Naveen-065/Evaluation_Research_Boards-/api_v1/README.md

# Scan-Debug Cell API

This package exposes a reusable Python API and CLI for cell-level scan-debug read, set, reset, and cycle operations.

All source files needed to set up the FPGA, DAC/ADC Teensy, Saleae capture host, and local summarizer are included under:

[prerequisites](./prerequisites)

The API keeps the experiment behavior used in the recent stair-pulse runs:

- every packet programs the FPGA bitstream for the selected cell and mode;
- FPGA asserts Caravel reset before sending the packet;
- read verification uses `Vcc_set=0.5 V`, `Vcc_wl_set=2.5 V` by default;
- set uses `OP_SET=1` and ramps rails until read current crosses the set threshold;
- reset/read polarity uses `OP_SET=0` and ramps rails until read current crosses the reset threshold;
- Saleae A12-A13 is treated as the set shunt current through `shunt_ohms`, default `470 ohms`.

## Realtime GUI

The repo includes a local browser GUI for watching scan-debug runs in realtime. It reads the same `api_v1/runs/*/manifest.csv` files that the API writes, so it can be started while another API command is already running in the background.

Start the GUI from the repo root:

```bash
python api_v1/gui/server.py
```

Then open:

```text
http://127.0.0.1:8765
```

Use the GUI to see:

- the latest API manifest rows as they are recorded;
- a 32 by 32 1Kbit heatmap of the most recent read-packet current value for each cell;
- the last recorded read-packet current and selected cell;
- a blinking marker on the cell currently being read or programmed;
- rising/falling current trends from read packets as records arrive.

By default the GUI is view-only and does not start hardware actions. To also control API commands from the browser, start it with command controls enabled:

```bash
python api_v1/gui/server.py --allow-commands
```

In command-control mode, the GUI can launch `read`, `set`, `reset`, and `cycle` commands through `api_v1/scan_debug_cli.py`. Existing background API processes are not stopped by the GUI; new commands should only be started when the bench is ready for another operation.

## Where This API Runs

The API can run on any macOS, Ubuntu, or Windows PC, but only if that PC can reach the lab hardware control computers over the network.

The API runner is not the timing source. It only orchestrates the experiment. The actual timing-critical scan-debug waveform is generated by the FPGA, and the current/timing capture is done by the Saleae host.

Current lab roles:

| Role | Default host | What it controls |
|---|---|---|
| API runner | your local PC or remote PC | starts read/set/reset commands |
| Zynq/Vivado PC | `geethika@100.116.216.70` | builds/programs AX7020/Zynq FPGA over JTAG |
| Saleae/Teensy Ubuntu PC | `ubuntu-24-04@100.98.132.51` | runs Logic 2 automation and talks to DAC/ADC Teensy |
| Hardware bench | physically connected in lab | Caravel, FPGA, Saleae, DAC/ADC Teensy, shunts |

If the API is run from a new PC outside the lab, that PC must first join the same private network as the two control hosts. The current IPs are private Tailscale-style addresses, so they will not work from the public internet unless the PC is on that same VPN/private network.

## If The User Has Their Own Hardware

The API also supports a user-owned bench. In that case the user does not need the lab Tailscale hosts. They must provide equivalent local or LAN-accessible control machines for these two jobs:

| Job | Requirement |
|---|---|
| FPGA programming | PC with Vivado and JTAG access to the AX7020/Zynq board |
| Capture and rails | PC with Saleae Logic 2 automation running, DAC/ADC Teensy connected, and the Saleae helper script installed |

The Caravel board, FPGA, Saleae, shunts, and DAC/ADC Teensy must be physically wired as described in [Voltage and Probe Connections](#voltage-and-probe-connections). The API cannot discover or compensate for different wiring automatically.

Supported user-owned topologies:

1. **All hardware controlled from one Ubuntu PC**

   Use local execution for both FPGA and Saleae/Teensy by passing empty hosts:

   ```bash
   python api_v1/scan_debug_cli.py read --row 1 --col 0 \
     --zynq-host "" \
     --saleae-host "" \
     --zynq-os posix \
     --zynq-dir /path/to/zynq_scan_debug \
     --vivado-cmd vivado \
     --saleae-dir /path/to/saleae-api \
     --adc-dac-port /dev/serial/by-id/<teensy-port>
   ```

2. **FPGA on one PC, Saleae/Teensy on another PC on the same LAN**

   Replace the default lab hosts with the user's own SSH targets:

   ```bash
   python api_v1/scan_debug_cli.py read --row 1 --col 0 \
     --zynq-host user@zynq-vivado-pc \
     --saleae-host user@saleae-ubuntu-pc \
     --zynq-os windows \
     --zynq-dir C:/path/to/zynq_scan_debug \
     --saleae-dir /path/to/saleae-api
   ```

3. **Lab hardware over Tailscale/private VPN**

   Use the default hosts documented below, but only after joining the same private network.

For a new user-owned bench, copy the files from [prerequisites](./prerequisites) to the corresponding FPGA, Teensy, and Saleae machines first. Then run the dry-run command, verify SSH/local paths, and only then run hardware commands.

## New Remote PC Quick Start

Use this when the user has a fresh remote PC and does not know the lab network setup.

1. Install the required local tools on the API runner PC.

   Ubuntu:

   ```bash
   sudo apt update
   sudo apt install -y git python3 python3-venv openssh-client rsync
   ```

   macOS:

   ```bash
   xcode-select --install
   brew install rsync
   ```

   Windows:

   ```powershell
   winget install Git.Git
   winget install Python.Python.3.12
   ```

   On Windows, use Git Bash or PowerShell. Install `rsync` through Git Bash/MSYS2 if hardware capture copy is needed from Windows.

2. Connect the API runner PC to the lab private network.

   The control hosts use private VPN-style addresses:

   ```text
   100.116.216.70   Windows/Zynq/Vivado PC
   100.98.132.51    Ubuntu/Saleae/Teensy PC
   ```

   These are not normal public internet addresses. If `ping` or `ssh` cannot reach them, install and log in to the lab VPN/Tailscale account first. After joining the network, verify:

   ```bash
   ping 100.116.216.70
   ping 100.98.132.51
   ```

3. Verify SSH access from the API runner PC.

   ```bash
   ssh geethika@100.116.216.70
   ssh ubuntu-24-04@100.98.132.51
   ```

   Recommended: configure SSH keys. Password mode requires `expect` on Ubuntu/macOS
   and Paramiko on Windows.

   Password automation for the Zynq host can be used with a command-line flag:

   ```bash
   --zynq-password <zynq-password>
   ```

   Or set the password in your shell for the current terminal session:

   ```bash
   export SCAN_DEBUG_ZYNQ_PASSWORD='<zynq-password>'
   ```

   After that, hardware commands can omit `--zynq-password`:

   ```bash
   python api_v1/scan_debug_cli.py read --row 1 --col 0
   ```

   On Windows, install the API dependency before using `--zynq-password`:

   ```powershell
   python -m pip install -r api_v1/requirements.txt
   ```

4. Clone this API repo on the API runner PC.

   ```bash
   git clone <repo-url>
   cd Evaluation_Research_Boards-
   ```

5. Run a no-hardware dry run first.

   ```bash
   python api_v1/scan_debug_cli.py read --row 1 --col 0 --dry-run
   ```

   Expected packet:

   ```text
   0x0401
   ```

6. Check the remote hardware hosts are prepared.

   On the Zynq/Vivado PC, this directory must contain the FPGA files:

   ```text
   C:/Users/geethika/zynq_scan_debug
   ```

   On the Ubuntu Saleae host, Logic 2 automation must be running and the Saleae helper must be present:

   ```text
   /home/ubuntu-24-04/saleae-api/run_fpga_scan0000_la12_15_capture.py
   ```

7. Run a hardware read only after the network and hosts are verified.

   Zynq password automation example:

   ```bash
   python api_v1/scan_debug_cli.py read --row 1 --col 0 --zynq-password <zynq-password>
   ```

   SSH-key example:

   ```bash
   python api_v1/scan_debug_cli.py read --row 1 --col 0
   ```

## Authentication and Local Configuration

Do not commit passwords or private keys to this repository. Use SSH keys when possible, or set credentials as environment variables on the API runner PC.

The CLI reads these environment variables when matching command-line flags are not provided:

| Environment variable | Matching flag | Default |
|---|---|---|
| `SCAN_DEBUG_ZYNQ_HOST` | `--zynq-host` | `geethika@100.116.216.70` |
| `SCAN_DEBUG_ZYNQ_PASSWORD` | `--zynq-password` | empty |
| `SCAN_DEBUG_ZYNQ_OS` | `--zynq-os` | `windows` |
| `SCAN_DEBUG_ZYNQ_DIR` | `--zynq-dir` | `C:/Users/geethika/zynq_scan_debug` |
| `SCAN_DEBUG_VIVADO_CMD` | `--vivado-cmd` | `C:/Xilinx/Vivado/2019.1/bin/vivado.bat` |
| `SCAN_DEBUG_SALEAE_HOST` | `--saleae-host` | `ubuntu-24-04@100.98.132.51` |
| `SCAN_DEBUG_SALEAE_DIR` | `--saleae-dir` | `/home/ubuntu-24-04/saleae-api` |
| `SCAN_DEBUG_SALEAE_RESTART_SCRIPT` | `--saleae-restart-script` | `./start-logic2-automation.sh` |
| `SCAN_DEBUG_SALEAE_RESTART_WAIT_SECONDS` | `--saleae-restart-wait-seconds` | `10` |
| `SCAN_DEBUG_DISABLE_SALEAE_USB_RECOVERY` | `--disable-saleae-usb-recovery` | `0` |
| `SCAN_DEBUG_SALEAE_USB_CONTROLLER_PCI` | `--saleae-usb-controller-pci` | `0000:00:0c.0` |
| `SCAN_DEBUG_SALEAE_SUDO_PASSWORD` | `--saleae-sudo-password` | empty |
| `SCAN_DEBUG_ADC_DAC_PORT` | `--adc-dac-port` | `/dev/serial/by-id/usb-Teensyduino_USB_Serial_8829000-if00` |
| `SCAN_DEBUG_DISABLE_DAC_TEENSY_REFLASH` | `--disable-dac-teensy-reflash` | `0` |
| `SCAN_DEBUG_DAC_TEENSY_APP_SERIAL` | `--dac-teensy-app-serial` | `8829000` |
| `SCAN_DEBUG_DAC_TEENSY_BOOTLOADER_SERIAL` | `--dac-teensy-bootloader-serial` | `000D78D4` |
| `SCAN_DEBUG_DAC_TEENSY_LOADER` | `--dac-teensy-loader` | `/home/ubuntu-24-04/teensy-tools-src/teensy_loader_cli_serial/teensy_loader_cli` |
| `SCAN_DEBUG_DAC_TEENSY_MCU` | `--dac-teensy-mcu` | `TEENSY41` |
| `SCAN_DEBUG_DAC_TEENSY_HEX` | `--dac-teensy-hex` | `/home/ubuntu-24-04/teensy-flash/build-DAC_analog_vltgs/DAC_analog_vltgs.ino.hex` |

macOS/Linux example:

```bash
export SCAN_DEBUG_ZYNQ_PASSWORD='<zynq-password>'
python api_v1/scan_debug_cli.py read --row 1 --col 0
```

Windows PowerShell example:

```powershell
$env:SCAN_DEBUG_ZYNQ_PASSWORD = '<zynq-password>'
python api_v1/scan_debug_cli.py read --row 1 --col 0
```

For persistent local settings, store these exports in a local shell profile or an untracked `.env` file. The repository ignores `.env`, `.env.*`, and generated `api_v1/runs/` captures.

## Network Troubleshooting

If a new PC cannot run the API against hardware, check in this order:

1. Can it reach the private network?

   ```bash
   ping 100.116.216.70
   ping 100.98.132.51
   ```

2. Can it SSH to both hosts?

   ```bash
   ssh geethika@100.116.216.70 hostname
   ssh ubuntu-24-04@100.98.132.51 hostname
   ```

3. Can it copy files from the Saleae host?

   ```bash
   rsync --version
   ssh ubuntu-24-04@100.98.132.51 'ls /home/ubuntu-24-04/saleae-api'
   ```

4. Is Logic 2 automation listening on the Ubuntu host?

   ```bash
   ssh ubuntu-24-04@100.98.132.51 'ss -ltnp | grep 10430 || true'
   ```

   If the capture log shows `Connection refused`, `failed to connect to all addresses`,
   or `DeviceSetupFailure`, the API treats Logic 2 automation as crashed or wedged and
   runs the Saleae restart script before the next capture retry. The default restart
   command is:

   ```bash
   ssh ubuntu-24-04@100.98.132.51 'cd /home/ubuntu-24-04/saleae-api && ./start-logic2-automation.sh'
   ```

5. Is the DAC/ADC Teensy visible on Ubuntu?

   ```bash
   ssh ubuntu-24-04@100.98.132.51 'ls -l /dev/serial/by-id/ | grep Teensy || true'
   ```

   If all USB devices disappear from Ubuntu while VirtualBox still shows passthrough,
   the guest xHCI controller may have wedged. Capture retries automatically reset the
   configured xHCI PCI device, restart Logic 2 automation, and retry when logs show a
   missing Teensy serial path, missing Saleae, `LIBUSB_ERROR_BUSY`, or xHCI failure.
   For password-based sudo recovery from the GUI, launch the GUI/API with:

   ```bash
   export SCAN_DEBUG_SALEAE_SUDO_PASSWORD='<ubuntu-sudo-password>'
   ```

   If the DAC/ADC Teensy is still visible but rail writes fail with
   `SerialTimeoutException: Write timeout`, the API treats the DAC Teensy firmware or
   CDC endpoint as wedged. It reflashes only the DAC Teensy by matching app serial
   `8829000` and bootloader serial `000D78D4`, runs a two-command rail smoke test,
   and retries the capture. This is separate from the xHCI recovery above because the
   USB device can be present while serial writes are still broken.

6. Is Vivado/JTAG working on the Zynq PC?

   ```bash
   ssh geethika@100.116.216.70 'cd C:/Users/geethika/zynq_scan_debug && powershell -NoProfile -Command "Test-Path C:/Xilinx/Vivado/2019.1/bin/vivado.bat"'
   ```

## Python

```python
from api_v1 import ScanDebugCellAPI

api = ScanDebugCellAPI()
read = api.read(row=5, col=0)
set_summary = api.set_cell(row=5, col=0)
reset_summary = api.reset_cell(row=5, col=0)
```

## CLI

Dry-run command, safe on Windows or Ubuntu:

```bash
python api_v1/scan_debug_cli.py read --row 5 --col 0 --dry-run
```

Hardware-backed set sweep:

```bash
python api_v1/scan_debug_cli.py set --row 5 --col 0 \
  --set-vcc-set 1.6,2.0,2.3,2.4,2.5,2.8 \
  --set-vcc-wl-set 0.5,0.6,0.7,0.8,0.9,1.0,1.1,1.2,1.3,1.4,1.5,1.6,1.7,1.8,1.9,2.0 \
  --set-threshold 200.0
```

Hardware-backed reset sweep:

```bash
python api_v1/scan_debug_cli.py reset --row 5 --col 0 \
  --reset-vcc-set 3.3,3.4,3.5,3.6,3.7 \
  --reset-vcc-wl-set 1.0,1.2,1.4,1.6,1.8,2.0,2.2,2.3 \
  --reset-threshold 130.0
```

Default 32 by 32 array read:

```bash
python api_v1/scan_debug_cli.py read-array
```

This uses column-by-column burst mode by default. For each column, the API programs one FPGA sequence bitstream, the FPGA sends all row packets for that column with a Caravel reset before every packet, and the Saleae helper captures one continuous trace for the whole column. The helper then decodes all packet/current windows into the normal `manifest.csv`, so the GUI heatmap updates after each column.

One-shot full-array burst is still available from the CLI:

```bash
python api_v1/scan_debug_cli.py read-array --array-mode burst
```

Prebuild and cache all column-burst FPGA bitstreams into the tracked bitstream folder:

```bash
python api_v1/scan_debug_cli.py build-array-bitstreams
```

Old per-cell behavior is still available:

```bash
python api_v1/scan_debug_cli.py read-array --array-mode serial
```

The older Saleae rearm/export loop can also be used with the burst-column FPGA sequence:

```bash
python api_v1/scan_debug_cli.py read-array --burst-capture-strategy per-cell --burst-repeat-cycles 10000000
```

Full burst mode supports the full 32 by 32 array and publishes after final decode. Serial mode publishes after each individual cell read.

## Cross-Platform Notes

The API itself is pure Python and runs on macOS, Ubuntu, or Windows. Hardware access uses external tools:

- `ssh` and `rsync` must be available on the machine running the API.
- For Windows Zynq programming, the remote side uses PowerShell plus Vivado.
- For Ubuntu/local Zynq programming, set `--zynq-os posix`.
- Prefer SSH keys or an existing SSH agent.
- `--zynq-password ...` uses `expect` on Ubuntu/macOS and Paramiko on Windows. SSH keys remain recommended.
- Remote Saleae captures use `rsync` when it is on `PATH`, with an automatic `scp` fallback (including Windows OpenSSH).

## Required Files

FPGA files copied into this API folder:

- [prerequisites/fpga_zynq7020/caravel_scan_debug_fpga.v](./prerequisites/fpga_zynq7020/caravel_scan_debug_fpga.v)
- [prerequisites/fpga_zynq7020/caravel_scan_debug_fpga.xdc](./prerequisites/fpga_zynq7020/caravel_scan_debug_fpga.xdc)
- [prerequisites/fpga_zynq7020/program_scan_debug_zynq7020.tcl](./prerequisites/fpga_zynq7020/program_scan_debug_zynq7020.tcl)
- [prerequisites/fpga_zynq7020/program_prebuilt_bitstream.tcl](./prerequisites/fpga_zynq7020/program_prebuilt_bitstream.tcl)
- [prerequisites/fpga_zynq7020/bitstreams](./prerequisites/fpga_zynq7020/bitstreams) contains backed-up `.bit` files for reboot recovery.

Teensy DAC/ADC firmware copied into this API folder:

- [prerequisites/teensy_dac_adc/DAC_analog_vltgs.ino](./prerequisites/teensy_dac_adc/DAC_analog_vltgs.ino)
- [prerequisites/teensy_dac_adc/DAC_read.h](./prerequisites/teensy_dac_adc/DAC_read.h)
- [prerequisites/teensy_dac_adc/MovingAverageFilter.h](./prerequisites/teensy_dac_adc/MovingAverageFilter.h)
- [prerequisites/teensy_dac_adc/ads12xx.h](./prerequisites/teensy_dac_adc/ads12xx.h)
- [prerequisites/teensy_dac_adc/sync_slave.ino](./prerequisites/teensy_dac_adc/sync_slave.ino)

Saleae Ubuntu capture helper:

- [prerequisites/saleae_ubuntu/run_fpga_scan0000_la12_15_capture.py](./prerequisites/saleae_ubuntu/run_fpga_scan0000_la12_15_capture.py)
- [prerequisites/saleae_ubuntu/run_full_array_burst_capture.py](./prerequisites/saleae_ubuntu/run_full_array_burst_capture.py)

Local summarizer used by the API:

- [tools/summarize_capture.py](./tools/summarize_capture.py)

## Setup Checklist

1. Copy FPGA prerequisite files to the Zynq/Vivado working directory.

   Default API path:

   ```text
   C:/Users/geethika/zynq_scan_debug
   ```

   Required files in that directory:

   ```text
   caravel_scan_debug_fpga.v
   caravel_scan_debug_fpga.xdc
   program_scan_debug_zynq7020.tcl
   ```

   The API generates per-packet Vivado build TCL files and bitstreams in this same directory.

2. Flash the DAC/ADC Teensy with:

   ```text
   prerequisites/teensy_dac_adc/DAC_analog_vltgs.ino
   ```

   Keep the companion headers/sketch files in the same Arduino sketch folder.

3. Copy the Saleae helper to the Ubuntu Saleae API directory.

   Default API path:

   ```text
   /home/ubuntu-24-04/saleae-api/run_fpga_scan0000_la12_15_capture.py
   ```

   Required Ubuntu Python packages/environment:

   ```text
   saleae automation package
   pyserial
   rsync
   ssh server/client
   existing caravel utility environment, if HK reset mode is used
   ```

4. Start Logic 2 automation on Ubuntu before running hardware commands.

   The API expects Logic automation listening on:

   ```text
   127.0.0.1:10430
   ```

5. Confirm the DAC/ADC Teensy serial path.

   Default API path:

   ```text
   /dev/serial/by-id/usb-Teensyduino_USB_Serial_8829000-if00
   ```

   Override with:

   ```bash
   --adc-dac-port /dev/serial/by-id/...
   ```

## Voltage and Probe Connections

Rails controlled by the DAC/ADC Teensy firmware:

| Rail | Caravel/Chip node | DAC channel in current firmware | API default / behavior |
|---|---:|---:|---|
| `Vcc_read` | GPIO33 | DAC[0] | held `0 V` in `SCAN_CUSTOM_RAILS` |
| `Vcc_wl_read` | GPIO26 | DAC[1] | held `0 V` in `SCAN_CUSTOM_RAILS` |
| `Vcc_set` | GPIO27 | DAC[6] | ramped by API |
| `Vcc_wl_set` | GPIO30 | DAC[3] | ramped by API |
| `Vcc_wl_reset` | GPIO28 | DAC[4] | held `0 V` in `SCAN_CUSTOM_RAILS` |
| `Vcc_reset` | VDDA2 | DAC[5] | held `0 V` in `SCAN_CUSTOM_RAILS` |
| `VDDA1` | VDDA1 | DAC[14] / external supply as configured | not changed by API |
| `VDDC2` | VCCD2 | DAC[15] | not changed by API |

Current probes:

| Measurement | Saleae analog channels | Shunt |
|---|---:|---:|
| Set shunt current | A12 - A13 | default `470 ohms` |
| Reset shunt current | A14 - A15 | default `470 ohms` |
| ADC set monitor | A0 - A1 | firmware monitor |
| ADC read monitor | A2 - A3 | firmware monitor |
| ADC reset monitor | A4 - A5 | firmware monitor |

FPGA to Caravel and Saleae digital probes:

| Signal | Caravel node | FPGA J10 / Zynq pin | Saleae LA |
|---|---|---|---:|
| `wb_clk_i` / XCLK | Xclk | J10-16 / U14 | 8 |
| `rst_b` | Reset | J10-3 / W19 | 7 |
| `ready` | GPIO1 | J10-4 / W18 | 6 |
| `TM` | GPIO36 | J10-5 / R14 | 9 |
| `ScanInDR` | GPIO21 | J10-9 / W15 | 11 |
| `ScanInDL` | GPIO22 | J10-7 / Y17 | 10 |
| `ScanInCC` | scan clock/control | J10-8 / Y16 | optional |

The FPGA RTL changes scan data/control on the falling edge of `wb_clk_i`. Caravel samples on the rising edge.

## Packet Format

Packets are encoded as:

```text
{OP_SET, SL_SEL[4:0], BL_SEL[4:0], WL_SEL[4:0]}
```

The present hardware mapping uses `row -> SL_SEL/WL_SEL` and `col -> BL_SEL`.

Examples:

- cell `(1,0)` read: `0x0401`
- cell `(4,0)` read: `0x1004`
- cell `(10,10)` read: `0x294a`
- cell `(5,0)` set: `0x9405`
