Naveen-065/Evaluation_Research_Boards-/FMC_Eval_Board/output/j2_clock_50mhz/J2_50MHz_clock_report.html

# Existing J2 clock circuit at 1.8 V and 50 MHz

Clock-only conclusion: no solder changes are required to create a plausible bench-test configuration. Keep C60, C61 and R165. Drive J2 D8 with a 50 MHz LVCMOS18 clock and J2 D9 actively LOW. Configure the ADC differential clock receiver. This supersedes the earlier claim that C60 must be rewired or an external LVDS driver is always needed.

Simulation supports a candidate, not a verified working board. 225 completed ngspice sensitivity runs; numerical checks passed: True. No Kintex IBIS or ADC comparator/PLL model was available. Some assumed line/startup cases exceed ADC voltage limits, so this is not unconditional connection approval. The clock input, 300 MHz return clock, 600 Mbit/s data and remaining power/I2C faults still need validation.

BOM checked inside the original ZIP: jlcpcb/production_files/BOM-CaravelReRAM-SenseEval.csv line 28 lists C60/C61 as LCSC C49062, Samsung CL03A104KP3NNNC, 100 nF, 10 V, X5R, +/-10%, 0201. Line 48 lists R165 as LCSC C25076, UNI-ROYAL 0402WGF1000TCE, 100 ohms, +/-1%, 0402. These procurement values match the simulation; the physical assembly has not been inspected. The BOM uses footprint names in its Comment column, so part numbers were checked against the supplier catalog.

## Existing copper and configuration

FPGA AE23 / J2 D8 ---+--- C61 100 nF --- ADC U14.58 CLKP
                    |
                 R165 100 ohms
                    |
FPGA AF23 / J2 D9 ---+--- C60 100 nF --- ADC U14.59 CLKN
  driven LOW

ADC DIFF_CLK=1: each clock pin has internal 5 kohm bias to about 1.5 V.

The low-driven D9 supplies the reference through C60. It has finite output impedance, so R165 causes some CLKN ripple. D9 must not be left floating. These are two ordinary LVCMOS18 output buffers, not a native LVDS output.

1. Set and verify KC705 VADJ at 1.8 V. XDC does not set the physical rail.
2. Use LVCMOS18 on both outputs. DRIVE=24 is supported by the HR bank. SLEW=SLOW is an initial bench choice; the generic simulation is not tied to a Vivado DRIVE/SLEW setting.
3. ADC register 0x42=0x8001 with other fields default selects DIFF_CLK=1. 0x8003 also enables duty-cycle correction. Default DIFF_CLK=0 is unsuitable with this AC-coupled topology.
4. Hold the clock LOW until both boards and the ADC configuration are ready. Then start continuous 50 MHz clocking. Allow approximately 5 ms for nominal AC-bias settling before evaluating capture; verify actual settling.

Illustrative integration files: ODDR/OBUF Verilog and clock-only XDC fragment. These are not compiled or timing-closed complete designs.

## Nominal simulation results

Model: ideal 1.8 V source, 25 ohms resistance per FPGA output, 1 ns transitions, 100 nF coupling, 5 kohm ADC bias to 1.5 V, assumed 5 pF per ADC input, no transmission line in this table. The 25 ohms value is illustrative; it does not represent a verified DRIVE=24 buffer.

Case | Differential LOW / HIGH plateaus | CLKP range | CLKN range
Keep PCB; D9 actively LOW | -0.598 / 0.598 V | 0.753 to 2.247 V | 1.351 to 1.649 V
Keep PCB; D9 floating | -0.020 / 0.020 V | 0.609 to 2.391 V | 0.626 to 2.374 V
Remove R165 only; D9 actively LOW | -0.895 / 0.896 V | 0.605 to 2.396 V | 1.500 to 1.500 V

With the existing circuit, the simple resistor calculation gives 12 mA through R165 during the high half-cycle and about 1.2 V peak-to-peak differential clock. The unattenuated static upper bound at 1.89 V and 99 ohms is about 19.1 mA. DRIVE is not a current limiter; transient currents differ.

Floating D9 can produce impressive-looking edge spikes while the settled differential plateaus approach zero. Peak-to-peak amplitude alone must not be interpreted as valid clock drive.

Three simulated clock topologies comparing ADC input and differential waveforms

## Startup, pauses and line sensitivity

With 100 nF and 5 kohms, the nominal bias time constant is about 0.5 ms. Short steady-state simulations use analytically initialized capacitor charges. Separate runs model the first edges after a long LOW or HIGH pause. They do not simulate the board power sequence or claim the bias settles in 420 ns.

Generic sweeps use output resistance 10/25/60 ohms, supply 1.71/1.89 V, bias 1.425/1.575 V, and additional assumed 50-ohm line ladders with 0.5/1.5 ns delay, 0.5/2 ns edges and 2 ohms total trace loss. These are sensitivity ranges, not vendor PVT corners.

Topology | Model group | Lowest CLKP | Highest CLKP
existing_low | lumped_sensitivity | -0.350 V | 3.350 V
existing_low | assumed_line_sensitivity | -0.946 V | 3.921 V
remove_r165 | lumped_sensitivity | -0.461 V | 3.461 V
remove_r165 | assumed_line_sensitivity | -1.787 V | 4.788 V

Do not treat these extreme hypothetical numbers as predictions of the PCB. They expose why driver and routing information matter. Compare measured clock pins with their voltage limits throughout start/stop. Removing R165 increases clock amplitude and can worsen ringing and restart excursions; removal is not automatically safer or necessary.

## Minimum physical work for the complete interface

Clock path: zero changes for the first controlled trial. The complete FMC interface is a separate matter. At VCCO=1.8 V, use LVDS_25 input receivers with DIFF_TERM=FALSE and external receiver termination. The five data pairs and two returned-clock pairs need their 100-ohm termination solution. PCB pad connectivity confirms each receive net connects only U14 and J9, with no resistor pads. R165 does not terminate those signals. Put the termination at the FPGA receiving end; a resistor placed arbitrarily far away on the card is not equivalent.

Retain the earlier power audit requirements: NT25 must not join the independently powered 3.3 V regulators; management I2C remains a 3.3 V bus; verify U18/pullup corrections and avoid driving an unpowered FPGA. This clock analysis does not clear these issues or the incomplete FMC ground returns.

## Bench acceptance sequence

1. With both boards disconnected and unpowered, confirm C60/C61 and R165 population and the independent power/I2C corrections. Verify external return-pair terminations.
2. Verify the KC705 1.8 V startup setting with the card disconnected. Use the full audited power sequence; mate only with both boards unpowered.
3. With both sides valid, set DIFF_CLK=1, hold D9 LOW, then start D8 clock. Begin at 10 MHz if desired, then test the requested 50 MHz.
4. Probe CLKP and CLKN at the ADC with suitable low-capacitance probes. Do not attach a 50-ohm scope input directly to either ADC clock pin. Record startup, steady state, stop and restart; examine each pin and their difference, duty cycle, and extra zero crossings.
5. ADC absolute digital-input limits are -0.3 V to min(3.9 V, AVDD+0.3 V); stay comfortably inside, including ringing. These are damage limits, not a functional clock guarantee. A 1.2 Vpp result is a model expectation, not a prescribed acceptance threshold.
6. After bias settling, check the ADC output test pattern and frame alignment. At 50 MSPS the returned LCLK is 300 MHz and each serialized channel is 600 Mbit/s. Verify error-free capture for the application and sweep phase/timing margins; decimation follows capture.
7. Then compare a known analog input before/after decimation for noise and distortion. SPICE here cannot predict clock jitter or final SNR.

## Evidence and reproducibility

- TI ADS5282, pages 3, 23 and 35 (https://www.ti.com/lit/ds/symlink/ads5282.pdf): clock modes and internal bias.
- AMD DS182, Table 9 (https://docs.amd.com/v/u/en-US/ds182_Kintex_7_Data_Sheet): LVCMOS18 HR 24 mA drive option.
- AMD UG471 (https://docs.amd.com/v/u/en-US/ug471_7Series_SelectIO): input-only LVDS at other VCCO, termination requirements.
- LCSC C49062 capacitor (https://www.lcsc.com/product-detail/C49062.html); LCSC C25076 resistor (https://www.lcsc.com/product-detail/C25076.html): resolution of BOM part-number values.
- All numerical results and assumptions; summary CSV; simulation script; netlists/ and logs/ contain every case.
- Clock sources are ideal 0-VCCO square waves with 1ns edges unless stated.
- FPGA pull-up and pull-down represented by fixed resistances; not mapped to DRIVE settings.
- ADC differential clock mode modeled as 5k bias per leg; capacitance assumed 5pF.
- C60/C61 assumed 100nF; R165 assumed 100ohm, per schematic intent.
- No ADC threshold/comparator/PLL model, noise, jitter, clamp, thermal or package model.
- Some tests add assumed uncoupled 50ohm LC line ladders with 2ohm total trace loss, not extracted routing.
- Initial capacitor charges describe periodic steady state or long settled idle.
- No valid conversion, firmware capture or fabricated-board safety guarantee follows.

Run UTC: 2026-10-17T18:13:35.819303+00:00. Source PCB SHA256: fdca0330dc568658c43d27be3abe488d13d14b2eec15ef8ff8d3f24107006200. Source design and physical hardware were not changed.
