Naveen-065/Evaluation_Research_Boards-/FMC_Eval_Board/output/adc_lvds_10msps/input_clock/input_clock_comparison.png

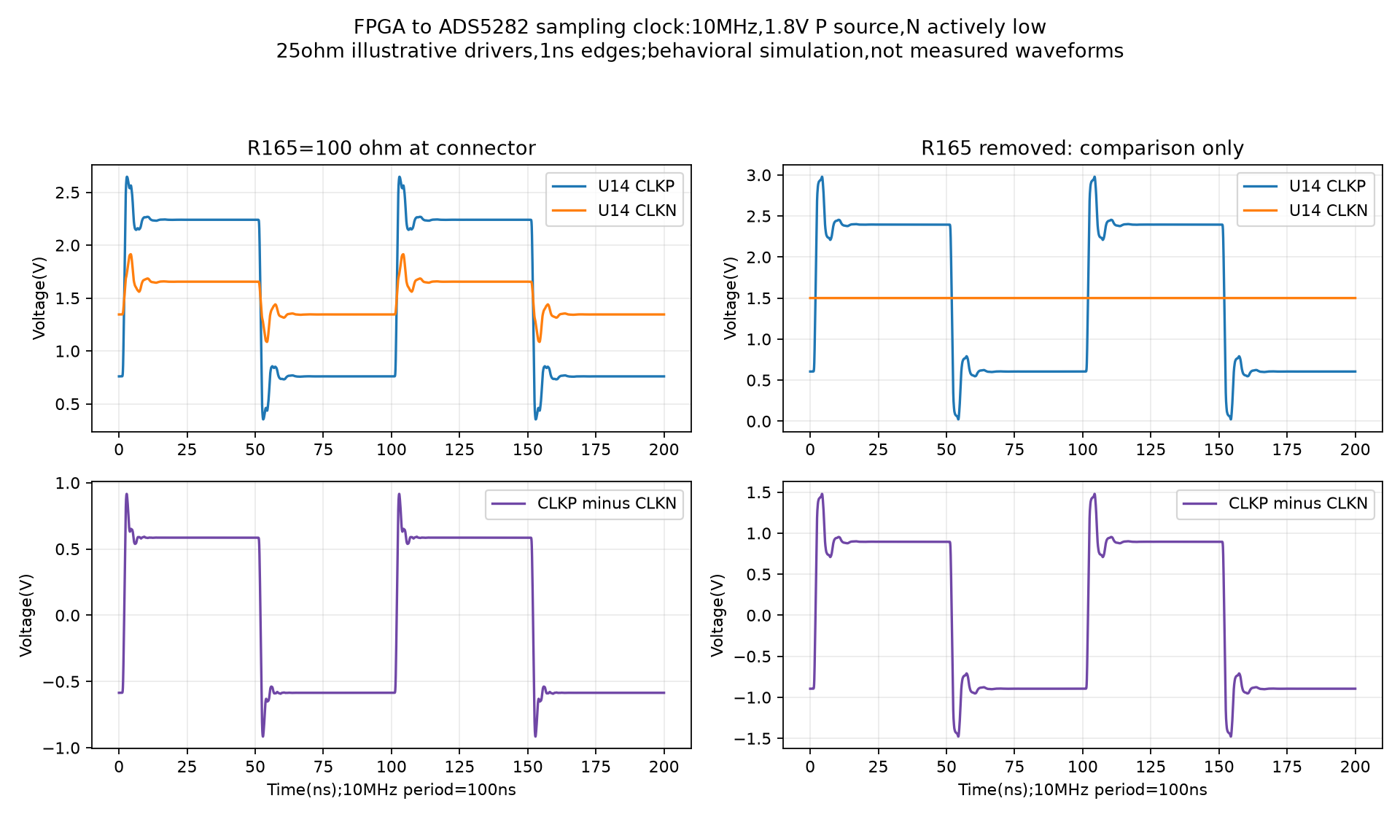
FMC_Eval_Board/output/adc_lvds_10msps/input_clock/input_clock_comparison.png
