Naveen-065/Evaluation_Research_Boards-/FMC_Eval_Board/output/adc_lvds_10msps/termination_comparison.png

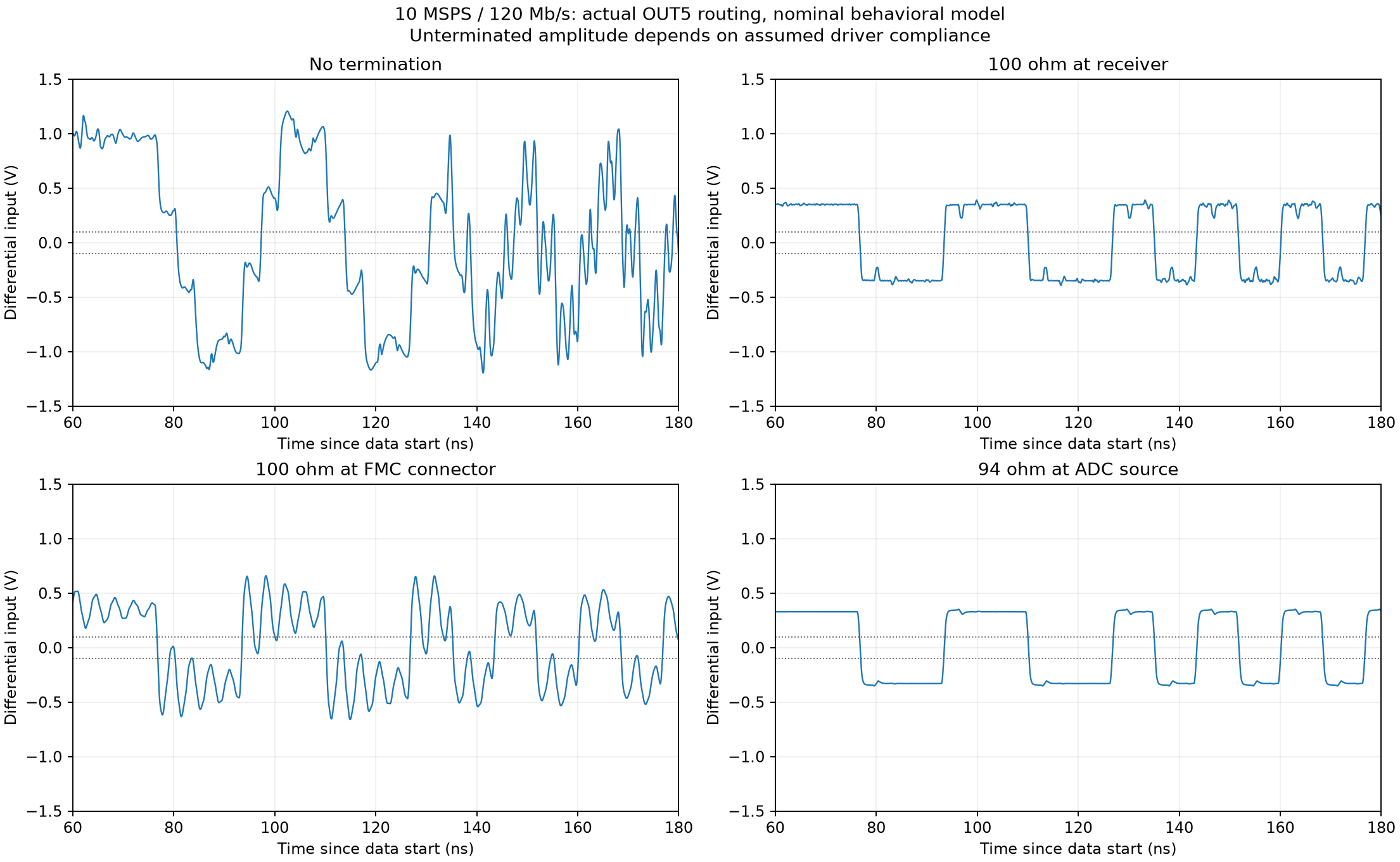
FMC_Eval_Board/output/adc_lvds_10msps/termination_comparison.png
