Naveen-065/Evaluation_Research_Boards-/FMC_Eval_Board/output/ain1_r9_validation/u10_schematic.png

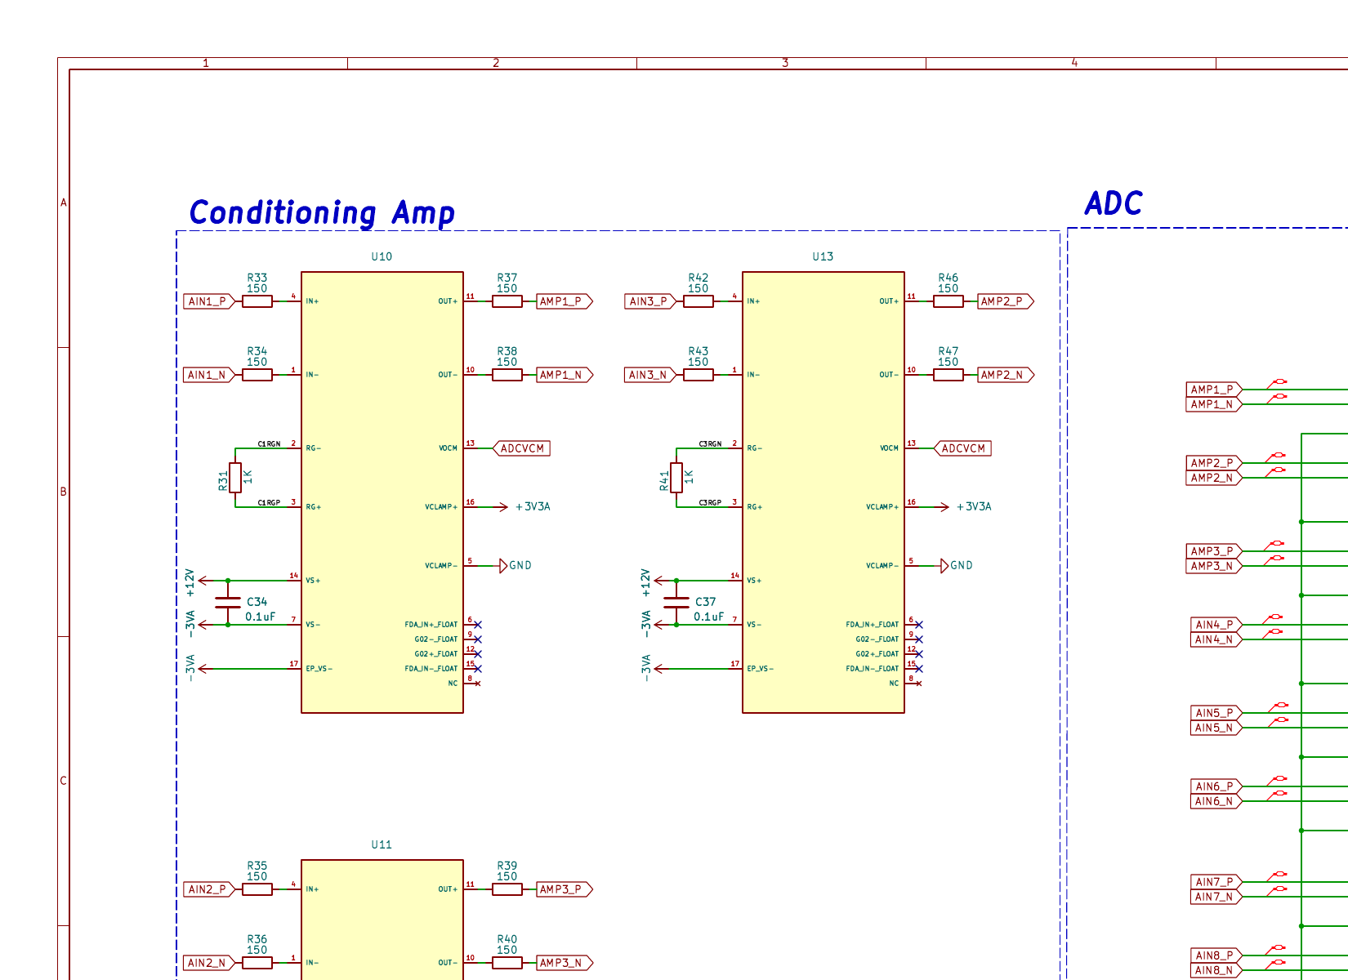
FMC_Eval_Board/output/ain1_r9_validation/u10_schematic.png
