Naveen-065/Evaluation_Research_Boards-/FMC_Eval_Board/output/dac_reference_audit/u1_reference_layout.png

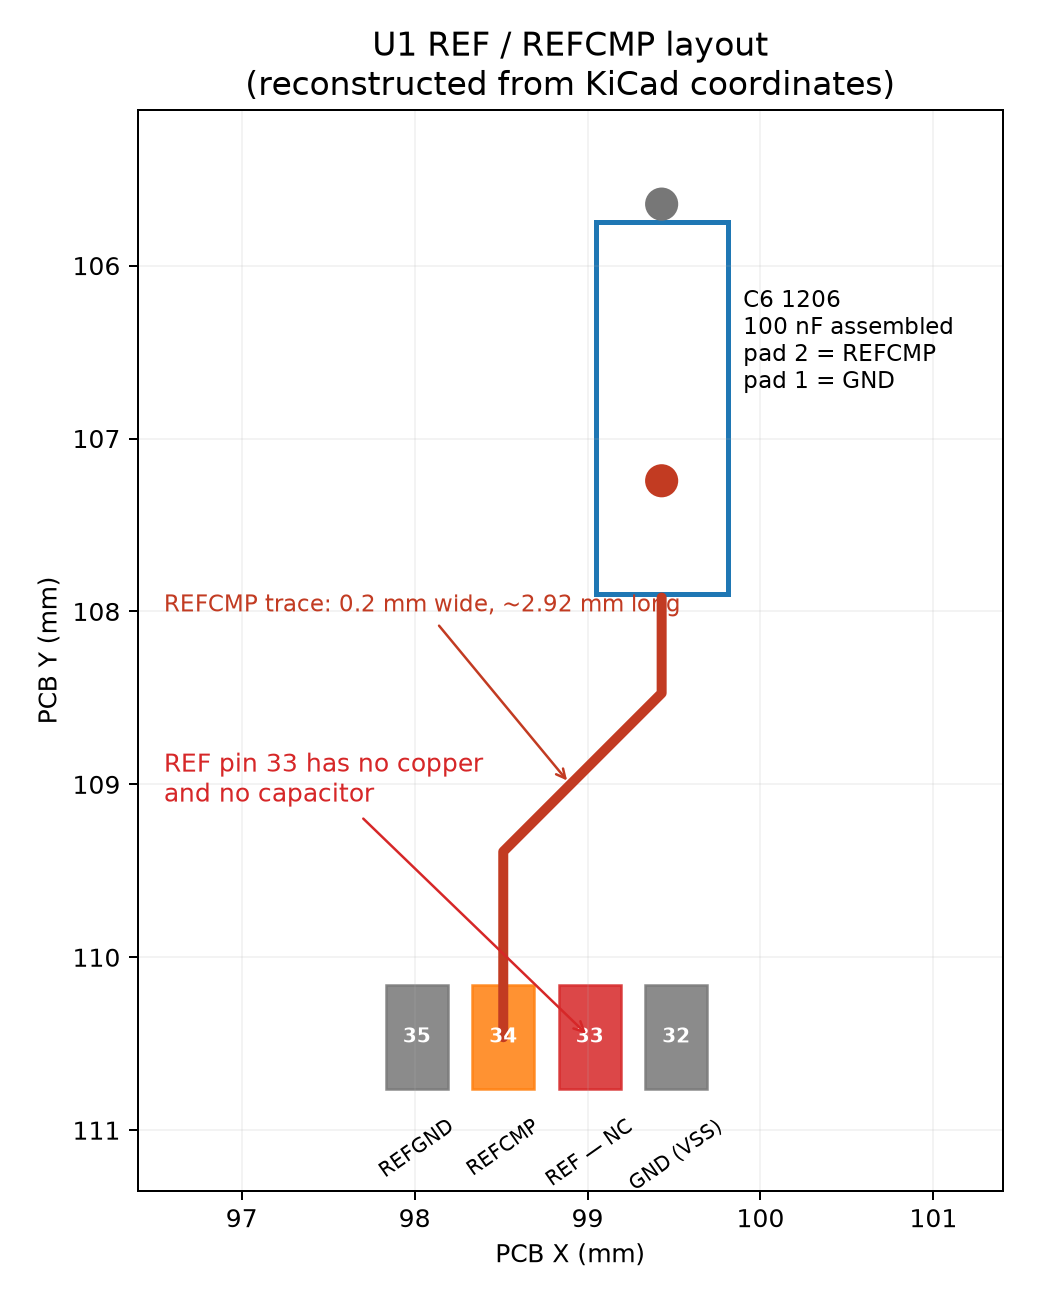
FMC_Eval_Board/output/dac_reference_audit/u1_reference_layout.png
