Naveen-065/Evaluation_Research_Boards-/FMC_Eval_Board/output/j9_c30_c31/j9_bottom_full.png

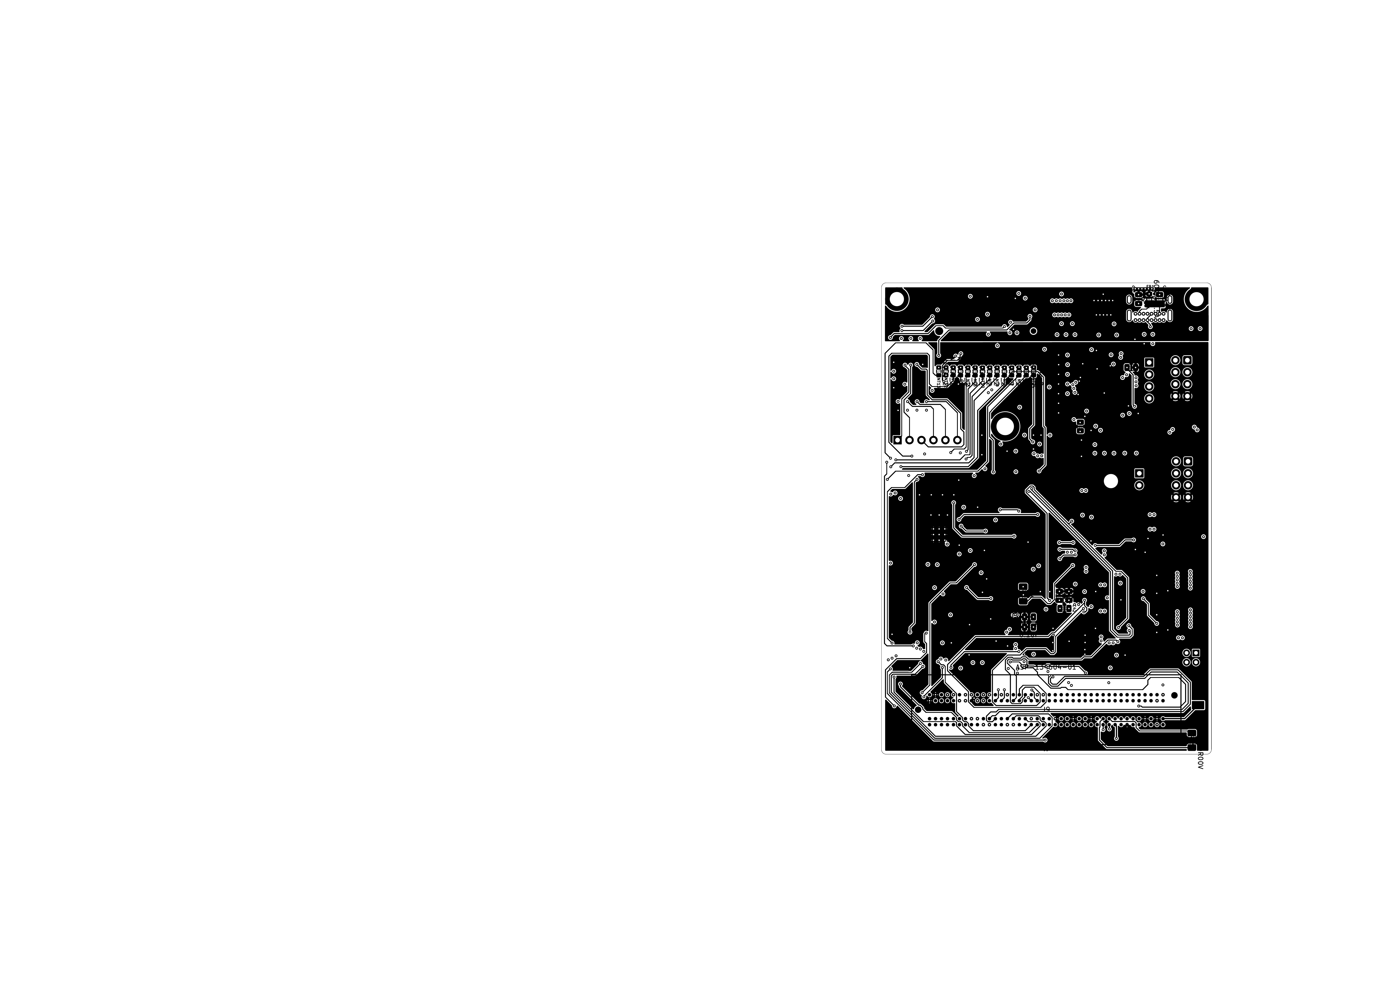
FMC_Eval_Board/output/j9_c30_c31/j9_bottom_full.png
