Naveen-065/Evaluation_Research_Boards-/FMC_Eval_Board/output/j9_c30_c31/J9_C30_C31_annotated.png

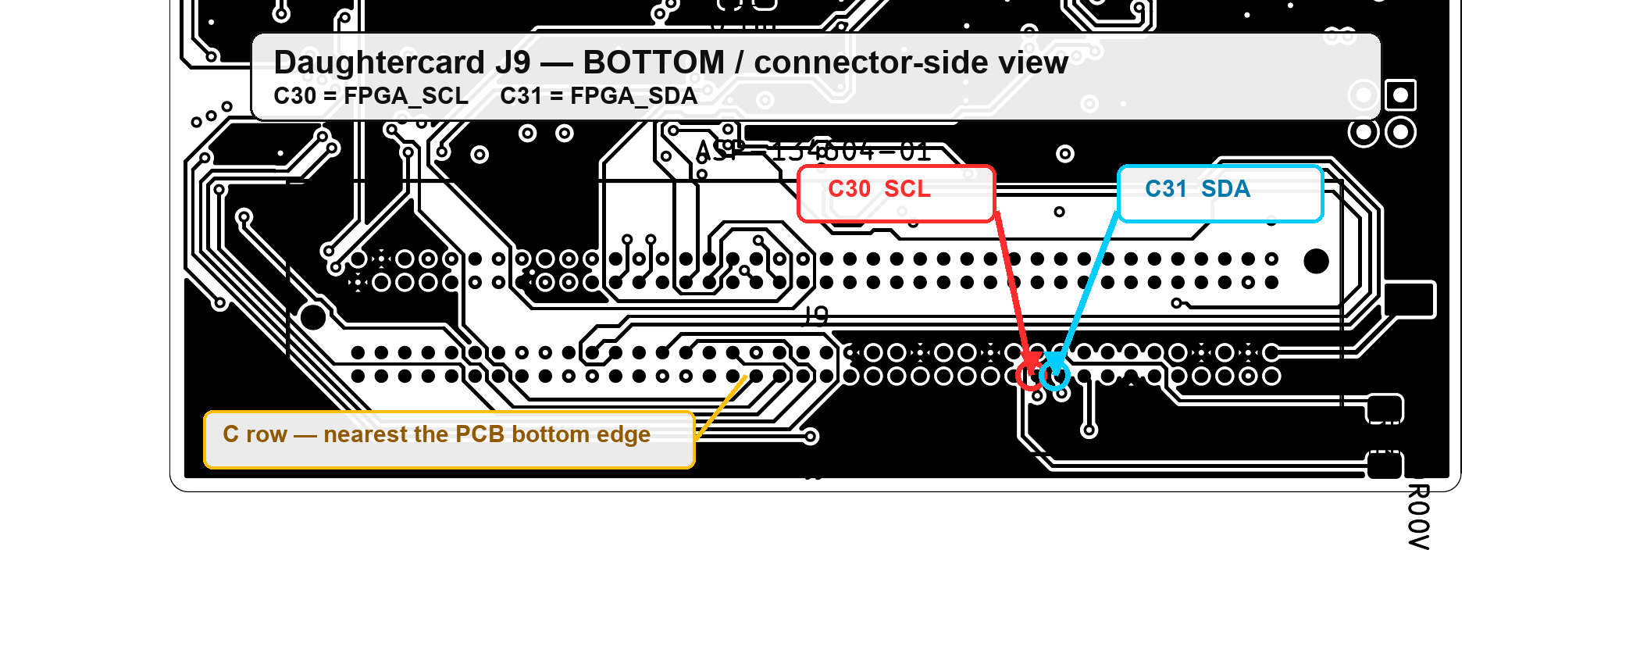
FMC_Eval_Board/output/j9_c30_c31/J9_C30_C31_annotated.png
