Naveen-065/Evaluation_Research_Boards-/FMC_Eval_Board/output/kc705_cell_control/evidence/final_fixed_mode_gui.png

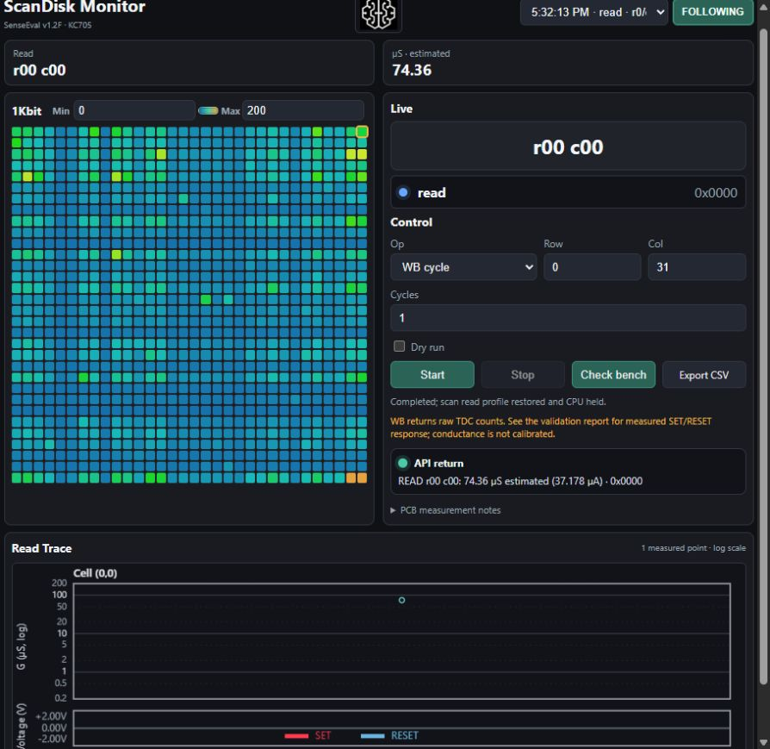
FMC_Eval_Board/output/kc705_cell_control/evidence/final_fixed_mode_gui.png
