Naveen-065/Evaluation_Research_Boards-/FMC_Eval_Board/output/kc705_cell_control/evidence/gui_reference_match.jpg

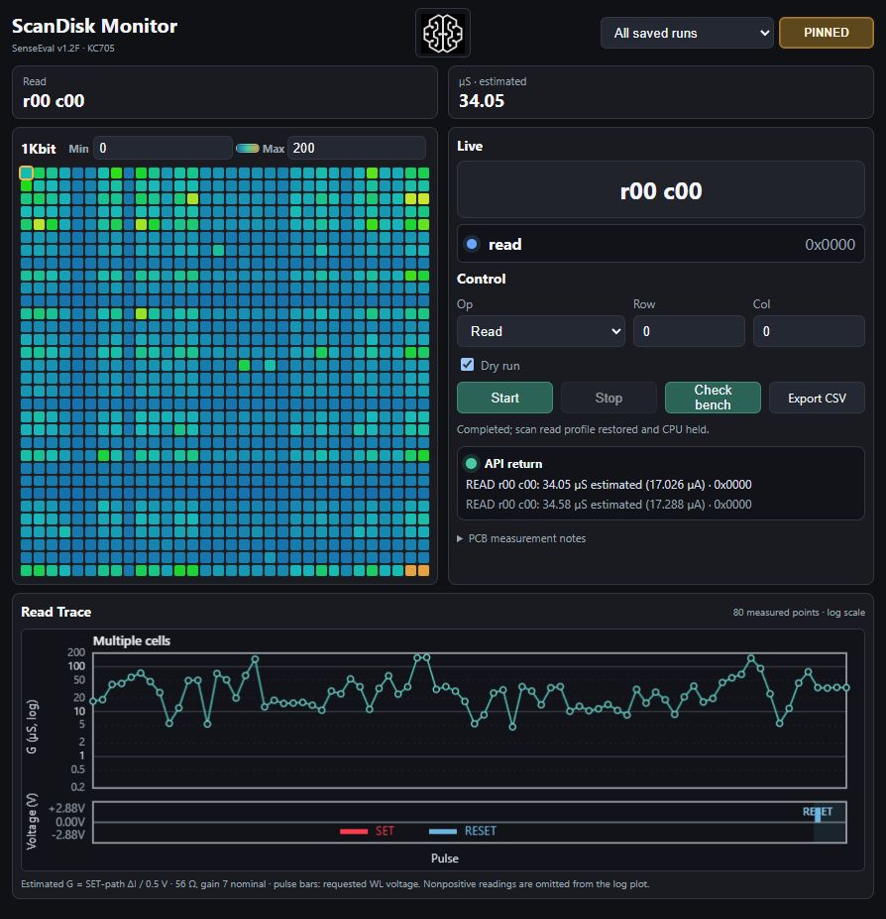
FMC_Eval_Board/output/kc705_cell_control/evidence/gui_reference_match.jpg
