Naveen-065/Evaluation_Research_Boards-/FMC_Eval_Board/output/kc705_cell_control/evidence/scan_ramp_cycle_gui.png

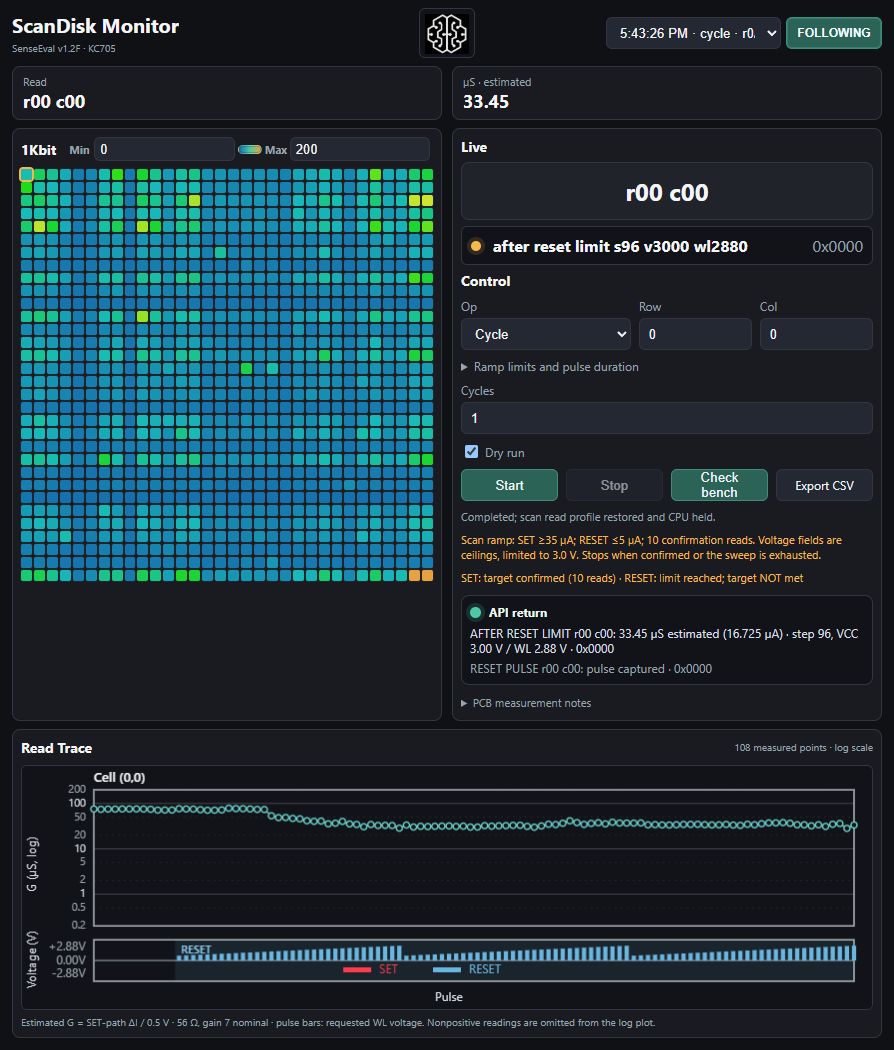
FMC_Eval_Board/output/kc705_cell_control/evidence/scan_ramp_cycle_gui.png
