Naveen-065/Evaluation_Research_Boards-/FMC_Eval_Board/output/kc705_scan_read/evidence/ui.png

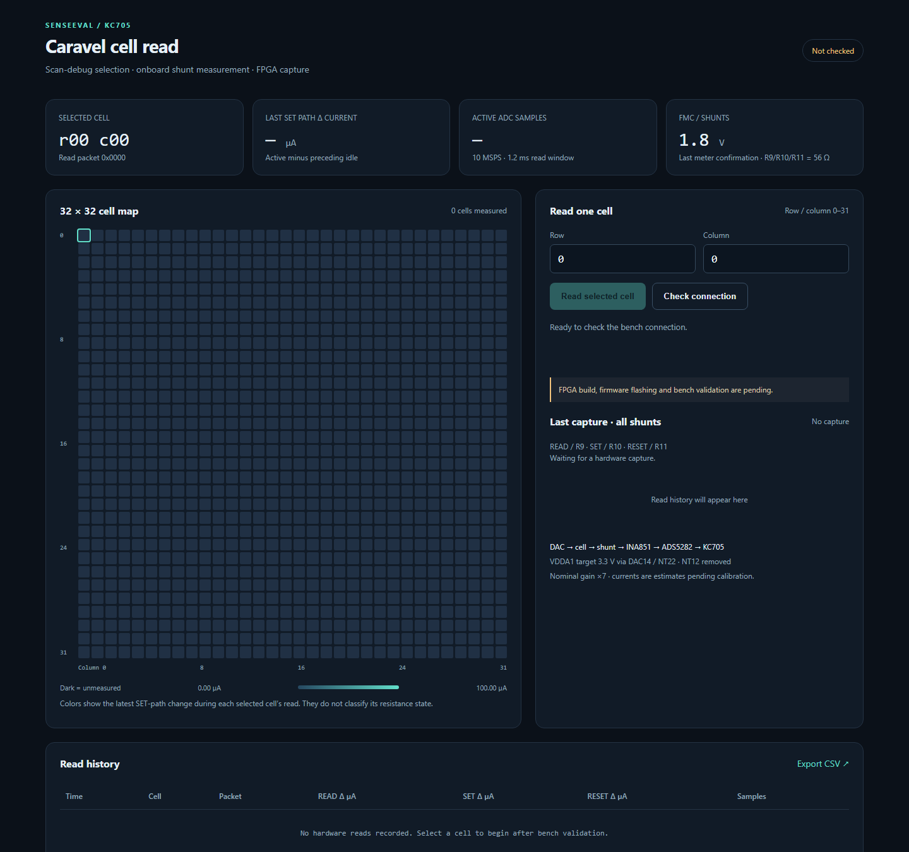
FMC_Eval_Board/output/kc705_scan_read/evidence/ui.png
