Naveen-065/Evaluation_Research_Boards-/FMC_Eval_Board/output/kc705_si5351/kc705_j2_official_pinout.png

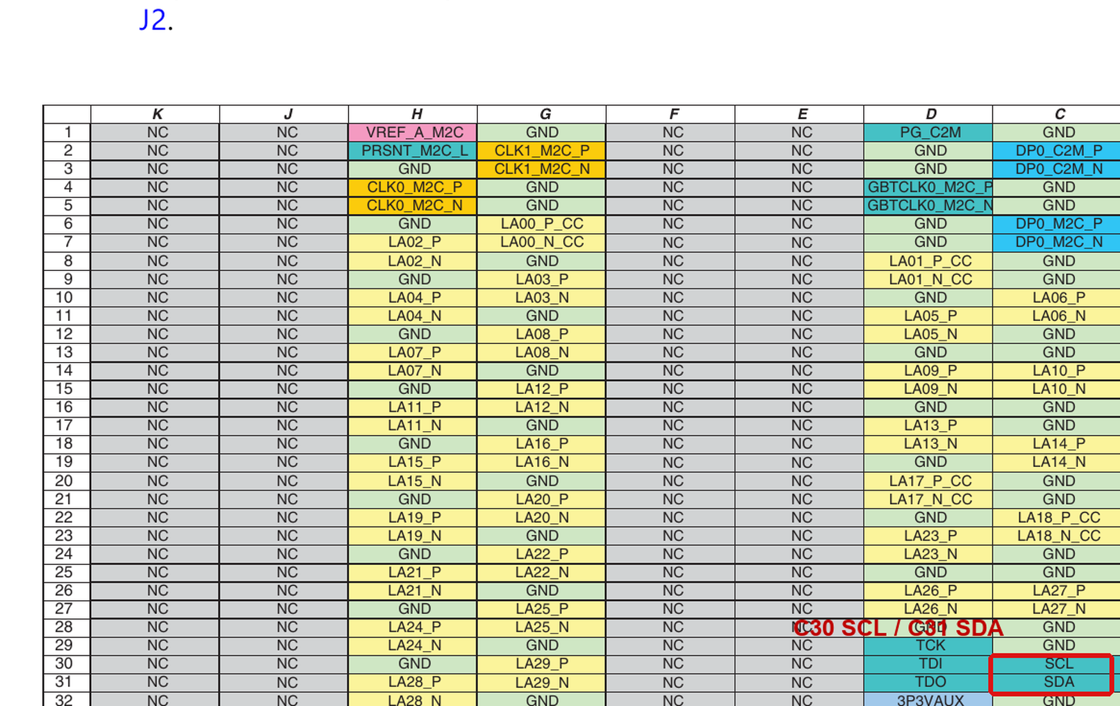
FMC_Eval_Board/output/kc705_si5351/kc705_j2_official_pinout.png
