Naveen-065/Evaluation_Research_Boards-/FMC_Eval_Board/zcu106/kc705_cell_control/output/plots/latest_lrs_hrs_conductance_distribution.png

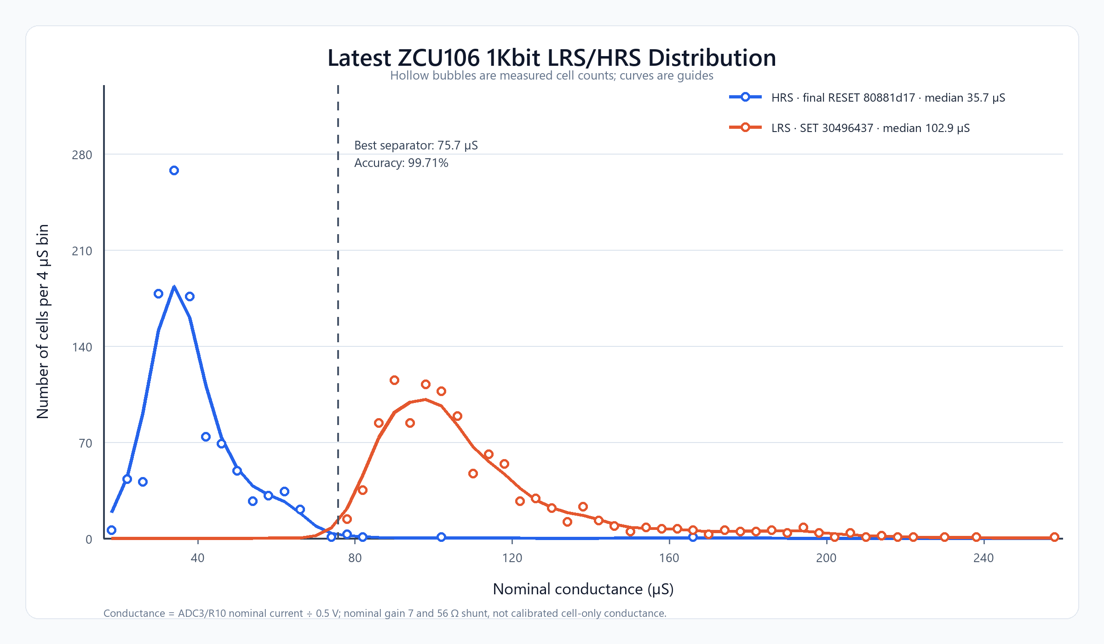
FMC_Eval_Board/zcu106/kc705_cell_control/output/plots/latest_lrs_hrs_conductance_distribution.png
