Naveen-065/Evaluation_Research_Boards-/FMC_Eval_Board/zcu106/kc705_cell_control/output/plots/latest_set_reset_programming_voltage.png

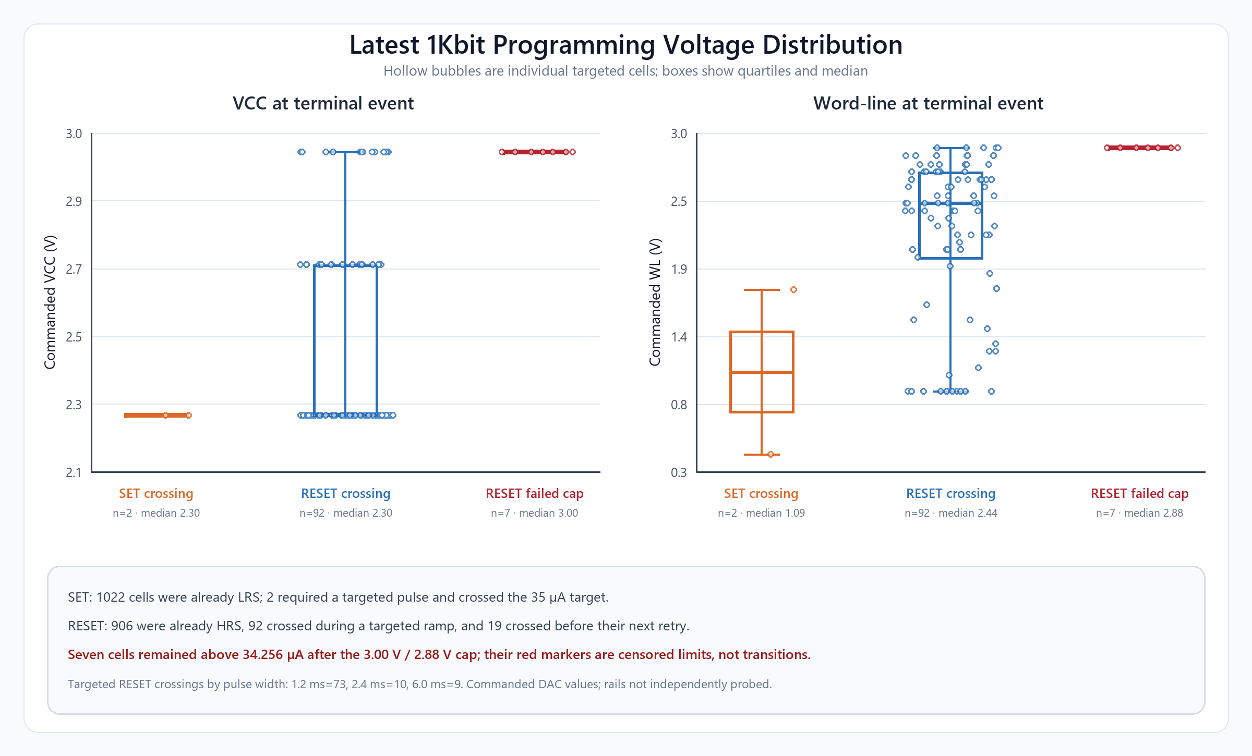
FMC_Eval_Board/zcu106/kc705_cell_control/output/plots/latest_set_reset_programming_voltage.png
