Naveen-065/Evaluation_Research_Boards-/FMC_Eval_Board/zcu106/kc705_cell_control/output/plots/lrs_hrs_1kbit_conductance_distribution.png

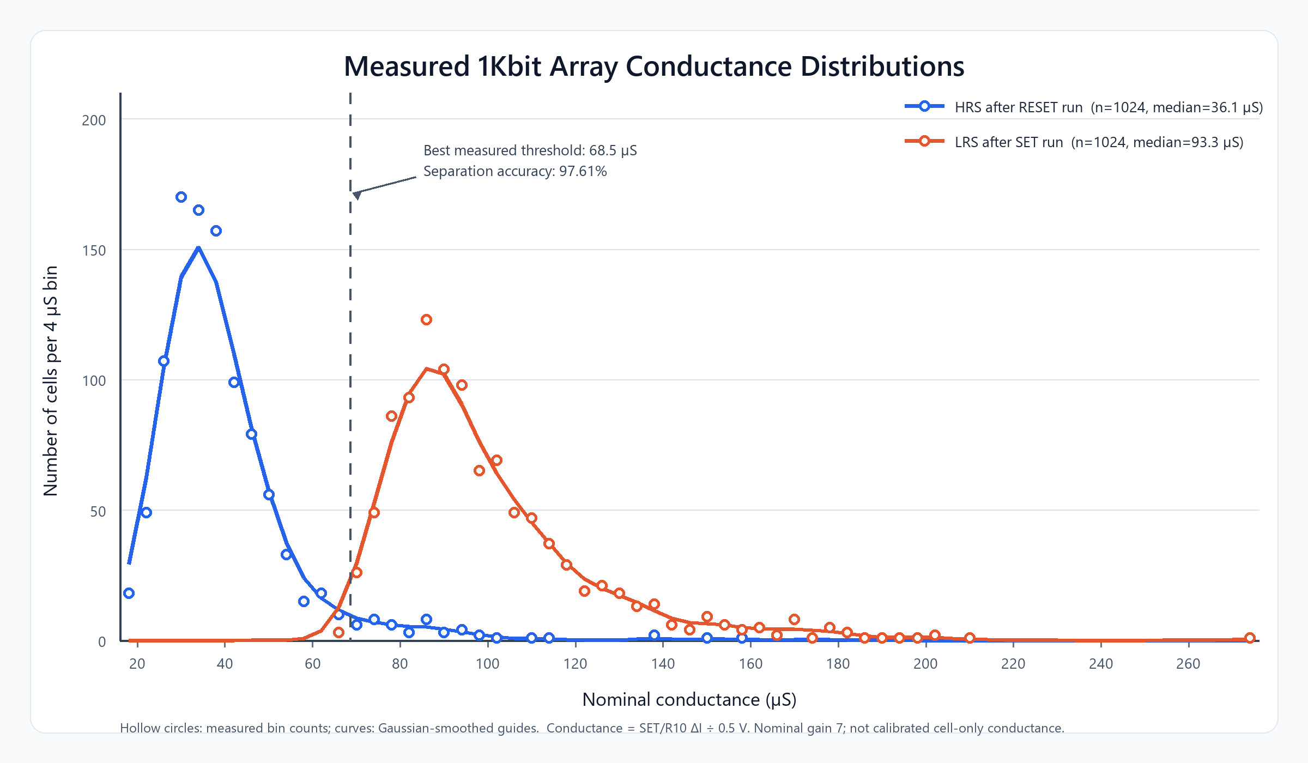
FMC_Eval_Board/zcu106/kc705_cell_control/output/plots/lrs_hrs_1kbit_conductance_distribution.png
