Naveen-065/Evaluation_Research_Boards-/FMC_Eval_Board/zcu106/kc705_cell_control/output/plots/set_reset_transition_saturation_voltage_boxplots.png

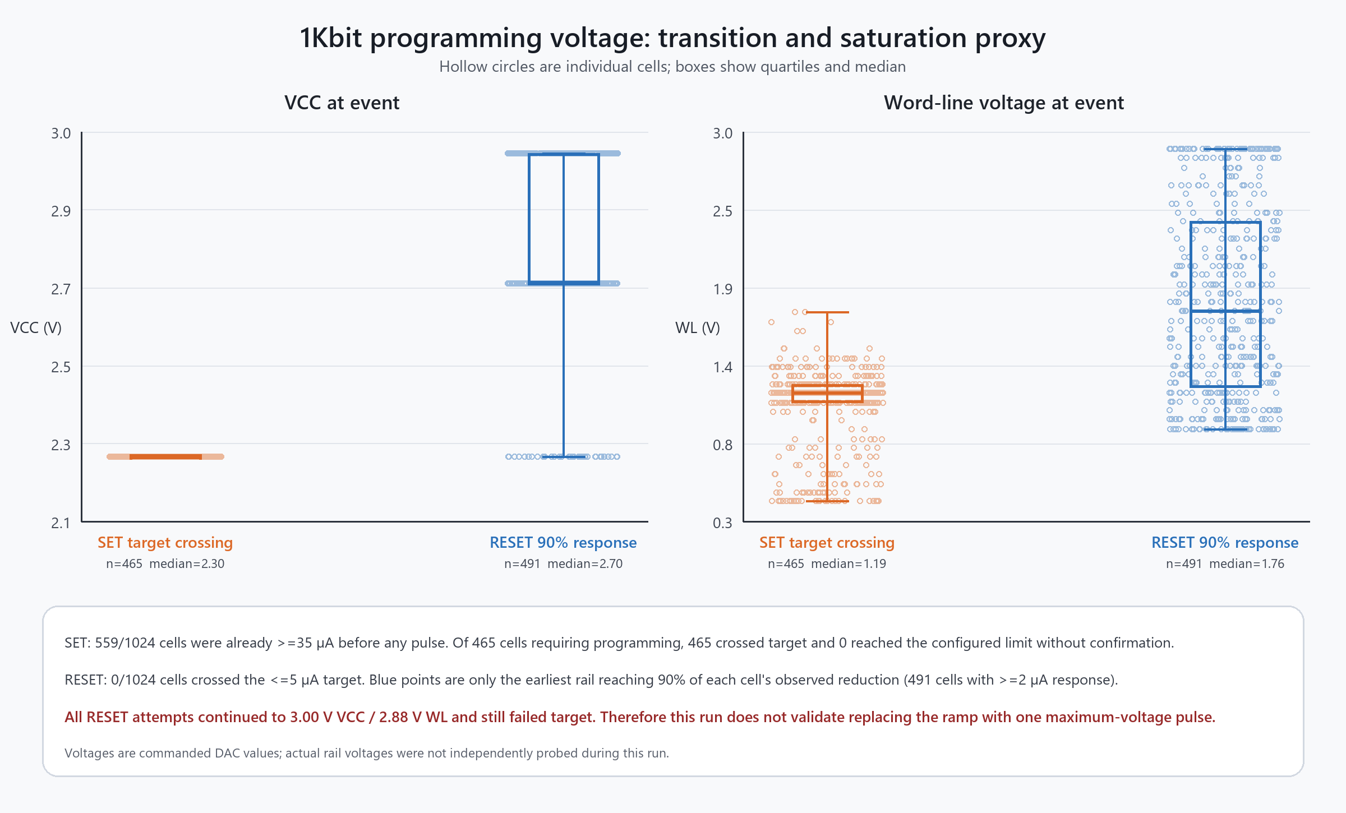
FMC_Eval_Board/zcu106/kc705_cell_control/output/plots/set_reset_transition_saturation_voltage_boxplots.png
