Naveen-065/Evaluation_Research_Boards-/FMC_Eval_Board/hardware/CaravelReRAM-SenseEval_v1.2F/jlcpcb/production_files/BOM-CaravelReRAM-SenseEval.csv

Comment | Designator | Footprint | LCSC | Quantity
0 | R61 | R_0805_2012Metric | C17477 | 1
0.01uF | C12,C19,C31 | C_0805_2012Metric | C1710 | 3
0.1uF | C10,C11,C13,C14,C15,C16,C17,C20,C27,C29,C32,C34,C35,C37,C40,C42,C43,C44,C45,C47,C49,C50,C53,C55,C56,C57,C58 | C_0805_2012Metric | C1711 | 27
100k | R45 | R_0805_2012Metric | C149504 | 1
100nF | C1,C2,C3,C4,C5,C6 | C_1206_3216Metric | C97946 | 6
10K | R15,R21,R22,R23,R26,R27,R28,R29,R30,R49,R50,R51,R52,R53,R54,R55,R56,R57,R58,R59,R60,R64,R65 | R_0805_2012Metric | C17414 | 23
10k | R1,R2,R3,R4,R5,R6,R7,R8 | R_0805_2012Metric | C17414 | 8
10uF | C18,C21,C23,C25,C26,C28,C30,C39,C41,C46,C48,C51,C52,C54 | C_0805_2012Metric | C15850 | 14
12K 1% | R18 | R_0805_2012Metric | C17444 | 1
12MHz | Y1 | Resonator_SMD_Murata_CSTxExxV-3Pin_3.0x1.1mm | C341520 | 1
143k | R44 | R_0805_2012Metric | C2930167 | 1
150 | R19,R20,R33,R34,R35,R36,R37,R38,R39,R40,R42,R43,R46,R47 | R_0805_2012Metric | C17471 | 14
18pF | C22,C24 | C_0805_2012Metric | C527079 | 2
1K | R16,R17,R24,R25,R31,R32,R41,R62 | R_0805_2012Metric | C2907232 | 8
1uF | C33,C36,C59 | C_0805_2012Metric | C28323 | 3
4.7uF | C38 | C_0805_2012Metric | C1779 | 1
434133025816 | SW1 | SW_Push_1P1T_NO_Vertical_Wuerth_434133025816 | C5504987 | 1
470R | R10,R11,R9 | R_Shunt_Vishay_WSK2512_6332Metric_T1.19mm | C7420029 | 3
56.2k | R48 | R_0805_2012Metric | C2933471 | 1
600R/0.5A | FB1 | L_0805_2012Metric | C5523406 | 1
93LCxxBxxOT | U19 | SOT-23-6_Handsoldering | C190271 | 1
ADS5282IRGCR | U14 | Texas_RGC0064B_VQFN-64-1EP_9x9mm_P0.5mm_EP4.25x4.25mm | C2670909 | 1
AMS1117-1.8 | U16,U7 | SOT-223-3_TabPin2 | C7380514 | 2
AMS1117-3.3 | U15,U6 | SOT-223-3_TabPin2 | C6186 | 2
ASP-134604-01 | J9 | Samtec_FMC_ASP-134604-01_4x40_Vertical | C2830435 | 1
CL10C4R7BB8NNNC | C8 | C_0603_1608Metric_Pad1.08x0.95mm_HandSolder | C307509 | 1
C_0201_0603Metric | C60,C61 | C_0201_0603Metric | C49062 | 2
Conn_01x02_Pin | J1 | PinHeader_1x02_P2.54mm_Vertical | C32713268 | 1
Conn_01x04_Pin | J2 | PinHeader_1x04_P2.54mm_Vertical | C52016392 | 1
Conn_01x06_Pin | J5 | PinHeader_1x06_P2.54mm_Vertical | C32713272 | 1
Conn_02x02_Odd_Even | J6 | PinHeader_2x02_P2.00mm_Vertical | C5383103 | 1
Conn_02x04_Odd_Even | J7,J8 | IDC-Header_2x04_P2.54mm_Vertical | C9135 | 2
DAC81416RHAT | U1 | Texas_RHA0040D_VQFN-40-1EP_6x6mm_P0.5mm_EP2.9x2.9mm_ThermalVias | C2680104 | 1
ERA-3AEB2053V | R13 | R_0603_1608Metric_Pad0.98x0.95mm_HandSolder | C22949 | 1
ERJ-8GEY0R00V | R14,R63 | R_1206_3216Metric_Pad1.30x1.75mm_HandSolder | C2907406 | 2
FA-238 25.0000MB-C3 | Y2 | Crystal_SMD_3225-4Pin_3.2x2.5mm_HandSoldering | C70593 | 1
FT232H | U5 | QFN-48-1EP_8x8mm_P0.5mm_EP6.2x6.2mm | C82158 | 1
GRM188R61E475KE11D | C7,C9 | C_0603_1608Metric_Pad1.08x0.95mm_HandSolder | C90057 | 2
INA851RGTR | U10,U11,U13 | VQFN16_RGT_TEX | C5371575 | 3
LM27761 | U12 | Texas_DSG0008A_WSON-8-1EP_2x2mm_P0.5mm_EP0.9x1.6mm | C129351 | 1
M.2-CONNECTOR-E | U9 | M.2-CONNECTOR-E | C2977809 | 1
MBR0530 | D1 | D_SOD-123 | C82046 | 1
MCT06030C1804FP500 | R12 | R_0603_1608Metric_Pad0.98x0.95mm_HandSolder | C13318 | 1
MLZ1608N100LT000 | L1 | L_0603_1608Metric_Pad1.05x0.95mm_HandSolder | C194437 | 1
NetTie_2 | NT1,NT10,NT11,NT12,NT13,NT14,NT15,NT16,NT17,NT18,NT19,NT2,NT20,NT21,NT23,NT24,NT3,NT4,NT5,NT6,NT7,NT8,NT9 | R_0603_1608Metric | C21189 | 23
RED | D2,D3,D4,D5 | LED_1206_3216Metric | C84270 | 4
R_0402_1005Metric | R165 | R_0402_1005Metric | C25076 | 1
SN74LVC1G125DCKR | U3,U4 | Texas_R-PDSO-G5_DCK-5 | C7833 | 2
Si5351A-B-GT | Y3 | MSOP-10_3x3mm_P0.5mm | C504891 | 1
TPS61040DDC | U2 | SOT-23-5 | C2678707 | 1
TXS0108EPW | U17 | TSSOP-20_4.4x6.5mm_P0.65mm | C17206 | 1
USB_C_Receptacle_USB2.0_16P | J3 | USB_C_Receptacle_GCT_USB4085 | C7095263 | 1
VSSOP-8_2.3x2mm_P0.5mm | U18 | VSSOP-8_2.3x2mm_P0.5mm | C33196 | 1
W25Q32FVSS | U8 | SOIC-8_5.3x5.3mm_P1.27mm | C29067 | 1
MICROMOD-Standoff | H2 | MicroMod-Standoff |  | 1
