Naveen-065/Evaluation_Research_Boards-/FMC_Eval_Board/zcu106_qwen_zes_realtime/fpga/zcu106_cell_control/build/port_properties.tsv

PORT | PACKAGE_PIN | IOSTANDARD | DIRECTION | DRIVE | SLEW | DIFF_TERM | PULLTYPE
adc_pd | D17 | LVCMOS18 | OUT | 4 | SLOW | 0
adclk_n | E14 | LVDS | IN |  |  | 0
adclk_p | E15 | LVDS | IN |  |  | 0
aq1_mosi | E17 | LVCMOS18 | OUT | 4 | SLOW | 0
aq1_ncs | J16 | LVCMOS18 | OUT | 4 | SLOW | 0
aq1_nldac | J15 | LVCMOS18 | OUT | 4 | SLOW | 0
aq1_nrst | C16 | LVCMOS18 | OUT | 4 | SLOW | 0
aq1_sck | E18 | LVCMOS18 | OUT | 4 | SLOW | 0
fpga_loe | C17 | LVCMOS18 | OUT | 4 | SLOW | 0
fpga_mclkin_n | H17 | LVCMOS18 | OUT | 12 | SLOW | 0
fpga_mclkin_p | H18 | LVCMOS18 | OUT | 12 | SLOW | 0
fpga_nadcrst | A12 | LVCMOS18 | OUT | 4 | SLOW | 0
fpga_ncs | A13 | LVCMOS18 | OUT | 4 | SLOW | 0
fpga_rx | L15 | LVCMOS18 | IN |  |  | 0
fpga_sck | G18 | LVCMOS18 | OUT | 4 | SLOW | 0
fpga_sdata | F18 | LVCMOS18 | OUT | 4 | SLOW | 0
fpga_tx | K15 | LVCMOS18 | OUT | 4 | SLOW | 0
iic_scl_main | AH19 | LVCMOS12 | INOUT | 4 | SLOW | 0
iic_sda_main | AL21 | LVCMOS12 | INOUT | 4 | SLOW | 0
lclk_n | F16 | LVDS | IN |  |  | 0
lclk_p | F17 | LVDS | IN |  |  | 0
led0 | AL11 | LVCMOS12 | OUT | 4 | SLOW | 0
out1_n | K20 | LVDS | IN |  |  | 0
out1_p | L20 | LVDS | IN |  |  | 0
out2_n | K18 | LVDS | IN |  |  | 0
out2_p | K19 | LVDS | IN |  |  | 0
out3_n | L16 | LVDS | IN |  |  | 0
out3_p | L17 | LVDS | IN |  |  | 0
out4_n | G19 | LVDS | IN |  |  | 0
out4_p | H19 | LVDS | IN |  |  | 0
out5_n | J17 | LVDS | IN |  |  | 0
out5_p | K17 | LVDS | IN |  |  | 0
ready_i | H16 | LVCMOS18 | IN |  |  | 0
reset_b | G16 | LVCMOS18 | INOUT | 4 | SLOW | 0
scan_cc | C12 | LVCMOS18 | OUT | 4 | SLOW | 0
scan_se | G15 | LVCMOS18 | OUT | 4 | SLOW | 0
scan_si | C13 | LVCMOS18 | INOUT | 4 | SLOW | 0
scan_tm | F15 | LVCMOS18 | OUT | 4 | SLOW | 0
si5351_clk1_1v8 | D16 | LVCMOS18 | IN |  |  | 0
sysclk_n | AJ12 | DIFF_SSTL12 | IN |  |  | 0
sysclk_p | AH12 | DIFF_SSTL12 | IN |  |  | 0
