Naveen-065/Evaluation_Research_Boards-/FMC_Eval_Board/output/ain1_r9_validation/comparison_0p47ohm.html

# R9 = 0.470 Ω → U10 gain → ADC1

R9 = 0.470 Ω confirmed by the user. Caravel is removed. Load path: AQ1_C00 → R9 → VCC_READ → 3.3 kΩ → ground. R31's fitted value is still unconfirmed. The earlier 470 Ω assumption came from the schematic label and does not describe this fitted R9.

## Calculation including U10

Using the previous measured source voltage of 0.539 V and the design value R31 = 1 kΩ: INA851 input gain = 1 + 6000/R31 = 7. The PCB leaves G02 pins open, so output-stage gain = 1. Overall differential gain = 7. R33, R34, R37 and R38 are series resistors and do not set this nominal DC gain.

I = 0.539 / (3300 + 0.470) = 163.3101 µA
Vshunt = I × 0.470 = 76.7557 µV
VADC,diff(signal) = 7 × Vshunt = 0.537290 mV
ADC LSB = 2 V / 4096 = 0.48828125 mV
Expected signal increment = 1.100370 counts

The ideal outputs at 1.5 V common mode would be about 1.500269 V and 1.499731 V. Actual offsets can move both these voltages and the ADC baseline.

## ngspice results

TI INA851 PSpice macro-model executed in ngspice 46; an ideal 12-bit, 2 Vpp differential ADC transfer is applied to its output. The gain-7 simulated loaded-minus-unloaded increment is 1.003459 counts. The approximately 0.10-count difference from the ideal formula is model behavior, not a measured hardware calibration.

R31 (Ω) | Gain | Ideal ADC signal (mV) | Ideal increment | ngspice increment
100 | 61 | 4.6821 | 9.5889 | 9.5894
150 | 41 | 3.147 | 6.445 | 6.4453
470 | 13.766 | 1.0566 | 2.1639 | 2.0671
1000 | 7 | 0.53729 | 1.1004 | 1.0035
2000 | 4 | 0.30702 | 0.62878 | 0.53187
6040 | 1.9934 | 0.153 | 0.31335 | 0.21639
10000 | 1.6 | 0.12281 | 0.25151 | 0.25153
Open | 1 | 0.076756 | 0.1572 | 0.15717

These are comparisons, not instructions to replace R31. At this small stimulus, unknown amplifier/ADC offsets and noise prevent establishing actual gain from a single near-midscale capture.

## FPGA evidence

After confirmation that Caravel was removed: 205 coherent packets at 10 MSPS. ADC1 candidate decoded mean = 2053.54634, range 2049–2057, standard deviation = 1.4763 counts. Capture status and cadence checks pass. Serial bit order has not yet been independently validated by a known pattern or sufficiently large known analog signal. This is not a calibrated current measurement.

## Evidence and remaining check

Confirm fitted R31's marking/value to establish intended gain. Direct R9 mV and amplified-output readings are pending. A new loaded DAC voltage measurement is also pending; calculations use the earlier 0.539 V reading.

The assembly BOM associates R9/R10/R11 with C7420029 while labelling them 470R. The selected part is 0.47 Ω (https://www.lcsc.com/product-detail/C7420029.html). Only R9's fitted value is user-confirmed. INA851 gain reference (https://www.ti.com/lit/ds/symlink/ina851.pdf); ADS5282 transfer reference (https://www.ti.com/lit/ds/symlink/ads5282.pdf).

Full simulation and capture record · Archived 470 Ω assumption (not the fitted R9)
