Naveen-065/Evaluation_Research_Boards-/FMC_Eval_Board/output/fmc_verification/KC705_FMC_verification.html

# KC705 FMC pre-connection verification

CaravelReRAM-SenseEval v1.2F • 17 October 2026 • Electrical review and 16 ngspice simulations

Current disposition: do not connect or power the assembled pair yet. Direct DAC I/O is incompatible with KC705 default 2.5 V VADJ. The I²C translator wiring also needs correction or isolation. Fitted NT25 parallels local and carrier 3.3 V supplies. Simulation does not qualify the actual soldered board.

Assembly status: your latest answer was “fitted” to NT25, NT22, R14 and bottom-side 1206 R63. This report provisionally treats all four as installed. NT12, U20’s actual part marking, and the intended external power source remain unconfirmed. Earlier statements that these links were absent must not be used for this power-up.

## Which socket works?

Use J2 LPC after resolving the electrical issues. J9 on this PCB is a 160-contact LPC connector, using C/D/G/H rows. The signal mapping also fits the LPC subset of J22 HPC; it does not need the extra HPC contacts.

KC705 socket | Used ordinary signals | Supply | Conclusion
J2 LPC | All 36 mapped signals in HR bank 12 | Shared VADJ; default 2.5 V | Preferred socket for this card
J22 HPC | Same 36 contacts map to HR bank 16 | Same VADJ | Possible with different FPGA pin constraints; no voltage advantage

Mapping follows AMD UG810 tables 1-28 and 1-29 (https://docs.amd.com/api/khub/documents/g0YC14NTyJ_D9ZQTSmzzWg/content). Mechanical clearance, polarity, connector seating and the actual carrier revision still require inspection. VADJ selection and XDC I/O standards are separate: changing XDC does not change the physical supply.

There is no single VADJ setting that fixes the existing full interface:

- 1.8 V option: direct DAC/TXS CMOS uses LVCMOS18. ADC LVDS reception can use input-only LVDS_25 with DIFF_TERM=FALSE, external 100 Ω at each FPGA receiver, and compliant input levels. The ADC clock must come from an appropriate external source/driver; native HR LVDS_25 output is unavailable at 1.8 V.
- 2.5 V option: native HR LVDS_25 clock output is supported, but every affected 1.8 V CMOS path needs suitable level translation, including power-off behavior. ADC SPI inputs powered from AVDD=3.3 V themselves tolerate 2.5 V; the DAC and TXS A-side are the main conflicts.

See UG471 pp91–93 (https://docs.amd.com/api/khub/documents/IbGcnPFe6eF19RHma_Y~IA/content) and DS182 tables 1, 2 and 12 (https://docs.amd.com/api/khub/documents/BhulK6GRrzUpQYw0lzrnMA/content). Check all other enabled KC705 functions sharing VADJ before changing it.

## Issues to resolve before mating

1. DAC input overvoltage. U1 DAC81416 VIO is +1V8A. FMC G12/G13/H13/H14/H20 directly reach SCLK, SDI, CS, LDAC and RESET. Normal inputs must stay within 0–VIO; absolute limit is VIO+0.3 V, or 2.1 V at nominal VIO. Do not use 2.5 V outputs here. TI DAC81416 ratings (https://www.ti.com/lit/ds/symlink/dac81416.pdf).
2. NT25 ties two 3.3 V sources. Pad 1 is FMC C39 / 3V3FMC; pad 2 is local +3V3 from U6. For independent USB/bench 5 V power, remove/open NT25 and verify isolation before mating. Do not use a fitted link as an improvised power-sharing scheme. The exact regulator reverse current was not modeled.
3. U18 PCA9306 has an incorrect bias connection and incompatible low-side pullups. Actual PCB pin 7 is directly tied to +3V3, pin 2 to +1V8, and pin 8 pulled up through R56=10 kΩ. TI requires a current-limited reference bias; the standard translator circuit ties EN/VREF2 together through a high-value bias resistor. KC705 C30/C31 are a separate 3.3 V I²C bus, regardless of VADJ, while R54/R53 pull them toward 1.8 V. For an initial test without FMC I²C, isolate/remove U18 and R53/R54. Removing U18 alone leaves the conflicting pullups. This also avoids energizing the incorrectly biased translator during standalone tests. A permanent repair must address the voltage domains and bias together; changing only R56 to 200 kΩ is insufficient. See PCA9306 sections 8.1 and 10 (https://www.ti.com/lit/ds/symlink/pca9306.pdf).
4. Check VDDA1 source selection. The actual PCB has NT12 from local +3V3 to vdda1 and NT22 from AQ1_C14 (DAC U1 OUT14, pin 29) to vdda1. If both are fitted, a DAC output and the 3.3 V supply are tied together. Select the intended source, with the other link open; do not rely on the DAC reset state to avoid contention. The DAC powers up with a 10 kΩ output-to-ground path, so both fitted does not necessarily create a hard short at reset, but enabling channel 14 at a different voltage creates source contention. This corrects the earlier PDF-only interpretation of NT12. R14 instead joins boost 12VPWR to local +12V; it does not join the KC705 12 V FMC pins, which are unconnected on this card.
5. Control ownership on shared signals. U17 TXS0108E is enabled by default through R52. Hold its OE low during initial testing and supply ramps. SCAN_SI (C18) is also FT232H ADBUS2, an RTS# output in UART mode; ensure it is an input or isolated before the FPGA drives that signal. RESET_B (D15) is shared with FTDI, the module and a pushbutton to ground. Prevent competing push-pull drivers. Unplugging FTDI USB does not isolate a locally powered FTDI. TXS0108E (https://www.ti.com/lit/ds/symlink/txs0108e.pdf); FT232H table 3.4 (https://ftdichip.com/wp-content/uploads/2024/09/DS_FT232H.pdf).
6. Verify the fitted U20. PCB value is SN74LVC1G125DCKR: pin 1 tied to 3.3 V would hold /OE high and disable the clock output. The PDF instead names SN74AUP1T34, for which those supply pins implement the intended translation. Inspect its marking before expecting a clock at FMC H19. H19 is also an ordinary, not dedicated clock-capable, FPGA input.
7. JTAG and signal returns. Bottom-side 1206 R63 should link FMC D30 TDI to D31 TDO, close to 0 Ω; do not confuse it with top-side 0805 R63, a 10 kΩ EEPROM pullup. Card-present H2 inserts the FMC into KC705’s JTAG path. Only seven standard ground contacts are assigned GND in the supplied PCB (D22/D25/D28/D37/D39/G1/G8); many adjacent return contacts are unconnected. C34 is GA0 and H2 is presence, not ordinary ground returns. C32 is a standard ground contact but is wired through R55=10 kΩ to +3V3. This is a layout/pin-assignment concern requiring review for high-speed operation, even if low-speed bring-up succeeds.

## What was actually simulated

Ran 16 DC/transient cases in ngspice 46 using KiCad 10’s shared library. The three powered DAC cases use TI’s actual IBIS input clamp tables, converted to behavioral current sources. The remaining cases are explicitly simplified equivalent circuits. They establish failure mechanisms and sensitivity, not exact fault currents or full-board safety.

Case | Result | Meaning / model limit
DAC, TI IBIS nominal: VIO 1.8 V, drive 2.5 V | Pin 2.4981 V; source current 76.4 µA with the modeled pullup | Exceeds 2.1 V absolute limit despite small current. Also fails all three tested IBIS voltage/process/temperature corners.
Opposed I²C pullups: 4.7 kΩ to 3.3 V and 10 kΩ to 1.8 V | 2.8204 V; 102.0 µA toward 1.8 V per line | Resistor-only result; the incorrectly biased PCA9306 is not included, so this is not a prediction of the full bus.
NT25 supply conflict, 100 mV mismatch | 0.1 A / 0.4 A / 2 A for assumed total 1 Ω / 0.25 Ω / 0.05 Ω | Illustrates why regulated outputs must not be directly paralleled. Actual path resistance and regulator reverse behavior are unknown.
Powered card pullups into an unpowered bank | Generic model raises bank to 0.84–1.35 V after 500 ms | Assumed eight 4 kΩ pullups, 100 µF and two rail loads; no vendor powered-off FPGA model. Do not perform this fault experiment on KC705.
LVDS simplified 3.5 mA source | 100 Ω gives 350 mV differential magnitude; 50 Ω gives 175 mV | Check correct receiver termination. The 1 kΩ diagnostic case exceeds the model’s physical validity; its voltage is not a device prediction.
Assumed 1.8 V GPIO line | Unterminated example: -0.712 to 2.514 V; added 33 Ω example: about 0–1.8 V | Assumed 25 Ω driver, 50 Ω line, 1 ns flight time, 5 pF input, no clamps. Demonstrates why a scope is necessary. 33 Ω is not a validated value for this PCB.

Four simulation plots: DAC overvoltage, supply contention, unpowered rail injection, and transmission-line ringing

The two generic DAC diode cases are illustrative only; do not substitute them for the TI powered IBIS results or use the powered IBIS model for VIO=0. TI’s encrypted PCA9306 HSPICE model was not usable faithfully in ngspice. Full FPGA IBIS/S-parameter simulation, extracted board parasitics, thermal behavior, soldering faults, firmware and complete supply sequencing are outside this simulation.

Numerical results · Reproduction script · Validation checks · TI DAC81416 IBIS source (https://www.ti.com/lit/zip/SLAM334). Individual .cir, .csv and .log files are included beside this report. The script needs Python, NumPy, matplotlib, KiCad’s ngspice DLL and the original project/archive at their existing relative locations.

## Step-by-step measurement sequence

Equipment: DMM, current-limited bench supply, oscilloscope with short ground springs or a suitable differential probe, and ideally a breakout/interposer. If FMC pads are inaccessible, attach insulated temporary test wires with all power removed and check clearance before mating. Do not probe tightly spaced live contacts by hand. A DMM alone cannot qualify overshoot, clock amplitudes or power sequencing.

1. Record the actual assembly, with everything disconnected. Confirm NT25, NT22, NT12, R14 and both R63 locations by inspection and continuity. Check connector orientation, bent contacts, solder bridges and component markings, especially U20. Photograph or record the final link states in the worksheet.
2. Resolve source conflicts and isolate bad interfaces first. For independently powered testing open NT25. Select one VDDA1 source. Correct U18 or isolate U18 plus R53/R54. Establish the chosen 1.8/2.5 V interface plan. Hold U17 OE low and resolve FTDI driver ownership. These are preconditions to power tests, not things to discover by connecting the FPGA.
3. DMM resistance and continuity, unpowered. Confirm ground at the probe reference. Measure +5, +3V3, +1V8, +3V3A, +1V8A, -3 V and +12 V to ground in both polarities; allow capacitors to charge and record settled values. A persistent near-zero reading needs investigation; no universal resistance cutoff proves a board safe. Confirm open NT25 separates its pads, and the chosen VDDA1 links give the intended continuity. Verify bottom R63 D30–D31 continuity and no short to neighboring contacts.
4. First PCB-only power. Keep FMC, USB and other power sources disconnected. After correcting/isolating U18, feed the verified 5 V input from a current-limited bench supply. Set the current limit from the enabled-load startup budget, preferably testing isolated power stages first. A full-board startup current budget has not been established here, so an arbitrary 100 mA or 1 A limit is not a qualified setting. If the supply enters current limit, stop and diagnose instead of simply increasing it: rail collapse can violate supply sequencing. Stop for unexpected heating or current. Never combine the bench supply with USB without confirming source isolation.
5. Measure every rail at the accessible points below. Target 5.0, 3.3, 1.8, 3.3A, 1.8A, -3 and +12 V as applicable; check regulator tolerances as well as downstream device limits. Scope startup, ripple and shutdown. ADS5282 requires AVDD 3.0–3.6 V, LVDD 1.7–1.9 V, with the two supplies powered up/down within 10 ms of each other. Stop if any supply overshoots its load’s rating. Confirm VDDA1 is the intended source voltage, not a contested midpoint.
6. Check standalone FMC-facing voltages. With no carrier attached, measure all 36 signal contacts through their accessible nodes and compare them with the pin map. DAC control pullups should be around 1.8 V. Scope clocks and ADC outputs; do not mistake a DMM average for a valid waveform. Test generators must use the correct logic levels. Do not feed 2.5/3.3 V into DAC inputs for verification.
7. Measure the KC705 separately. With the card absent, verify VADJ between J46 pin 15 and pin 16 GND. Confirm numbering from UG810 before touching it. Expect 2.5 V at default settings. If adopting 1.8 V, use the documented KC705 voltage-control procedure and remeasure after a power cycle. Do not assume a jumper change or XDC command changed the rail.
8. Prepare and verify a passive initial FPGA design and a startup sequence. Use the correct J2 or J22 ball map. Unused/shared outputs must remain high impedance; disable unintended pulls and clocks; hold TXS OE low. Check configuration-time behavior too. During start/stop, neither board may drive an unpowered receiver outside its input rating. Controlled carrier-first startup can be considered only after verifying all carrier outputs/pulls are inactive until card rails are valid; shut down card outputs before its rails and keep the carrier powered until card signals decay. If these conditions cannot be guaranteed, add isolation/interposer circuitry. ADC power-down is not a proven high-impedance disconnect.
9. Qualify the waveforms before enabling the complete interface. At nominal 1.8 V VCCO, FPGA recommended input limits are -0.2 to 2.0 V (use measured VCCO+0.2 for the upper bound). DAC operation should stay 0–VIO; 2.1 V is its nominal absolute ceiling, not an operating target. For LVDS, measure both P/N to ground and P−N: common mode must be 0.3–1.5 V and settled differential magnitude 0.1–0.6 V. Typical ADC output is about 1.025/1.375 V on the legs, ±350 mV differential, or 700 mV differential peak-to-peak. With 1.8 V VADJ, fit external 100 Ω at each of the seven FPGA receive pairs; R165 is on the opposite-direction ADC input clock and does not terminate these seven pairs.
10. First mating and staged operation. Only after the above conditions pass, remove all power, verify rails have discharged, mount the card in J2 LPC and secure it. Use the validated supply sequence and monitor both boards’ currents/rails. Confirm the JTAG chain before enabling outputs. Enable one interface at a time: safe CMOS controls at low rate, DAC commands, ADC reset/configuration, then clock and ADC test patterns. Configure ADS5282 DIFF_CLK (register 0x42) before using its differential input clock. Check each stage for contention, heating, rail movement and waveform violations. Do not hot-plug.

Stop conditions: wrong VADJ; a populated NT25 with independent supplies; both VDDA1 sources connected; uncorrected U18; two drivers on one net; unexplained current/heating; input voltage beyond operating limits; startup or shutdown feeding an unpowered device; or missing LVDS termination. Passing DC rail checks alone does not clear these conditions.

## Accessible probe points

These pad numbers come from the supplied PCB file. Confirm each ground pad with the DMM while unpowered. The table gives nominal targets, not a claim that the fabricated board has already been measured. Open the blank measurement worksheet.

Purpose | Probe point | Net | Expected / condition
PCB input | C23 pad 1 | +5V | 5.0 V nominal
Digital supply | C26 pad 1 | +3V3 | 3.3 V nominal
Digital supply | C30 pad 1 | +1V8 | 1.8 V nominal
ADC analog supply | C51 pad 1 | +3V3A | 3.0–3.6 V; target 3.3 V
ADC/DAC I/O supply | C54 pad 1 | +1V8A | ADC LVDD 1.7–1.9 V; target 1.8 V
Negative analog rail | C39 pad 1 | -3VA | -3 V nominal; verify polarity
Boost output | C9 pad 1 / R14 pad 1 | 12VPWR | 12 V nominal
Switched analog rail | R14 pad 2 | +12V | 12 V nominal if R14 fitted and boost running
Carrier VADJ, card disconnected | KC705 J46 pin 15 to pin 16 | VADJ | Selected voltage; default is 2.5 V
TXS enable | R52 pad 2 | FPGA_LOE | Hold LOW during preparation/ramping; <=0.63 V at VCCA=1.8 V
Management clock | R54 pad 2 | FPGA_SCL / FMC C30 | 3.3 V domain after correction; must not remain pulled to 1.8 V
Management data | R53 pad 2 | FPGA_SDA / FMC C31 | 3.3 V domain after correction; must not remain pulled to 1.8 V
DAC chip select | R8 pad 1 | AQ1_nCS | 0–VIO in operation; nominal high 1.8 V
DAC load control | R7 pad 1 | AQ1_nLDAC | 0–VIO in operation; nominal high 1.8 V
DAC reset | R6 pad 1 | AQ1_nRST | 0–VIO in operation; nominal high 1.8 V
ADC chip select | R49 pad 2 | FPGA_nCS | Logic state controlled by test design
ADC reset | R50 pad 2 | FPGA_nADCRST | Default pull-down; release only when ready
ADC power down | R51 pad 1 | ADC_PD | Default pull-down; HIGH is power-down, not proven isolation
ADC input clock | C61 pad 2 / C60 pad 2 | FPGA_MCLKIN_P/N | Connector side of AC coupling; scope differentially

## Complete ordinary-signal map

36-signal CSV · Full connected-contact audit. FMC power, I²C, JTAG and presence contacts are separate from these ordinary bank pins.

FMC contact | PCB net | J2 LPC ball / bank | J22 HPC ball / bank
C10 | OUT4_P | AK20 / 12 | H30 / 16
C11 | OUT4_N | AK21 / 12 | G30 / 16
C14 | FPGA_RX | AJ24 / 12 | D29 / 16
C15 | FPGA_TX | AK25 / 12 | C30 / 16
C18 | SCAN_SI | AD21 / 12 | B28 / 16
C19 | SCAN_CC | AE21 / 12 | A28 / 16
D8 | FPGA_MCLKIN_P | AE23 / 12 | D26 / 16
D9 | FPGA_MCLKIN_N | AF23 / 12 | C26 / 16
D11 | OUT5_P | AG22 / 12 | G29 / 16
D12 | OUT5_N | AH22 / 12 | F30 / 16
D14 | READY_I | AK23 / 12 | B30 / 16
D15 | RESET_B | AK24 / 12 | A30 / 16
D17 | SCAN_SE | AB24 / 12 | A25 / 16
D18 | SCAN_TM | AC25 / 12 | A26 / 16
G6 | LCLK_P | AD23 / 12 | C25 / 16
G7 | LCLK_N | AE24 / 12 | B25 / 16
G9 | OUT2_P | AG20 / 12 | H26 / 16
G10 | OUT2_N | AH20 / 12 | H27 / 16
G12 | AQ1_SCK | AJ22 / 12 | E29 / 16
G13 | AQ1_MOSI | AJ23 / 12 | E30 / 16
G15 | FPGA_SCK | AA20 / 12 | C29 / 16
G16 | FPGA_SDATA | AB20 / 12 | B29 / 16
G18 | ADC_PD | AC22 / 12 | B27 / 16
G19 | FPGA_LOE | AD22 / 12 | A27 / 16
H4 | ADCLK_P | AF22 / 12 | D27 / 16
H5 | ADCLK_N | AG23 / 12 | C27 / 16
H7 | OUT1_P | AF20 / 12 | H24 / 16
H8 | OUT1_N | AF21 / 12 | H25 / 16
H10 | OUT3_P | AH21 / 12 | G28 / 16
H11 | OUT3_N | AJ21 / 12 | F28 / 16
H13 | AQ1_nCS | AG25 / 12 | E28 / 16
H14 | AQ1_nLDAC | AH25 / 12 | D28 / 16
H16 | FPGA_nCS | AE25 / 12 | G27 / 16
H17 | FPGA_nADCRST | AF25 / 12 | F27 / 16
H19 | SI5351_CLK1_1V8 | AC24 / 12 | C24 / 16
H20 | AQ1_nRST | AD24 / 12 | B24 / 16

## Source integrity and remaining limitations

Electrical connectivity was checked against the KiCad PCB, with the supplied schematic PDF as supporting context. They differ in material places, including VDDA1 links and U20’s part value, so the PDF alone is not authoritative for fabrication. The extracted PCB matches the ZIP member byte-for-byte: fdca0330dc568658c43d27be3abe488d13d14b2eec15ef8ff8d3f24107006200.

KiCad DRC reported zero unconnected items; its 76 board violations were library/silkscreen categories. It also found 130 schematic-parity items, including net/field differences and duplicate references. These are not 130 demonstrated shorts, and zero unconnected items does not prove correct design or soldering. Full DRC output. The source PCB was not modified.

Additional primary references: KC705 XTP132 schematic (https://docs.amd.com/v/u/en-US/Xilinx-XTP132-KC705-Schematics-Rev-1.1), ADS5282 datasheet (https://www.ti.com/lit/ds/symlink/ads5282.pdf), SN74AUP1T34 (https://www.ti.com/lit/ds/symlink/sn74aup1t34.pdf), SN74LVC1G125 (https://www.ti.com/lit/ds/symlink/sn74lvc1g125.pdf). The populated device identities, actual rail currents, signal integrity at full rate and FPGA configuration still require hardware verification.
