Naveen-065/Evaluation_Research_Boards-/FMC_Eval_Board/output/ain1_r9_validation/comparison.html

# 56 Ω shunt: observed ADC1 response

After addressing a loose connection, the user measured 8 mV across R9. The reported U10 output is about 50 mV; the FPGA change from the near-zero capture is 49.62 mV. This supports the signal path. Exact gain and calibrated current remain unverified.

Quantity | Result
R9 / direct voltage drop | 56 Ω / 8 mV, user-reported
Current from meter: 0.008 / 56 | 142.9 µA
U10 measured output / approximate voltage ratio | 50 mV / 6.25×
ADC1 average / sample rate | 2154.24 / 10 MSPS
ADC equivalent differential before offset correction | 51.88 mV
ADC change from preceding near-zero capture | 49.62 mV

The near-zero capture is not a calibrated zero-input reference. Its subtraction is a provisional comparison; it does not establish current accuracy. With an assumed gain of 7, the ADC voltage change would imply 126.6 µA, compared with about 142.9 µA from the shunt reading.

## ngspice includes U10's gain

INA851 differential gain = (1 + 6000/R31) × 1 because the PCB leaves its G02 pins open. R31 = 1 kΩ gives 7× and predicts 56 mV for an 8 mV input. The vendor macro-model produces the following signal changes relative to its own zero-input output:

Assumed R31 | Gain | Ideal signal | ngspice signal
1000 Ω | 7.000 | 56.000 mV | 55.955 mV
1200 Ω | 6.000 | 48.000 mV | 47.954 mV

The 1.2 kΩ case is a comparison only. These approximate readings cannot identify the fitted R31. Read its marking or measure it with power off (accounting for in-circuit paths), or perform a stable multi-point input/output gain measurement before selecting a replacement.

## Validation and limits

205 coherent packets were captured, one every 100 ns; status and cadence checks passed. The bitstream was restored unchanged, along with Si5351 10 MHz, the existing DAC scan profile and ADC 10 MSPS settings. All ten return-clock checks passed. FMC electrical settings were unchanged. ADC/DAC SPI register readback and full-pattern testing were not performed.

Earlier 4 mV and 9 mV input estimates preceded discovery of a loose connection. The fresh 8 mV direct reading supersedes them for this comparison. Fitted R31 and meter precision remain unconfirmed.

Measured-input simulation and comparison · Latest FPGA capture evidence
