Naveen-065/Evaluation_Research_Boards-/FMC_Eval_Board/output/adc_lvds_10msps/input_clock/results.csv

case | driver_R_ohm | edge_ns | R165_fitted | plateau_high_V | plateau_low_V | plateau_pp_V | diff_min_V | diff_max_V | clk_p_min_V | clk_p_max_V | clk_n_min_V | clk_n_max_V | common_mode_min_V | common_mode_max_V | p_driver_peak_abs_mA | n_driver_peak_abs_mA | rising_crossing_count_after_700ns | median_rising_period_ns
R10_edge0p5ns_R165_100ohm | 10 | 0.5 | True | 0.7290110569561958 | -0.7290812113886258 | 1.4580922683448216 | -1.2263580065831592 | 1.226363886965058 | -0.1154193549233774 | 3.1148932445789215 | 0.9448224143484933 | 2.055284851991957 | 0.41819805516251335 | 2.581405241543579 | 41.44319959555648 | 24.62008196992557 | 5 | 100.00400968878817
R10_edge1ns_R165_100ohm | 10 | 1 | True | 0.7290279390924004 | -0.7290978602275382 | 1.4581257993199386 | -1.1423345647211014 | 1.1422835118511032 | -0.05119211083335107 | 3.0507969372075303 | 0.9585229784486584 | 2.0415012346703683 | 0.4557498608674926 | 2.5438538646648476 | 39.43179553936249 | 23.31288255985018 | 5 | 100.00014408725539
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
