Naveen-065/Evaluation_Research_Boards-/FMC_Eval_Board/output/ain1_r9_validation/ads5282_analog_20261019_200552_packets.csv

ila_sample | ch1_raw | ch2_raw | ch3_raw | ch4_raw | ch5_raw | ch1_candidate_code | ch2_candidate_code | ch3_candidate_code | ch4_candidate_code | ch5_candidate_code
16 | 513 | 2049 | 1 | 1022 | 574 | 2052 | 2049 | 2048 | 2044 | 1988
36 | 2561 | 1025 | 1 | 1022 | 1598 | 2053 | 2050 | 2048 | 2044 | 1990
56 | 513 | 4094 | 2049 | 1022 | 1598 | 2052 | 2047 | 2049 | 2044 | 1990
76 | 3073 | 4094 | 1 | 1022 | 2622 | 2051 | 2047 | 2048 | 2044 | 1989
96 | 2561 | 1 | 1025 | 1022 | 2622 | 2053 | 2048 | 2050 | 2044 | 1989
116 | 513 | 1025 | 4094 | 1022 | 2622 | 2052 | 2050 | 2047 | 2044 | 1989
136 | 3073 | 1 | 1 | 1022 | 1598 | 2051 | 2048 | 2048 | 2044 | 1990
156 | 1537 | 2046 | 2046 | 1022 | 1598 | 2054 | 2046 | 2046 | 2044 | 1990
176 | 3073 | 4094 | 1025 | 1022 | 1598 | 2051 | 2047 | 2050 | 2044 | 1990
196 | 257 | 1025 | 2049 | 1022 | 3646 | 2056 | 2050 | 2049 | 2044 | 1991
216 | 1537 | 2049 | 4094 | 1022 | 2622 | 2054 | 2049 | 2047 | 2044 | 1989
236 | 2561 | 2046 | 3073 | 1022 | 2622 | 2053 | 2046 | 2051 | 2044 | 1989
256 | 3073 | 1 | 2046 | 3582 | 1598 | 2051 | 2048 | 2046 | 2043 | 1990
276 | 1025 | 1 | 2046 | 1022 | 3646 | 2050 | 2048 | 2046 | 2044 | 1991
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
