Naveen-065/Evaluation_Research_Boards-/FMC_Eval_Board/output/ain1_r9_validation/load_3k3/ads5282_analog_20261019_201747.csv

Sample in Buffer | Sample in Window | TRIGGER | snapshot_words[59:0] | live_shifts[59:0] | raw_ddr[11:0] | run_enable_1 | pll_locked_1 | adc_clock_running_1 | adc_reset_n_1 | config_done_1 | sequence_index_1[2:0] | control_state_1[3:0] | spi_ncs_1 | spi_sclk_1 | dac_enable_1 | dac_frame_index_1[4:0] | dac_state_1[2:0] | dac_ready_1 | dac_reset_n_1 | dac_ncs_1 | dac_sclk_1 | ret_adclk_seen_1 | ret_lclk_seen_1 | ret_adclk_10m_1 | ret_lclk_60m_1 | ret_window_valid_1 | ret_adclk_10m_2 | ret_lclk_60m_2 | frame_locked_sync[1:1] | snapshot_valid
Radix - UNSIGNED | UNSIGNED | UNSIGNED | HEX | HEX | HEX | HEX | HEX | HEX | HEX | HEX | HEX | HEX | HEX | HEX | HEX | HEX | HEX | HEX | HEX | HEX | HEX | HEX | HEX | HEX | HEX | HEX | HEX | HEX | HEX | HEX
0 | 0 | 0 | 63e3feffe001101 | a3e3fe0017fea01 | e21 | 1 | 1 | 1 | 1 | 1 | 7 | ST_DONE | 1 | 0 | 1 | 14 | iSTATE | 1 | 1 | 1 | 0 | 1 | 1 | 1 | 1 | 1 | 1 | 1 | 1 | 0
1 | 1 | 0 | 63e3fe001401601 | 002000000000003 | f28 | 1 | 1 | 1 | 1 | 1 | 7 | ST_DONE | 1 | 0 | 1 | 14 | iSTATE | 1 | 1 | 1 | 0 | 1 | 1 | 1 | 1 | 1 | 1 | 1 | 1 | 1
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
