Naveen-065/Evaluation_Research_Boards-/FMC_Eval_Board/output/ain1_r9_validation/load_3k3/ads5282_analog_20261019_201747_packets.csv

ila_sample | ch1_raw | ch2_raw | ch3_raw | ch4_raw | ch5_raw | ch1_candidate_code | ch2_candidate_code | ch3_candidate_code | ch4_candidate_code | ch5_candidate_code
1 | 1537 | 1025 | 1 | 1022 | 1598 | 2054 | 2050 | 2048 | 2044 | 1990
21 | 2561 | 2046 | 1 | 1022 | 2622 | 2053 | 2046 | 2048 | 2044 | 1989
41 | 3585 | 1 | 1 | 1022 | 2622 | 2055 | 2048 | 2048 | 2044 | 1989
61 | 3585 | 2046 | 1 | 3582 | 3134 | 2055 | 2046 | 2048 | 2043 | 1987
81 | 1537 | 2049 | 1 | 1022 | 2622 | 2054 | 2049 | 2048 | 2044 | 1989
101 | 1537 | 4094 | 4094 | 1022 | 1598 | 2054 | 2047 | 2047 | 2044 | 1990
121 | 3585 | 4094 | 1025 | 1022 | 2622 | 2055 | 2047 | 2050 | 2044 | 1989
141 | 513 | 4094 | 4094 | 1022 | 1598 | 2052 | 2047 | 2047 | 2044 | 1990
161 | 513 | 1 | 2046 | 1022 | 2622 | 2052 | 2048 | 2046 | 2044 | 1989
181 | 2561 | 4094 | 2046 | 1022 | 1598 | 2053 | 2047 | 2046 | 2044 | 1990
201 | 257 | 2046 | 2049 | 1022 | 1598 | 2056 | 2046 | 2049 | 2044 | 1990
221 | 1537 | 1025 | 4094 | 1022 | 1598 | 2054 | 2050 | 2047 | 2044 | 1990
241 | 3585 | 4094 | 1 | 1022 | 1598 | 2055 | 2047 | 2048 | 2044 | 1990
261 | 1537 | 3070 | 1025 | 1022 | 574 | 2054 | 2045 | 2050 | 2044 | 1988
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
