Naveen-065/Evaluation_Research_Boards-/FMC_Eval_Board/output/ain1_r9_validation/load_3k3/ads5282_analog_20261019_202241_packets.csv

ila_sample | ch1_raw | ch2_raw | ch3_raw | ch4_raw | ch5_raw | ch1_candidate_code | ch2_candidate_code | ch3_candidate_code | ch4_candidate_code | ch5_candidate_code
13 | 3585 | 2046 | 2049 | 1022 | 2622 | 2055 | 2046 | 2049 | 2044 | 1989
33 | 1537 | 3070 | 1025 | 1022 | 1598 | 2054 | 2045 | 2050 | 2044 | 1990
53 | 513 | 3073 | 2046 | 1022 | 1598 | 2052 | 2051 | 2046 | 2044 | 1990
73 | 2305 | 4094 | 2049 | 1022 | 1598 | 2057 | 2047 | 2049 | 2044 | 1990
93 | 513 | 2046 | 4094 | 1022 | 574 | 2052 | 2046 | 2047 | 2044 | 1988
113 | 3585 | 1 | 2049 | 1022 | 3646 | 2055 | 2048 | 2049 | 2044 | 1991
133 | 2305 | 1 | 1 | 1022 | 1598 | 2057 | 2048 | 2048 | 2044 | 1990
153 | 257 | 3070 | 2046 | 1022 | 1598 | 2056 | 2045 | 2046 | 2044 | 1990
173 | 1537 | 2046 | 4094 | 1022 | 1598 | 2054 | 2046 | 2047 | 2044 | 1990
193 | 2561 | 1 | 4094 | 1022 | 1598 | 2053 | 2048 | 2047 | 2044 | 1990
213 | 2561 | 4094 | 4094 | 1022 | 3646 | 2053 | 2047 | 2047 | 2044 | 1991
233 | 1537 | 1 | 4094 | 1022 | 318 | 2054 | 2048 | 2047 | 2044 | 1992
253 | 1537 | 1 | 1025 | 1022 | 1598 | 2054 | 2048 | 2050 | 2044 | 1990
273 | 1537 | 1 | 4094 | 1022 | 1598 | 2054 | 2048 | 2047 | 2044 | 1990
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
