Naveen-065/Evaluation_Research_Boards-/FMC_Eval_Board/output/dac_reference_audit/ngspice_reference_results.png

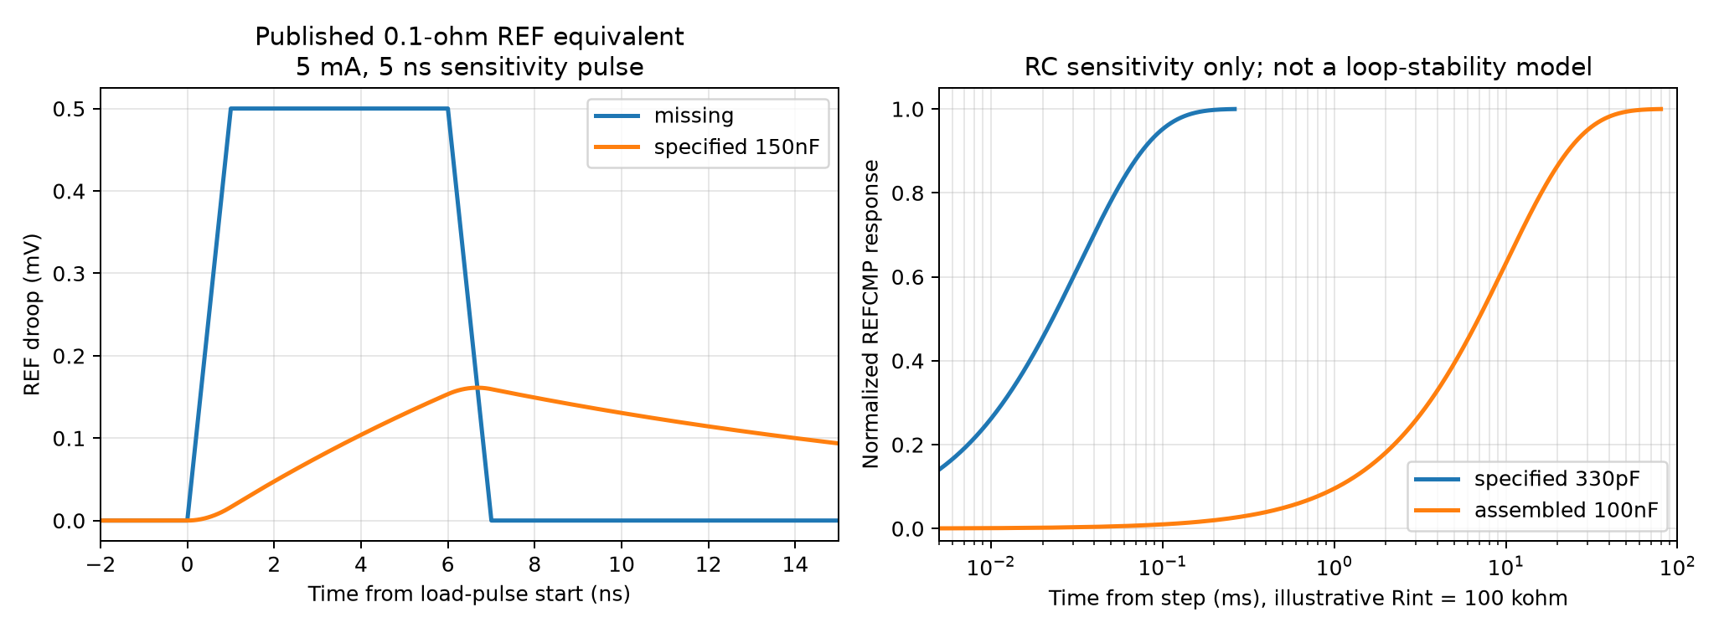
FMC_Eval_Board/output/dac_reference_audit/ngspice_reference_results.png
