Naveen-065/Evaluation_Research_Boards-/FMC_Eval_Board/output/fmc_i2c_c30_c31_sim/simulation_results.png

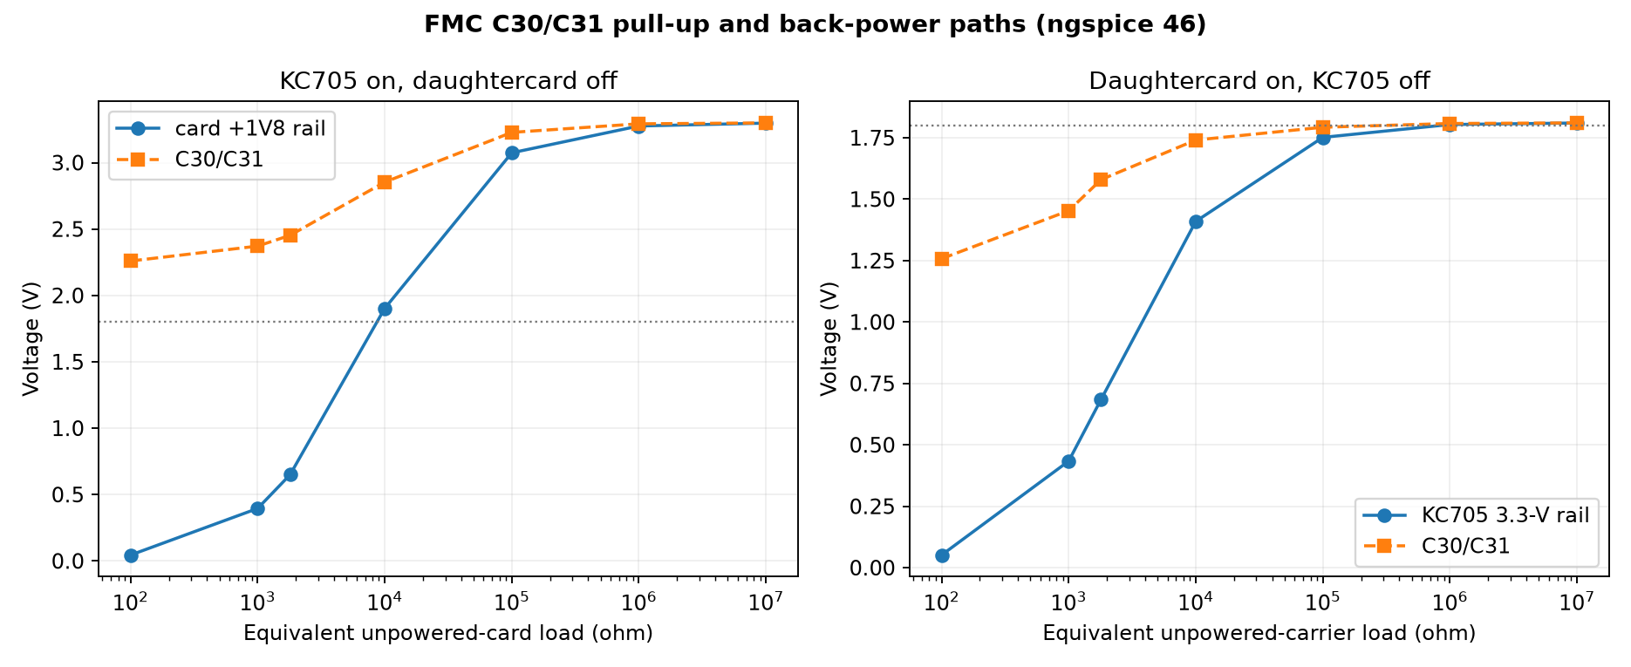
FMC_Eval_Board/output/fmc_i2c_c30_c31_sim/simulation_results.png
