Naveen-065/Evaluation_Research_Boards-/FMC_Eval_Board/output/kc705_cell_control/evidence/scan_cycle_verified.png

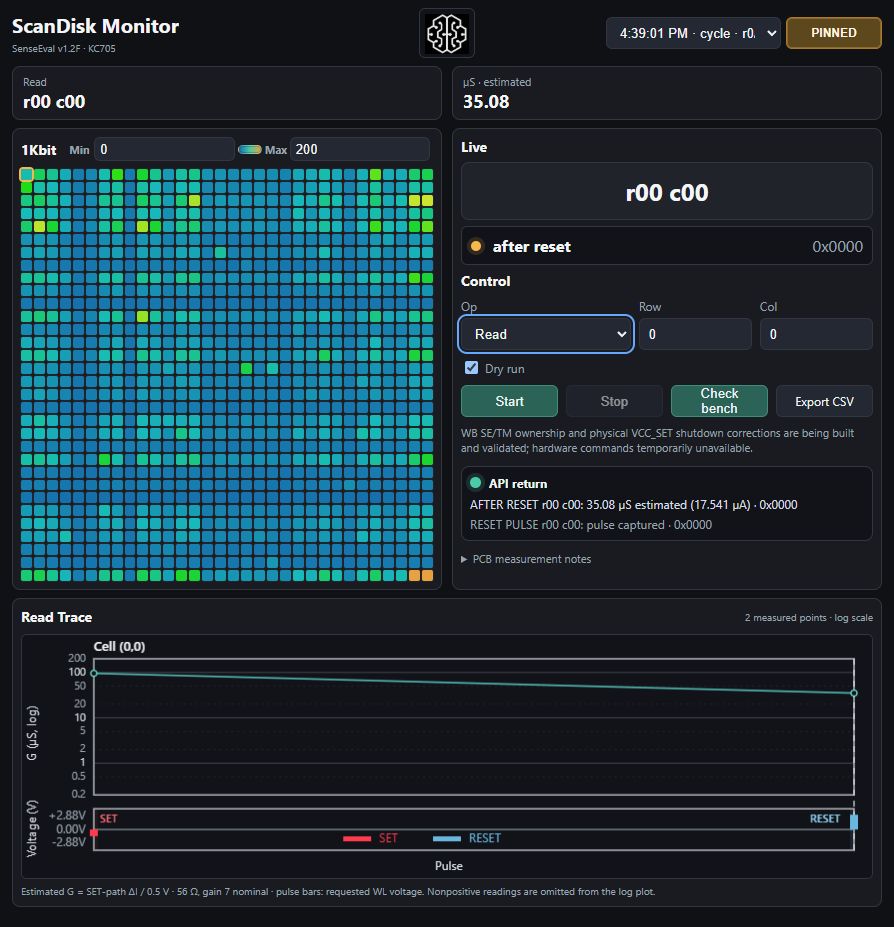
FMC_Eval_Board/output/kc705_cell_control/evidence/scan_cycle_verified.png
