Naveen-065/Evaluation_Research_Boards-/FMC_Eval_Board/output/u18_2p1v_risk/risk_results.png

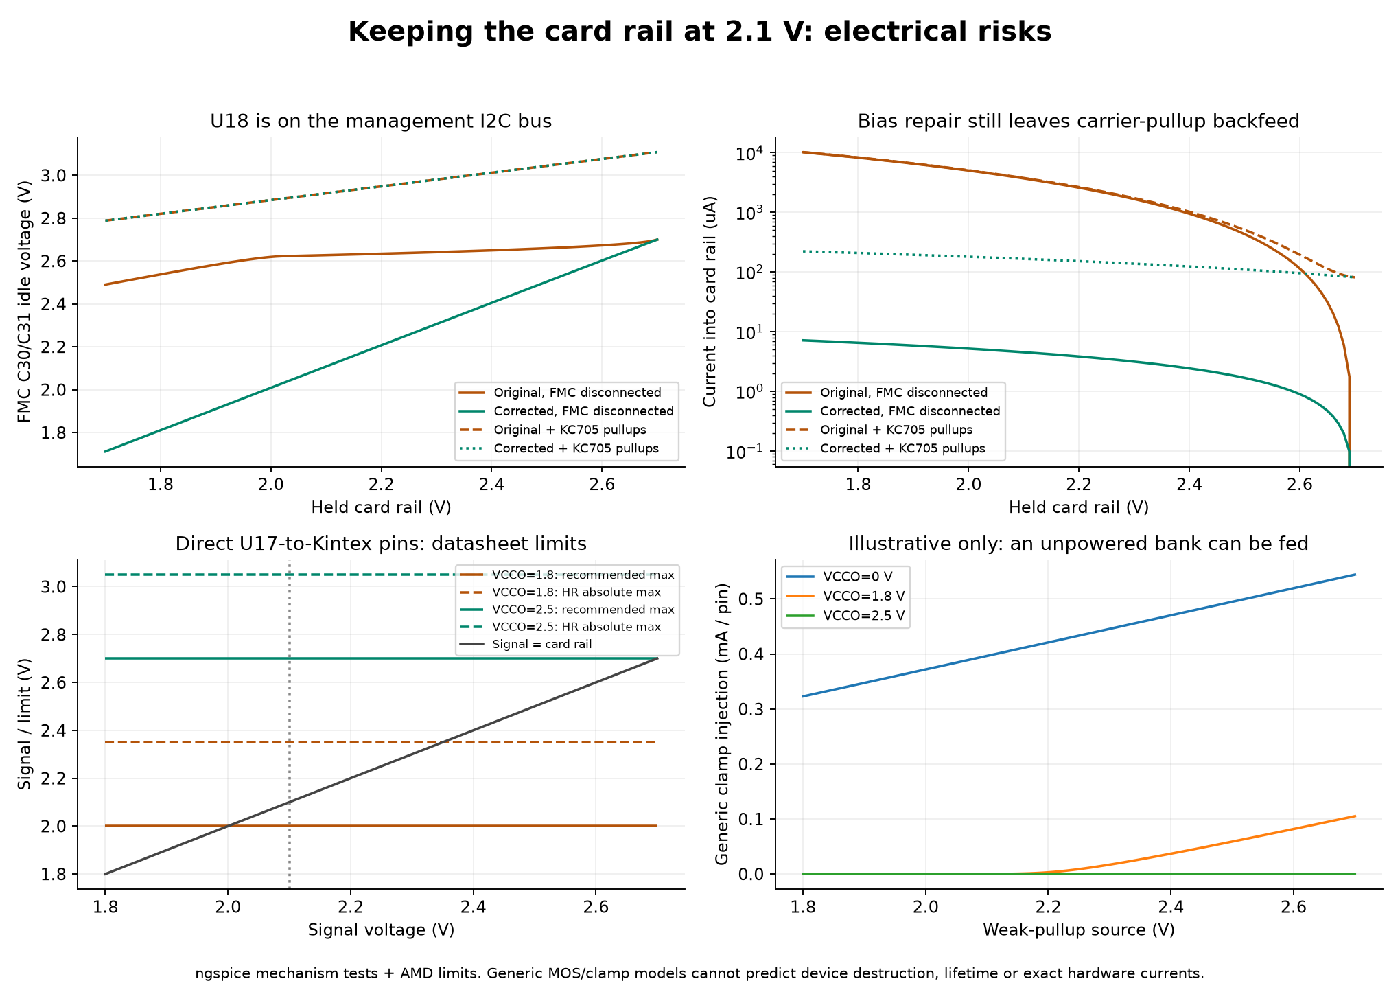
FMC_Eval_Board/output/u18_2p1v_risk/risk_results.png
