Naveen-065/Evaluation_Research_Boards-/FMC_Eval_Board/output/u18_bias_rework/simulation_results.png

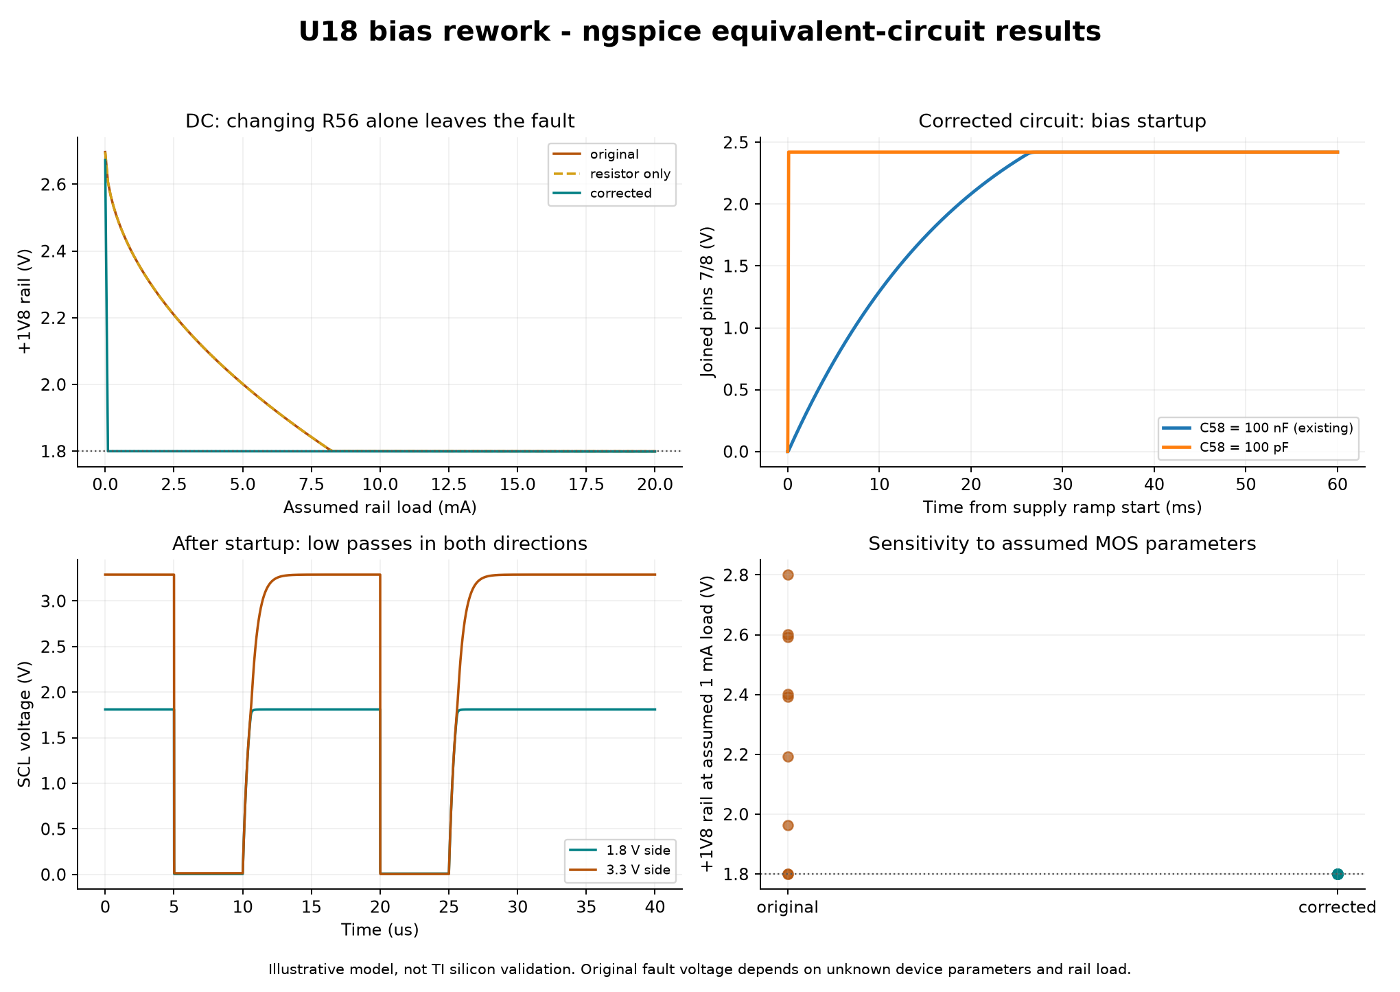
FMC_Eval_Board/output/u18_bias_rework/simulation_results.png
