Naveen-065/Evaluation_Research_Boards-/FMC_Eval_Board/output/u18_fault_diagnosis/u18_fault_results.png

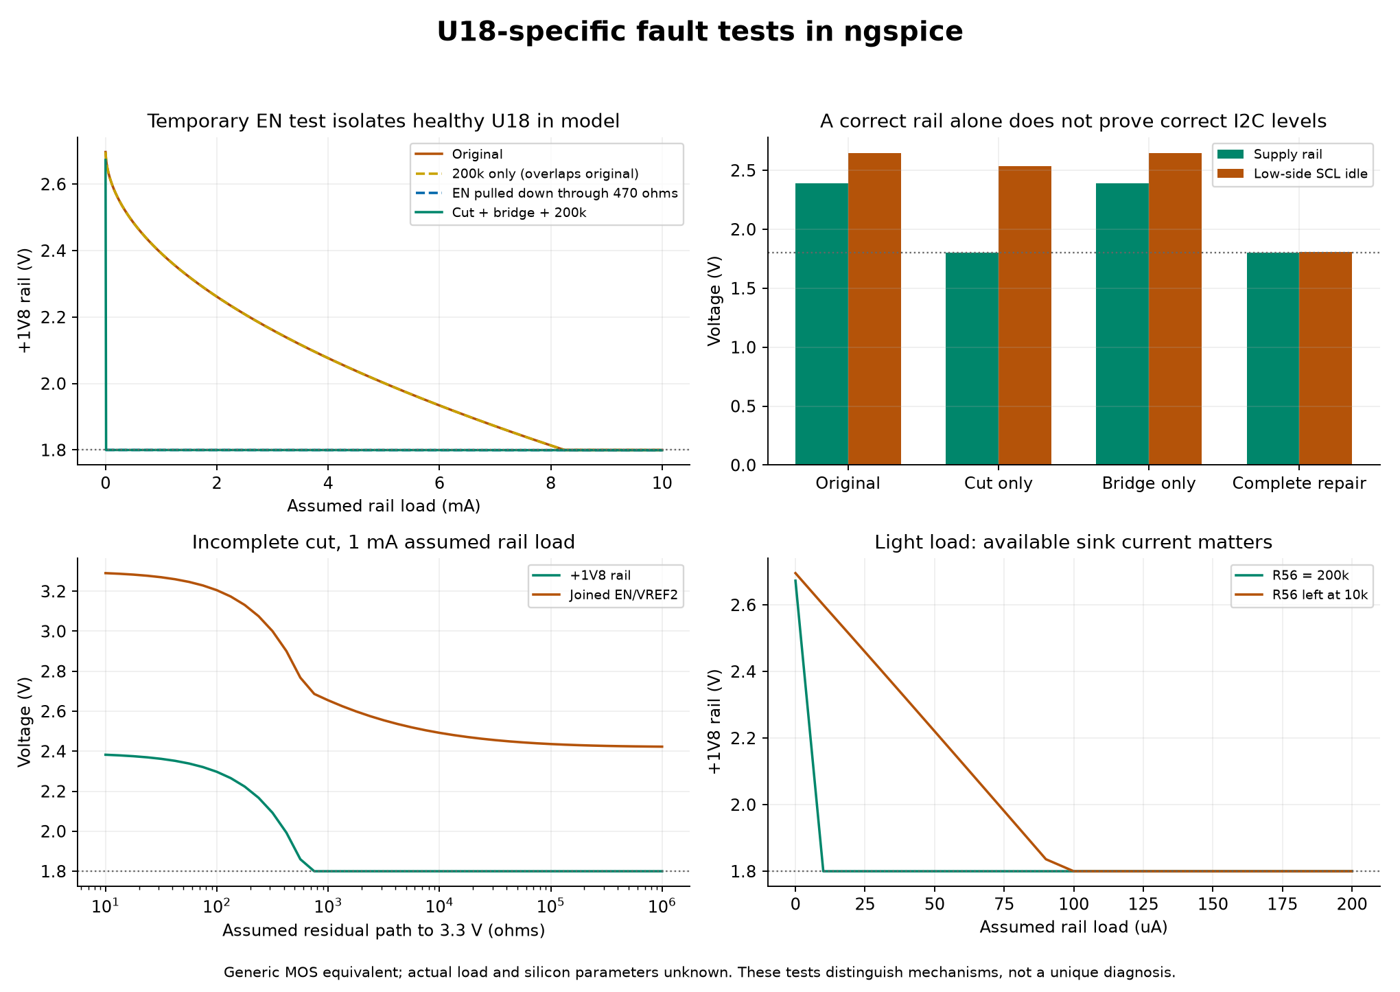
FMC_Eval_Board/output/u18_fault_diagnosis/u18_fault_results.png
