Naveen-065/Evaluation_Research_Boards-/FMC_Eval_Board/hardware/CaravelReRAM-SenseEval_v1.2F.pdf

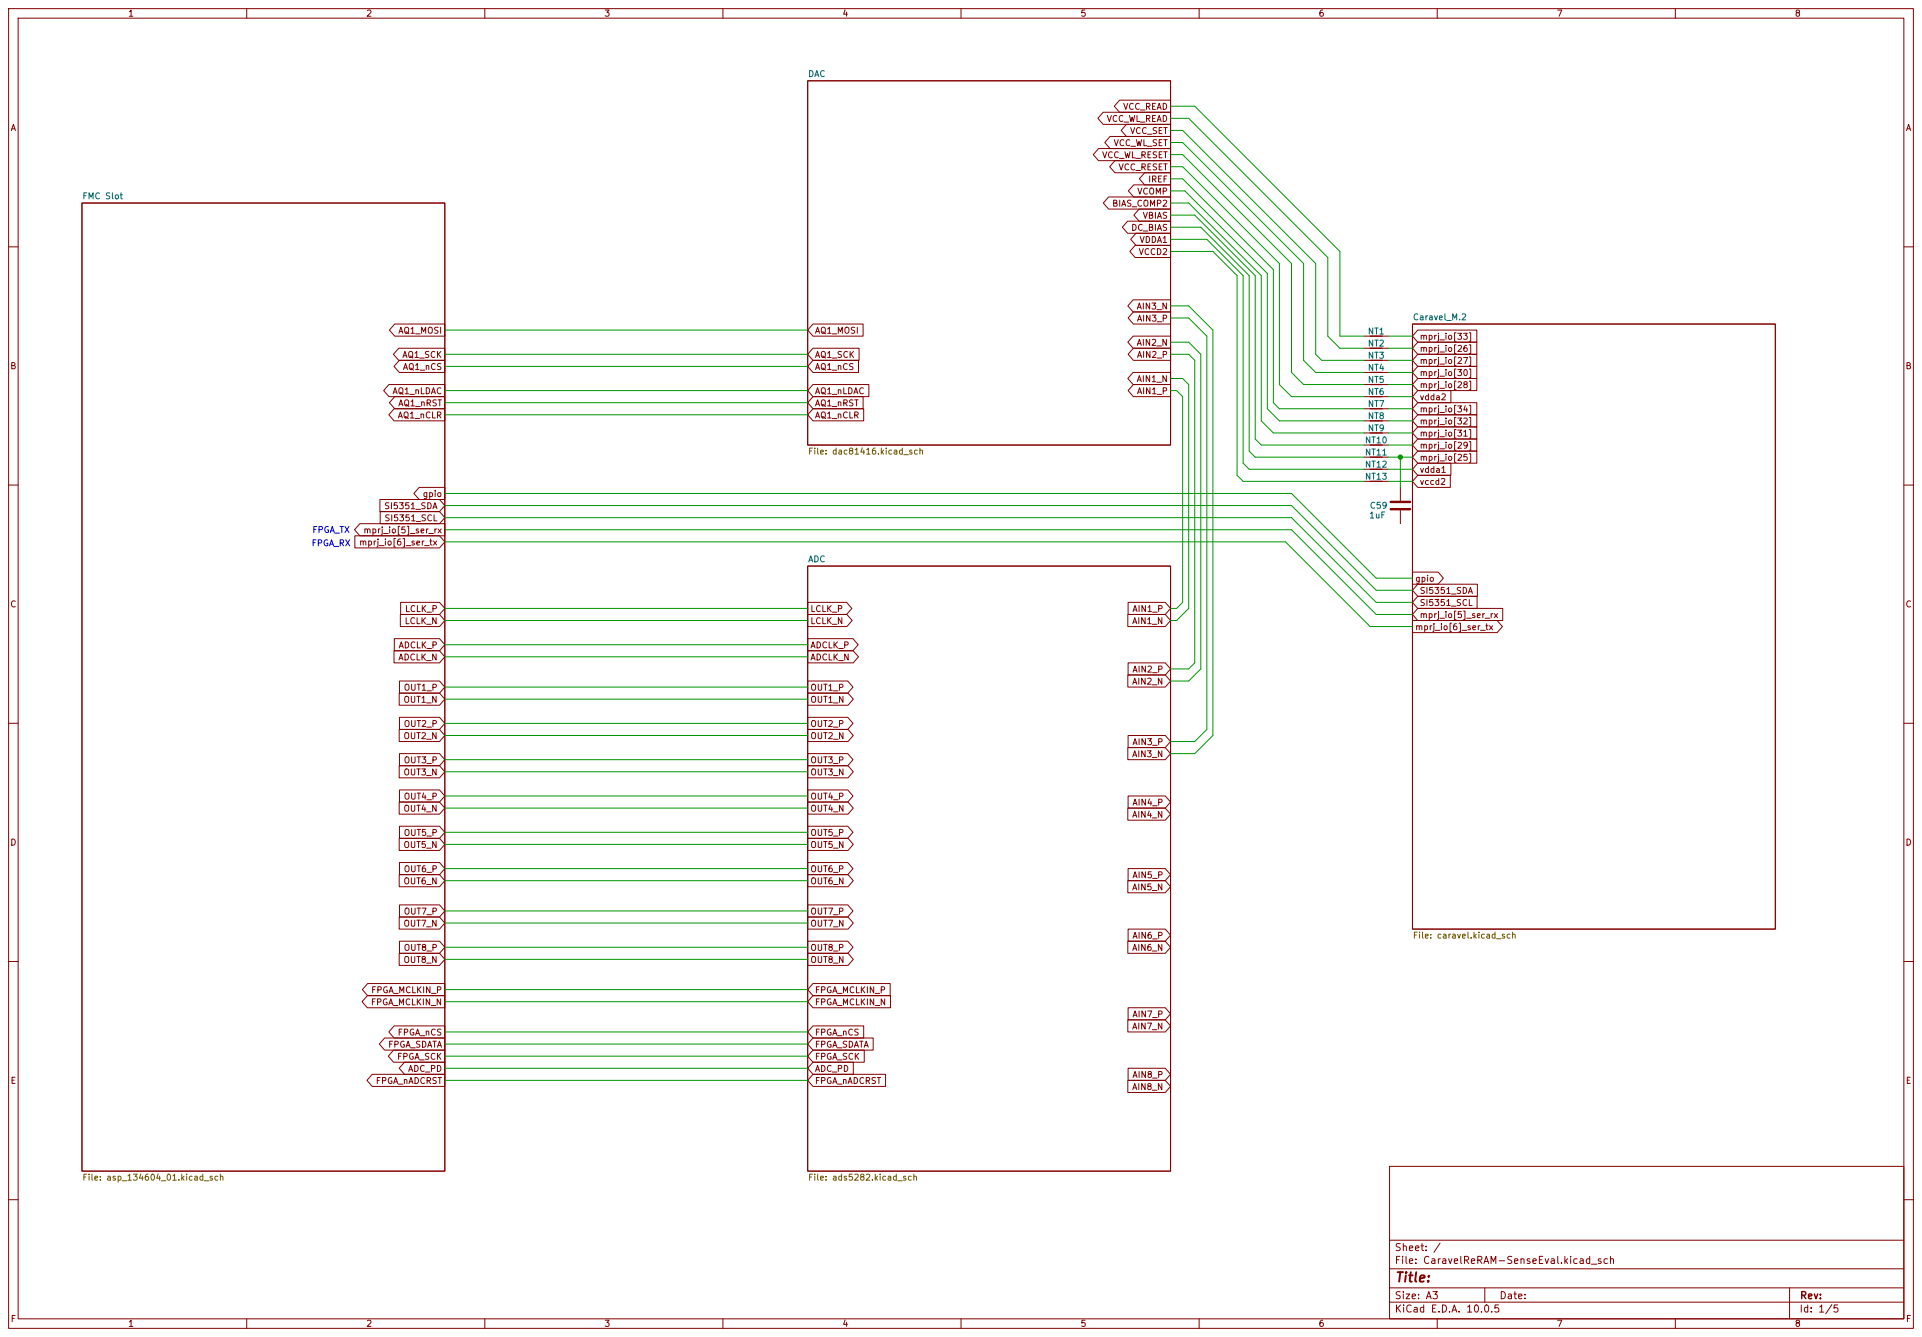
[picture p27: page 1]

Size: A3 | Rev:
KiCad E.D.A. 10.0.5 | Id: 1/5

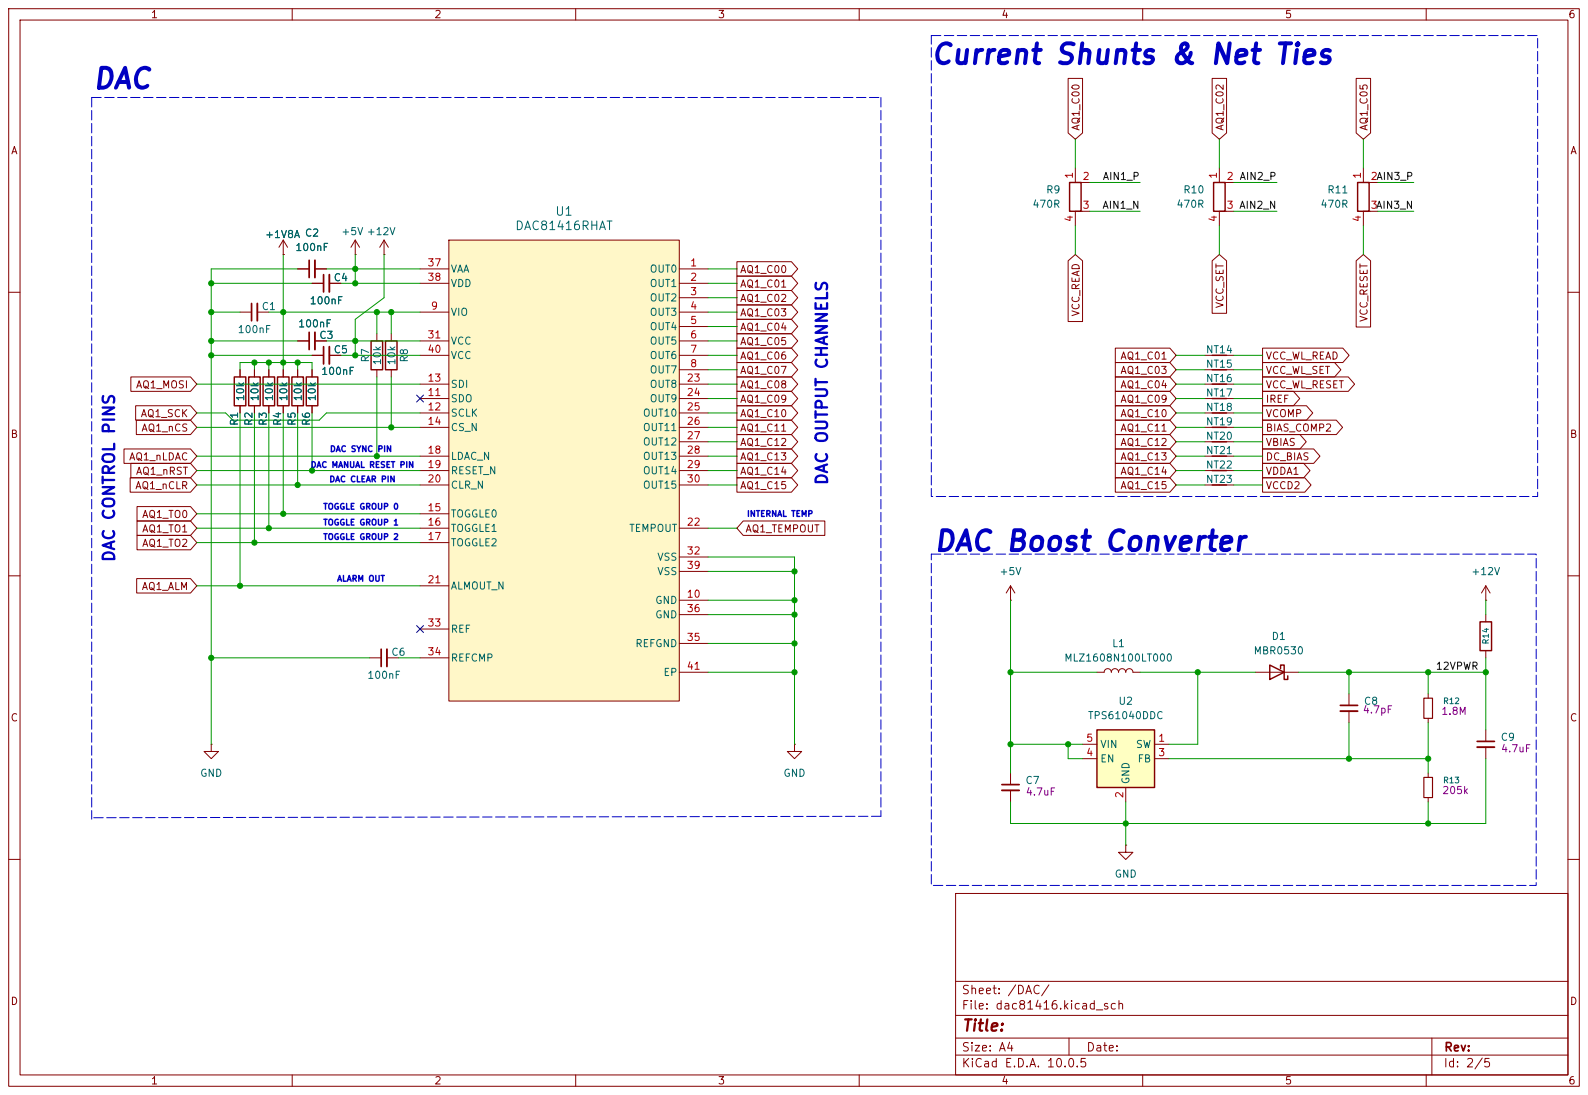
[picture p28: page 2]

INTERNAL TEMP DAC OUTPUT CHANNELS

12VPWR DAC DAC CONTROL PINS

100nF R5 10k | C5 | VCC 40

VCC 31

SDI 13 CS_N 14 SDO 11 SCLK 12

DAC MANUAL RESET PIN
DAC CLEAR PIN

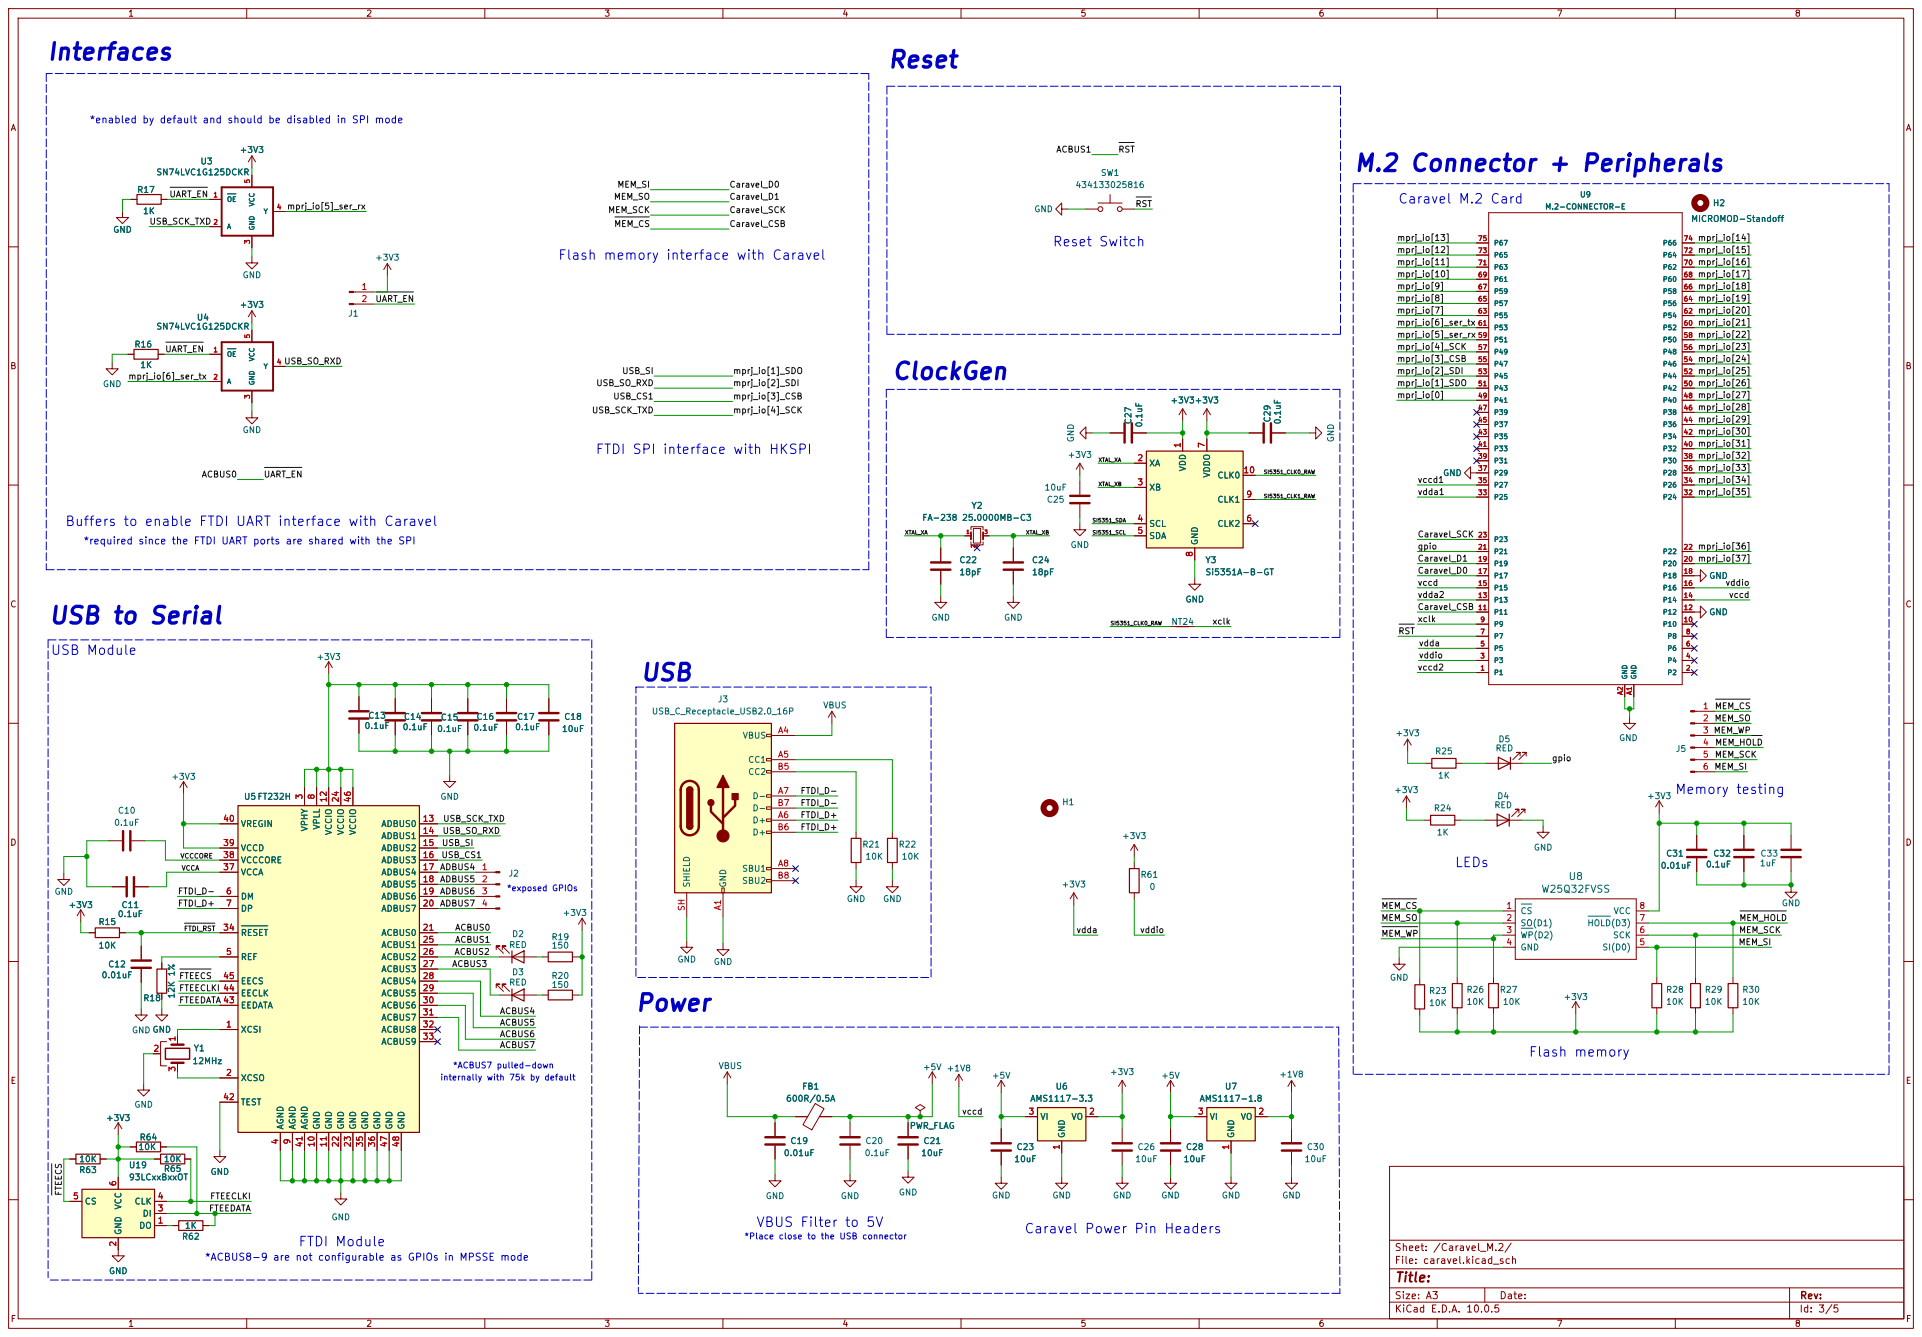
[picture p29: page 3]

*enabled by default and should be disabled in SPI mode
USB_SCK_TXD UART_EN

Flash memory interface with Caravel

FTDI SPI interface with HKSPI

Buffers to enable FTDI UART interface with Caravel
*required since the FTDI UART ports are shared with the SPI

4 REF 5 DM 6 DP 7 VPLL 8 AGND

internally with 75k by default *ACBUS8-9 are not configurable as GPIOs in MPSSE mode

2 DI 3 CLK 4 CS 5 VCC

Caravel Power Pin Headers

*Place close to the USB connector

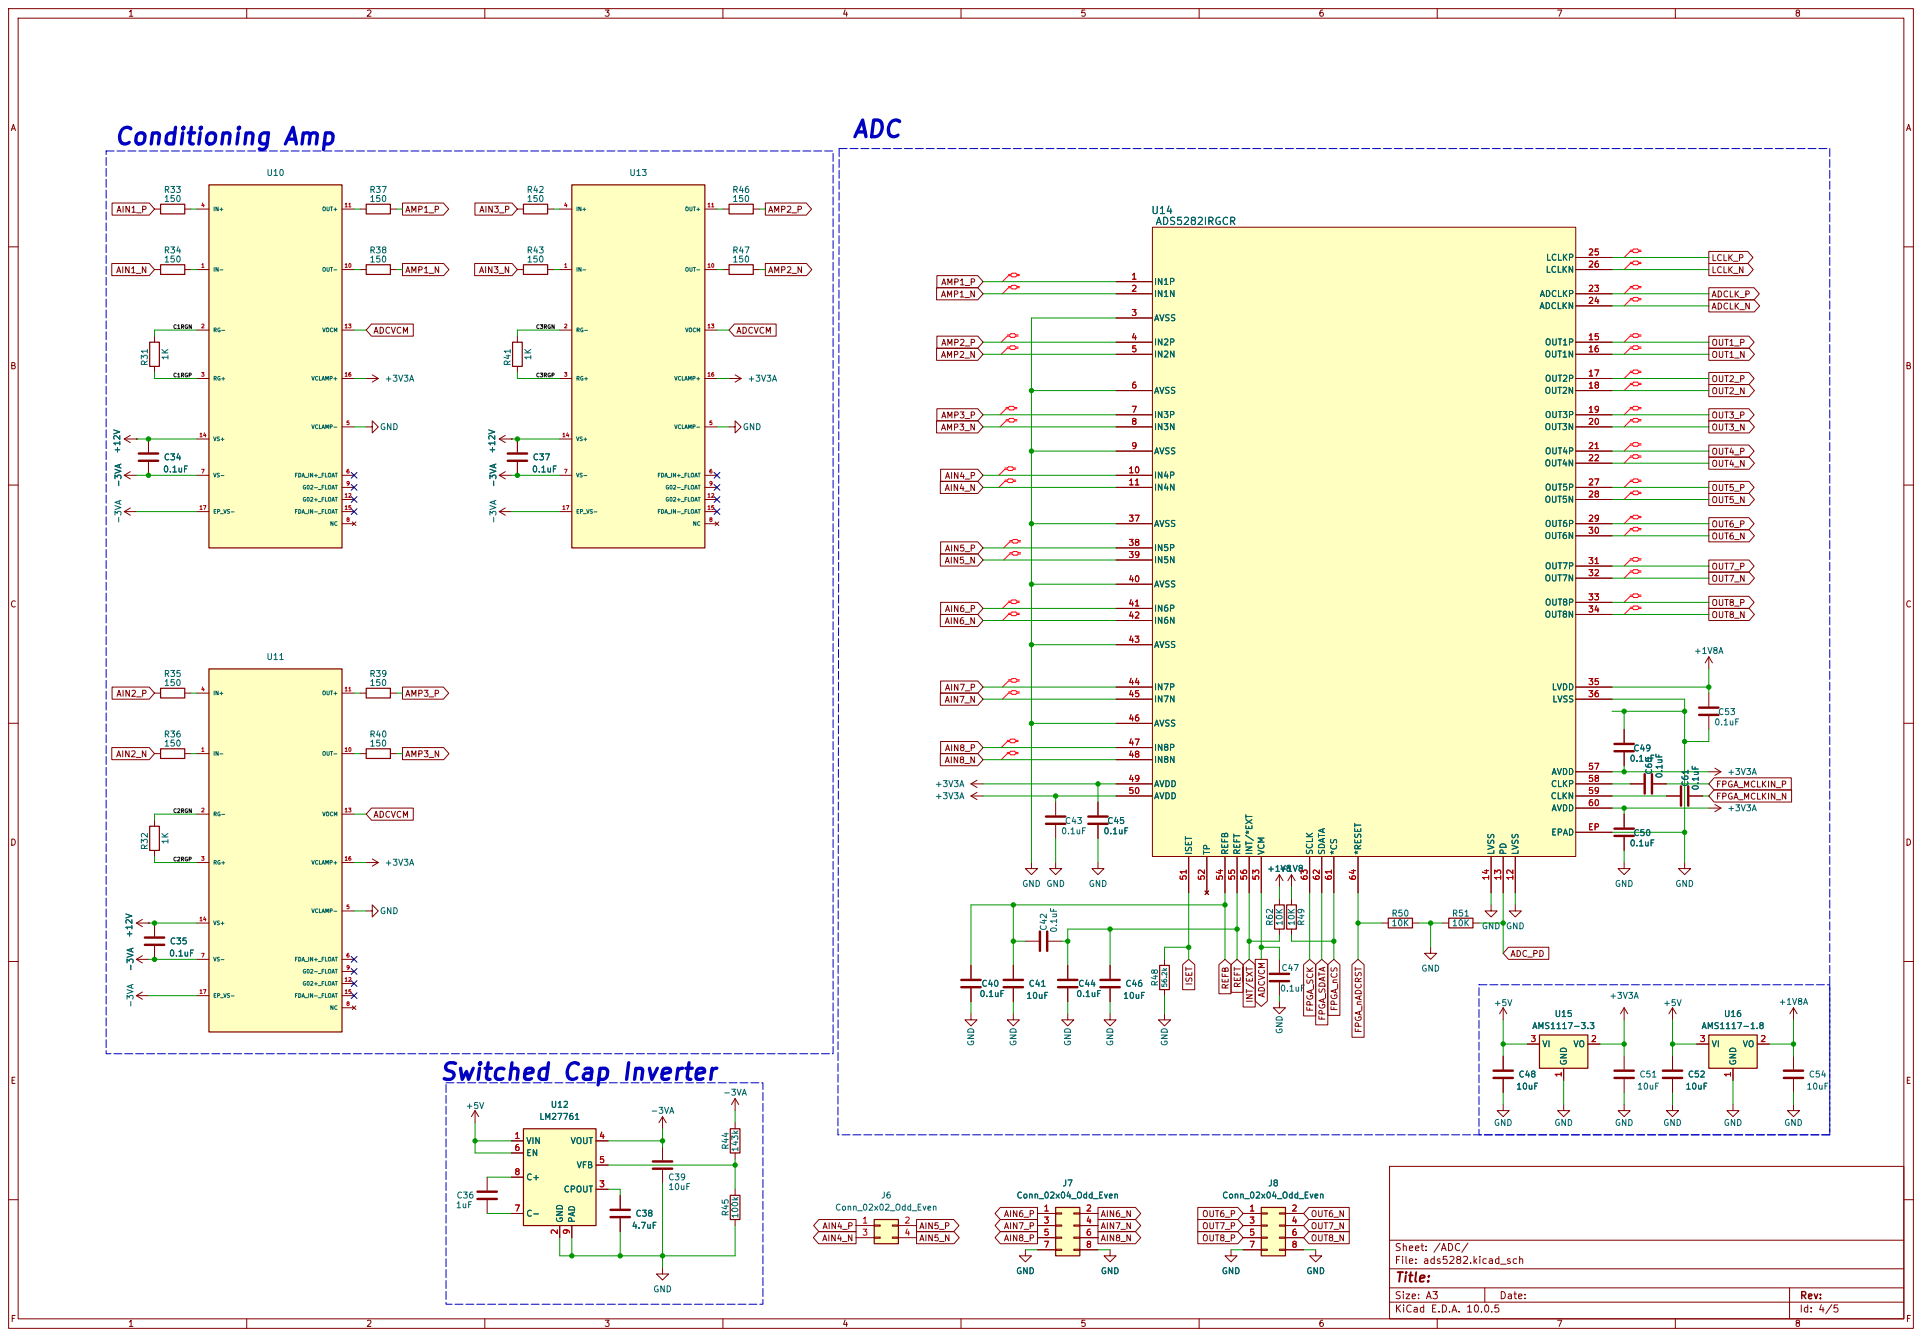
[picture p30: page 4]

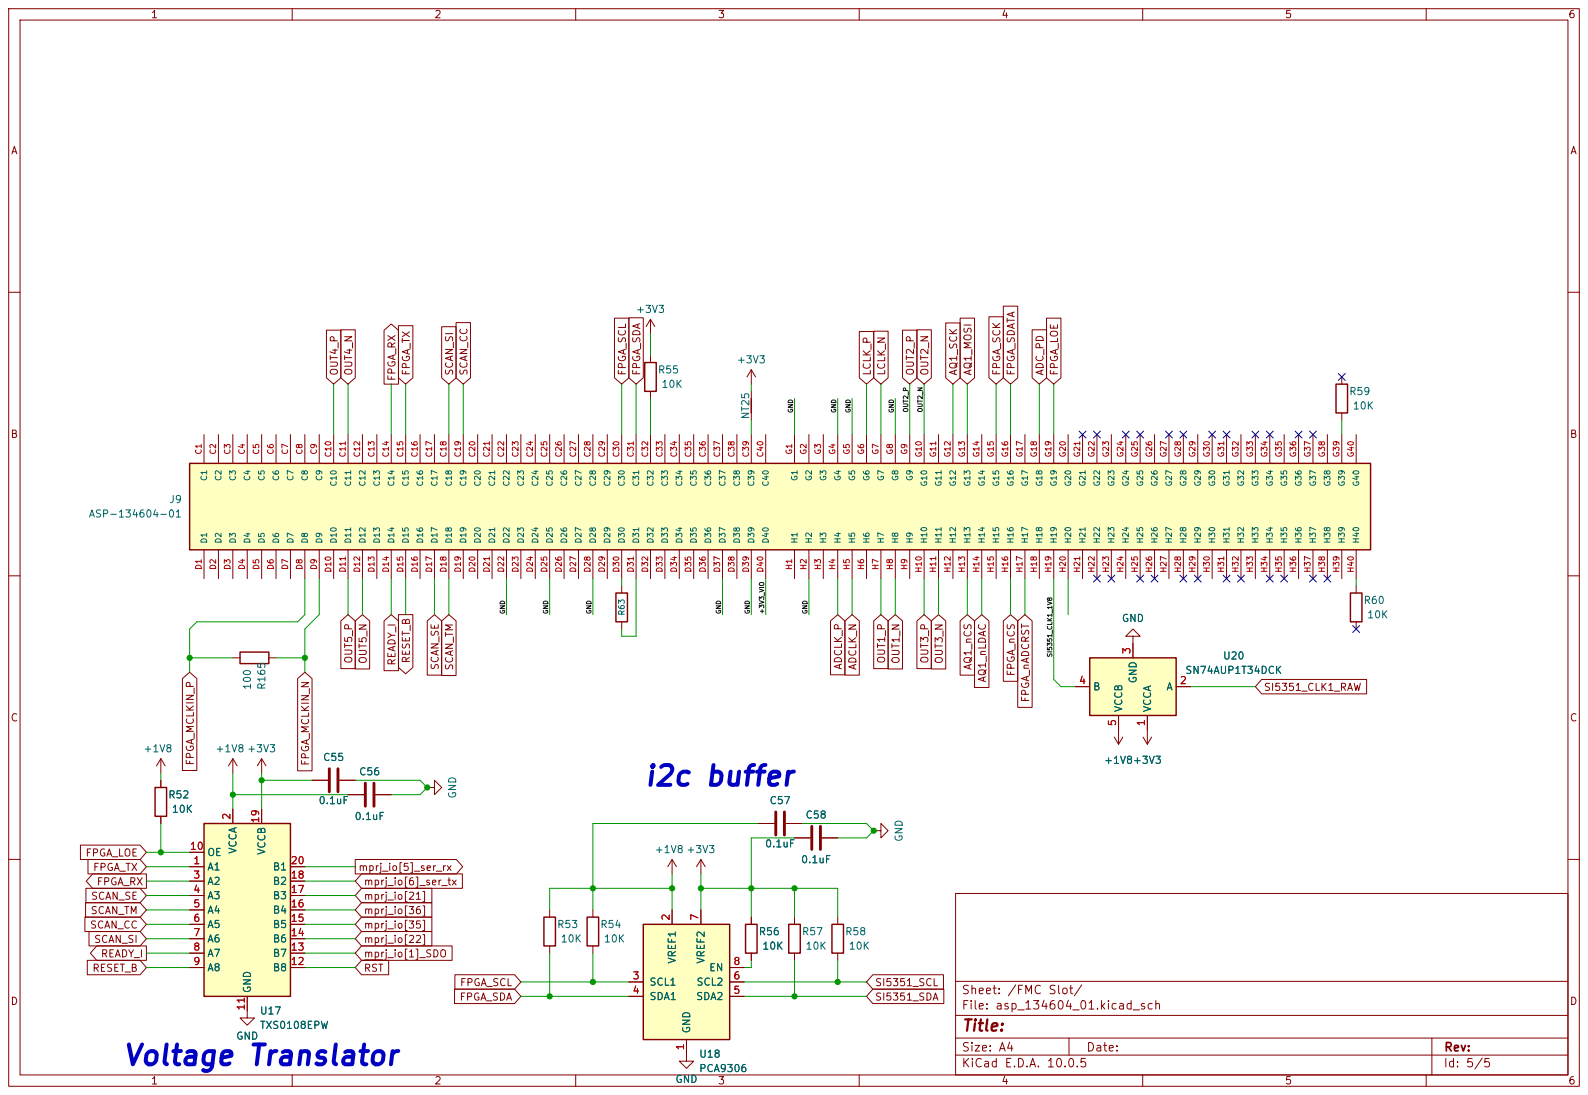
[picture p31: page 5]
