Naveen-065/Evaluation_Research_Boards-/FMC_Eval_Board/output/u18_2p1v_risk/corrected_carrier_pullups.cir

U18 held-rail stress check: corrected=True, carrierpullups=True
* Holding rail with a voltage source is a boundary condition, NOT LDO behavior.
* Positive I(Vrail) is current which the real rail load/regulator must absorb.
* Generic MOS equivalent, no manufacturer fitted parameters, no damage model.
.options reltol=1e-7 abstol=1e-12 vntol=1e-9
Vrail rail 0 2.1
Vhigh high 0 3.3
R56 high en 200k
Vlink en ref2 0
Mref ref2 en rail 0 PASS W=1u L=1u
Mscl sclh en scll 0 PASS W=1u L=1u
Msda sdah en sdal 0 PASS W=1u L=1u
.model PASS NMOS(LEVEL=1 VTO=0.6 KP=0.02 GAMMA=0 LAMBDA=0)
R53 rail sdal 10k
R54 rail scll 10k
R57 high sclh 10k
R58 high sdah 10k
RcS high scll 4.7k
RcD high sdal 4.7k
.dc Vrail 1.7 2.7 .01
.save v(rail) v(en) v(scll) v(sclh) i(Vrail) @mref[id]
.end
