Naveen-065/Evaluation_Research_Boards-/FMC_Eval_Board/output/u18_2p1v_risk/generic_clamp_vcco0.cir

Illustrative generic input clamp: bank VCCO=0
* NOT an AMD/Kintex model. No breakdown, latchup, lifetime or thermal behavior.
* 4k represents a TXS high-state weak pullup; edge accelerators not simulated.
.options reltol=1e-7 abstol=1e-12 vntol=1e-9
Vsource source 0 2.1
Vbank bank 0 0
Rpull source pin 4k
Dclamp pin bank GENERIC
.model GENERIC D(IS=1e-12 N=1 RS=5)
Rleak pin 0 10Meg
Cpin pin 0 8p
.dc Vsource 1.8 2.7 .01
.save v(source) v(pin) i(Vbank) i(Vsource)
.end
