Naveen-065/Evaluation_Research_Boards-/FMC_Eval_Board/output/dac_reference_audit/refcmp_R10000_assembled_100nF.cir

Normalized DAC81416 REFCMP RC sensitivity model
* Rint=10000 ohm is swept because TI does not publish the internal value.
* This is not a reference-loop stability model.
.options reltol=1e-8 abstol=1e-13 vntol=1e-10 plotwinsize=0
Vdrive src 0 PULSE(0 1 1u 1n 1n 0.016 0.032)
Rint src refcmp 10000
Ccomp refcmp 0 1e-07
.tran 2e-06 0.008
.save time v(refcmp)
.end
