Naveen-065/Evaluation_Research_Boards-/FMC_Eval_Board/output/dac_reference_audit/refcmp_R1000_assembled_100nF.cir

Normalized DAC81416 REFCMP RC sensitivity model
* Rint=1000 ohm is swept because TI does not publish the internal value.
* This is not a reference-loop stability model.
.options reltol=1e-8 abstol=1e-13 vntol=1e-10 plotwinsize=0
Vdrive src 0 PULSE(0 1 1u 1n 1n 0.0016 0.0032)
Rint src refcmp 1000
Ccomp refcmp 0 1e-07
.tran 2e-07 0.0008
.save time v(refcmp)
.end
