Naveen-065/Evaluation_Research_Boards-/FMC_Eval_Board/output/fmc_verification/dac_ti_ibis_min.cir

DAC81416 INPUT1_1p8 TI IBIS clamp table, min corner
* TI SLAM334 / dac81416.ibs, File Rev 1.0, 2018-08-23.
* Powered DC I/V conversion only, not a full FPGA or complete IBIS transient model.
* Assumed FPGA source resistance 25 ohm. Device voltage limits remain mandatory.
Vdrive source 0 0
Rdriver source package 25
Rpackage package pin 0.05
Vio vio 0 1.65
Rpull package vio 10k
Bgnd pin 0 I=pwl(v(pin),
+ -1.8, -1.00558, -1.4436, -0.663464, -1.4382, -0.658331, -1.4274, -0.64807, -1.2006, -0.434969,
+ -1.1952, -0.429967, -1.179, -0.414986, -1.1736, -0.410001, -1.152, -0.39011, -1.1466, -0.38515,
+ -1.044, -0.292062, -1.0062, -0.258464, -0.9522, -0.211381, -0.9468, -0.206745, -0.9414, -0.202123,
+ -0.9036, -0.170232, -0.8928, -0.16129, -0.8874, -0.156851, -0.882, -0.152434, -0.8604, -0.135013,
+ -0.828, -0.10975, -0.8118, -0.0975961, -0.8064, -0.0936275, -0.801, -0.0897037, -0.774, -0.0708461,
+ -0.7254, -0.0410807, -0.6552, -0.0124308, -0.6498, -0.0110737, -0.585, -0.00227722, -0.4446, -5.39072e-05,
+ -0.4392, -4.65303e-05, -0.4338, -4.01403e-05, -0.4284, -3.46082e-05, -0.423, -2.98215e-05, -0.4176, -2.56825e-05,
+ -0.4122, -2.21058e-05, -0.4068, -1.90173e-05, -0.4014, -1.63522e-05, -0.396, -1.40539e-05, -0.3906, -1.20734e-05,
+ -0.3852, -1.03677e-05, -0.3798, -8.89968e-06, -0.3744, -7.63685e-06, -0.369, -6.55113e-06, -0.3636, -5.61812e-06,
+ -0.3528, -4.12856e-06, -0.3474, -3.53791e-06, -0.342, -3.03111e-06, -0.3366, -2.59638e-06, -0.3258, -1.90393e-06,
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
+ 0.9972, 0, 1.0728, 0, 1.1484, 0, 1.224, 0, 1.2996, 0,
+ 1.3752, 0, 1.4508, 0, 1.5264, 0, 1.602, 0, 1.6776, 0,
+ 1.7532, 0, 1.8288, 0, 1.9044, 0, 1.98, 0, 2.0556, 0,
+ 2.1312, 0, 2.2068, 0, 2.25, 0, 3.6, 0)
.dc Vdrive 0 3.3 0.01
.save v(source) v(package) v(pin) i(Vdrive)
.end
