Naveen-065/Evaluation_Research_Boards-/FMC_Eval_Board/output/fmc_verification/nt25_sources_R_1_0.cir

NT25 supply conflict sensitivity, assumed total series R=1.0 ohm
* Ideal regulated sources; this is NOT a reverse-current model of AMS1117.
Vcarrier carrier 0 3.3
Vlocal local 0 3.3
Rpath local carrier 1.0
.dc Vlocal 3.2 3.4 0.001
.save v(local) i(Vlocal)
.end
