Naveen-065/Evaluation_Research_Boards-/FMC_Eval_Board/output/j2_lpc_verification/i2c_opposed_pullups.cir

FMC I2C opposed pullups only
* Actual nominal resistor/rail values. U18 and carrier mux pass gates omitted.
* This calculates the resistor-network consequence, not complete bus operation.
Vcarrier carrier 0 3.3
Vlocal local 0 1.8
Rcarrier carrier bus 4.7k
Rlocal bus local 10k
.op
.save v(bus) i(Vlocal)
.end
