Naveen-065/Evaluation_Research_Boards-/(list of files, drawings)

Other design files:
FMC_Eval_Board/output/ain1_r9_validation/pcb_path_connectivity.json
FMC_Eval_Board/output/kc705_adc_clockdiag/evidence/pcb_clock_routes.json
