Naveen-065/Evaluation_Research_Boards-/FMC_Eval_Board/hardware/CaravelReRAM-SenseEval_v1.2F/CaravelReRAM-SenseEval.kicad_pcb

## KiCad design FMC_Eval_Board/hardware/CaravelReRAM-SenseEval_v1.2F/CaravelReRAM-SenseEval.kicad_pcb (2026-11-11)

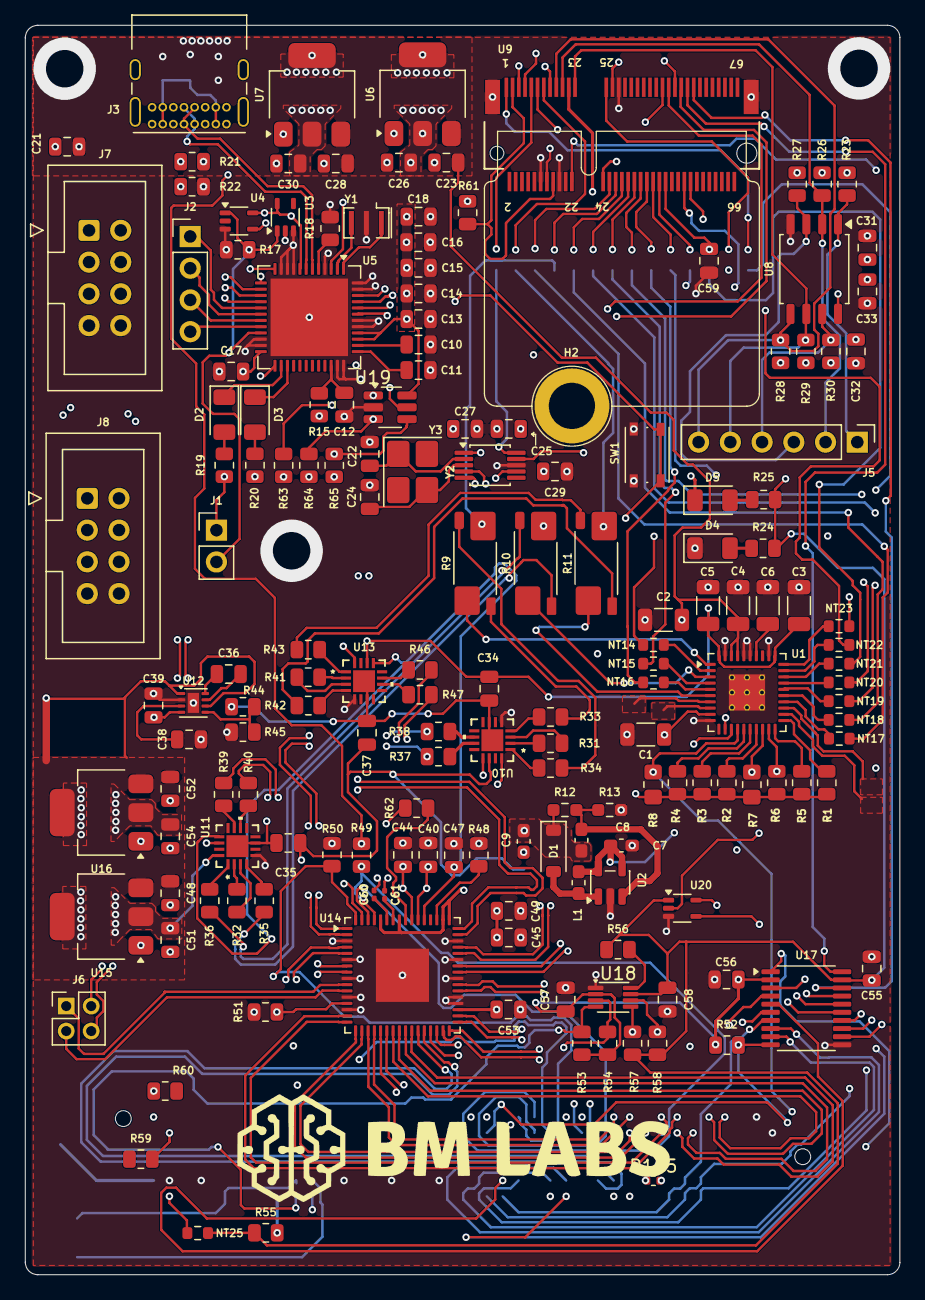
[picture p33: board CaravelReRAM-SenseEval.kicad_pcb from above]

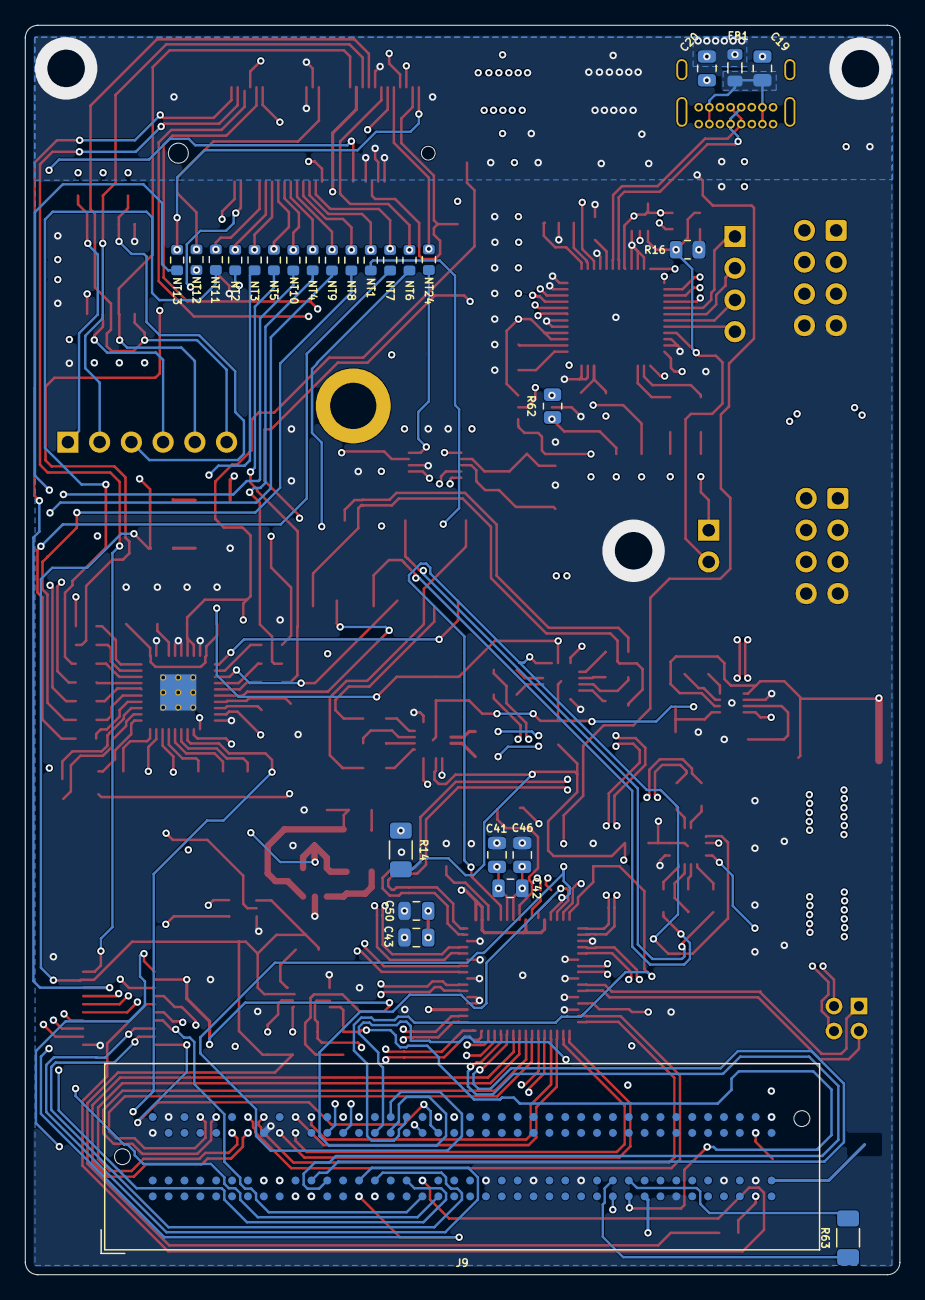
[picture p34: board CaravelReRAM-SenseEval.kicad_pcb from below]

Board: 6 copper layers, 70.0 x 100.0 mm, 194 parts (27 on the bottom side), 209 nets.

Parts:
C1, C2, C3, C4, C5, C6: 100nF; C_1206_3216Metric
C7, C9: GRM188R61E475KE11D; C_0603_1608Metric_Pad1.08x0.95mm_HandSolder
C8: CL10C4R7BB8NNNC; C_0603_1608Metric_Pad1.08x0.95mm_HandSolder
C10, C11, C13, C14, C15, C16, C17, C20, C27, C29, C32, C34, C35, C37, C40, C42, C43, C44, C45, C47, C49, C50, C53, C55, C56, C57, C58: 0.1uF; C_0805_2012Metric
C12, C19, C31: 0.01uF; C_0805_2012Metric
C18, C21, C23, C25, C26, C28, C30, C39, C41, C46, C48, C51, C52, C54: 10uF; C_0805_2012Metric
C22, C24: 18pF; C_0805_2012Metric
C33, C36, C59: 1uF; C_0805_2012Metric
C38: 4.7uF; C_0805_2012Metric
C60, C61: C_0201_0603Metric
D1: MBR0530; D_SOD-123
D2, D3, D4, D5: RED; LED_1206_3216Metric
FB1: 600R/0.5A; L_0805_2012Metric
H2: MICROMOD-Standoff; MicroMod-Standoff
J1: Conn_01x02_Pin; PinHeader_1x02_P2.54mm_Vertical
J2: Conn_01x04_Pin; PinHeader_1x04_P2.54mm_Vertical
J3: USB_C_Receptacle_USB2.0_16P; USB_C_Receptacle_GCT_USB4085
J5: Conn_01x06_Pin; PinHeader_1x06_P2.54mm_Vertical
J6: Conn_02x02_Odd_Even; PinHeader_2x02_P2.00mm_Vertical
J7, J8: Conn_02x04_Odd_Even; IDC-Header_2x04_P2.54mm_Vertical
J9: ASP-134604-01; Samtec_FMC_ASP-134604-01_4x40_Vertical
L1: MLZ1608N100LT000; L_0603_1608Metric_Pad1.05x0.95mm_HandSolder
NT1, NT2, NT3, NT4, NT5, NT6, NT7, NT8, NT9, NT10, NT11, NT12, NT13, NT14, NT15, NT16, NT17, NT18, NT19, NT20, NT21, NT22, NT23, NT24, NT25: NetTie_2; R_0603_1608Metric
R1, R2, R3, R4, R5, R6: 10k; R_0805_2012Metric
R7, R8: 10k; R_0805_2012Metric_Pad1.20x1.40mm_HandSolder
R9, R10, R11: 470R; R_Shunt_Vishay_WSK2512_6332Metric_T1.19mm
R12: MCT06030C1804FP500; R_0603_1608Metric_Pad0.98x0.95mm_HandSolder
R13: ERA-3AEB2053V; R_0603_1608Metric_Pad0.98x0.95mm_HandSolder
R14, R63#2: ERJ-8GEY0R00V; R_1206_3216Metric_Pad1.30x1.75mm_HandSolder
R15, R21, R22, R23, R26, R27, R28, R29, R30, R49, R50, R51, R52, R53, R54, R55, R56, R57, R58, R59, R60, R62, R63, R64, R65: 10K; R_0805_2012Metric
R16, R17, R24, R25, R31, R32, R41, R62#2: 1K; R_0805_2012Metric
R18: 12K 1%; R_0805_2012Metric
R19, R20, R33, R34, R35, R36, R37, R38, R39, R40, R42, R43, R46, R47: 150; R_0805_2012Metric
R44: 143k; R_0805_2012Metric
R45: 100k; R_0805_2012Metric
R48: 56.2k; R_0805_2012Metric
R61: 0; R_0805_2012Metric
R165: R_0402_1005Metric
SW1: 434133025816; SW_Push_1P1T_NO_Vertical_Wuerth_434133025816
U1: DAC81416RHAT; Texas_RHA0040D_VQFN-40-1EP_6x6mm_P0.5mm_EP2.9x2.9mm_Thermal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
U2: TPS61040DDC; SOT-23-5
U3, U4, U20: SN74LVC1G125DCKR; Texas_R-PDSO-G5_DCK-5
U5: FT232H; QFN-48-1EP_8x8mm_P0.5mm_EP6.2x6.2mm
U6, U15: AMS1117-3.3; SOT-223-3_TabPin2
U7, U16: AMS1117-1.8; SOT-223-3_TabPin2
U8: W25Q32FVSS; SOIC-8_5.3x5.3mm_P1.27mm
U9: M.2-CONNECTOR-E
U10, U11, U13: INA851RGTR; VQFN16_RGT_TEX
U12: LM27761; Texas_DSG0008A_WSON-8-1EP_2x2mm_P0.5mm_EP0.9x1.6mm
U14: ADS5282IRGCR; Texas_RGC0064B_VQFN-64-1EP_9x9mm_P0.5mm_EP4.25x4.25mm
U17: TXS0108EPW; TSSOP-20_4.4x6.5mm_P0.65mm
U18: VSSOP-8_2.3x2mm_P0.5mm
U19: 93LCxxBxxOT; SOT-23-6_Handsoldering
Y1: 12MHz; Resonator_SMD_Murata_CSTxExxV-3Pin_3.0x1.1mm
Y2: FA-238 25.0000MB-C3; Crystal_SMD_3225-4Pin_3.2x2.5mm_HandSoldering
Y3: Si5351A-B-GT; MSOP-10_3x3mm_P0.5mm

Connections:
3V3FMC: J9.C39, NT25.1
+1V8: C30.1, C56.2, C57.2, R49.1, R52.1, R53.1, R54.1, R62.1, U7.2 (VO), U9.14, U9.15, U9.35 (P27), U17.2 (VCCA), U18.2, U20.5 (VCC)
+1V8A: C1.2, C53.2, C54.1, R1.2, R2.2, R3.2, R4.2, R5.2, R6.2, R7.2, R8.2, U1.9 (VIO), U14.35 (LVDD), U16.2 (VO)
+3V3: C13.2, C14.2, C15.2, C16.2, C17.2, C18.1, C25.2, C26.1, C27.1, C29.2, C31.2, C32.1, C33.1, C55.2, C58.2, J1.1, NT12.1, NT25.2, R15.2, R19.2, R20.2, R23.2, R24.1, R25.1, R26.2, R27.2, R28.2, R29.2, R30.2, R55.1, R56.1, R57.1, R58.1, R61.2, R63.2, R64.2, R65.2, U3.5 (VCC), U4.5 (VCC), U5.3 (VPHY), U5.8 (VPLL), U5.12 (VCCIO), U5.24 (VCCIO), U5.39 (VCCD), U5.40 (VREGIN), U5.46 (VCCIO), U6.2 (VO), U8.8 (VCC), U9.5, U17.19 (VCCB), U18.7, U19.6, U20.1 (~OE), Y3.1 (VDD), Y3.7 (VDDO)
+3V3A: C43.2, C45.2, C49.1, C50.2, C51.1, U10.16 (VCLAMP+), U11.16 (VCLAMP+), U13.16 (VCLAMP+), U14.49 (AVDD), U14.50 (AVDD), U14.57 (AVDD), U14.60 (AVDD), U15.2 (VO)
+5V: C2.2, C4.2, C7.1, C20.2, C21.2, C23.1, C28.1, C48.1, C52.1, FB1.2, L1.1, U1.37 (VAA), U1.38 (VDD), U2.4 (EN), U2.5 (VIN), U6.3 (VI), U7.3 (VI), U12.1 (VIN), U12.6 (EN), U15.3 (VI), U16.3 (VI)
+12V: C3.2, C5.2, C34.2, C35.2, C37.2, R14.2, U1.31 (VCC), U1.40 (VCC), U10.14 (VS+), U11.14 (VS+), U13.14 (VS+)
-3VA: C34.1, C35.1, C37.1, C39.1, R44.1, U10.7 (VS-), U10.17 (EP_VS-), U11.7 (VS-), U11.17 (EP_VS-), U12.4 (VOUT), U13.7 (VS-), U13.17 (EP_VS-)
/ADC/C1RGN: R31.2, U10.2 (RG-)
/ADC/C1RGP: R31.1, U10.3 (RG+)
/ADC/C2RGN: R32.2, U11.2 (RG-)
/ADC/C2RGP: R32.1, U11.3 (RG+)
/ADC/C3RGN: R41.2, U13.2 (RG-)
/ADC/C3RGP: R41.1, U13.3 (RG+)
/Caravel_M.2/ACBUS0: J1.2, R16.2, R17.2, U3.1 (~OE), U4.1 (~OE), U5.21 (ACBUS0)
/Caravel_M.2/ACBUS1: SW1.2, U5.25 (ACBUS1), U9.7, U17.12 (B8)
/Caravel_M.2/ACBUS2: D2.1 (K), U5.26 (ACBUS2)
/Caravel_M.2/ACBUS3: D3.1 (K), U5.27 (ACBUS3)
/Caravel_M.2/ADBUS4: J2.1, U5.17 (ADBUS4)
/Caravel_M.2/ADBUS5: J2.2, U5.18 (ADBUS5)
/Caravel_M.2/ADBUS6: J2.3, U5.19 (ADBUS6)
/Caravel_M.2/ADBUS7: J2.4, U5.20 (ADBUS7)
/Caravel_M.2/Caravel_CSB: J5.1, R23.1, U8.1 (~CS), U9.11
/Caravel_M.2/Caravel_D0: J5.6, R28.1, U8.5 (SI(D0)), U9.17
/Caravel_M.2/Caravel_D1: J5.2, R26.1, U8.2 (SO(D1)), U9.19
/Caravel_M.2/Caravel_SCK: J5.5, R29.1, U8.6 (SCK), U9.23
/Caravel_M.2/FTDI_D+: J3.A6 (D+), J3.B6 (D+), U5.7 (DP)
/Caravel_M.2/FTDI_D-: J3.A7 (D-), J3.B7 (D-), U5.6 (DM)
/Caravel_M.2/SI5351_CLK0_RAW: NT24.1, Y3.10 (CLK0)
/Caravel_M.2/SI5351_CLK1_RAW: U20.2 (A), Y3.9 (CLK1)
/Caravel_M.2/USB_CS1: U5.16 (ADBUS3), U9.55 (P47)
/Caravel_M.2/USB_SCK_TXD: U3.2 (A), U5.13 (ADBUS0), U9.57 (P49)
/Caravel_M.2/USB_SI: U5.15 (ADBUS2), U9.51 (P43), U17.13 (B7)
/Caravel_M.2/USB_SO_RXD: U4.4 (Y), U5.14 (ADBUS1), U9.53 (P45)
/Caravel_M.2/VCCA: C11.2, U5.37 (VCCA)
/Caravel_M.2/VCCCORE: C10.2, U5.38 (VCCCORE)
/Caravel_M.2/XTAL_XA: C22.1, Y2.1, Y3.2 (XA)
/Caravel_M.2/XTAL_XB: C24.1, Y2.3, Y3.3 (XB)
/Caravel_M.2/gpio: D5.1 (K), U9.21
/Caravel_M.2/vddio: R61.1, U9.3, U9.16
/Caravel_M.2/xclk: NT24.2, U9.9
/Caravel_M.2/~FTDI_RST: C12.2, R15.1, U5.34 (~RESET)
/Caravel_M.2/~MEM_HOLD: J5.4, R30.1, U8.7 (~HOLD(D3))
/Caravel_M.2/~MEM_WP: J5.3, R27.1, U8.3 (~WP(D2))
/DAC/12VPWR: C8.1, C9.1, D1.1 (K), R12.1, R14.1
ADCLK_N: J9.H5, U14.24 (ADCLKN)
ADCLK_P: J9.H4, U14.23 (ADCLKP)
ADCVCM: C47.2, U10.13 (VOCM), U11.13 (VOCM), U13.13 (VOCM), U14.53 (VCM)
ADC_PD: J9.G18, R51.1, U14.13 (PD)
AIN1_N: R9.3, R34.1
AIN1_P: R9.2, R33.1
AIN2_N: R10.3, R36.1
AIN2_P: R10.2, R35.1
AIN3_N: R11.3, R43.1
AIN3_P: R11.2, R42.1
AIN4_N: J6.3, U14.11 (IN4N)
AIN4_P: J6.1, U14.10 (IN4P)
AIN5_N: J6.4, U14.39 (IN5N)
AIN5_P: J6.2, U14.38 (IN5P)
AIN6_N: J7.2, U14.42 (IN6N)
AIN6_P: J7.1, U14.41 (IN6P)
AIN7_N: J7.4, U14.45 (IN7N)
AIN7_P: J7.3, U14.44 (IN7P)
AIN8_N: J7.6, U14.48 (IN8N)
AIN8_P: J7.5, U14.47 (IN8P)
AMP1_N: R38.2, U14.2 (IN1N)
AMP1_P: R37.2, U14.1 (IN1P)
AMP2_N: R47.2, U14.5 (IN2N)
AMP2_P: R46.2, U14.4 (IN2P)
AMP3_N: R40.2, U14.8 (IN3N)
AMP3_P: R39.2, U14.7 (IN3P)
AQ1_ALM: R1.1, U1.21 (ALMOUT_N)
AQ1_C00: R9.1, U1.1 (OUT0)
AQ1_C01: NT14.1, U1.2 (OUT1)
AQ1_C02: R10.1, U1.3 (OUT2)
AQ1_C03: NT15.1, U1.4 (OUT3)
AQ1_C04: NT16.1, U1.5 (OUT4)
AQ1_C05: R11.1, U1.6 (OUT5)
AQ1_C09: NT17.1, U1.24 (OUT9)
AQ1_C10: NT18.1, U1.25 (OUT10)
AQ1_C11: NT19.1, U1.26 (OUT11)
AQ1_C12: NT20.1, U1.27 (OUT12)
AQ1_C13: NT21.1, U1.28 (OUT13)
AQ1_C14: NT22.1, U1.29 (OUT14)
AQ1_C15: NT23.1, U1.30 (OUT15)
AQ1_MOSI: J9.G13, U1.13 (SDI)
AQ1_SCK: J9.G12, U1.12 (SCLK)
AQ1_TO0: R4.1, U1.15 (TOGGLE0)
AQ1_TO1: R3.1, U1.16 (TOGGLE1)
AQ1_TO2: R2.1, U1.17 (TOGGLE2)
AQ1_nCLR: R5.1, U1.20 (CLR_N)
AQ1_nCS: J9.H13, R8.1, U1.14 (CS_N)
AQ1_nLDAC: J9.H14, R7.1, U1.18 (LDAC_N)
AQ1_nRST: J9.H20, R6.1, U1.19 (RESET_N)
BIAS_COMP2: NT9.1, NT19.2
DC_BIAS: NT11.1, NT21.2
FPGA_LOE: J9.G19, R52.2, U17.10 (OE)
FPGA_MCLKIN_C_N: C60.1, U14.59 (CLKN)
FPGA_MCLKIN_C_P: C61.1, U14.58 (CLKP)
FPGA_MCLKIN_N: C60.2, J9.D9, R165.1
FPGA_MCLKIN_P: C61.2, J9.D8, R165.2
FPGA_RX: J9.C14, U17.3 (A2)
FPGA_SCK: J9.G15, U14.63 (SCLK)
FPGA_SCL: J9.C30, R54.2, U18.3
FPGA_SDA: J9.C31, R53.2, U18.4
FPGA_SDATA: J9.G16, U14.62 (SDATA)
FPGA_TX: J9.C15, U17.1 (A1)
FPGA_nADCRST: J9.H17, R50.2, U14.64 (*RESET)
FPGA_nCS: J9.H16, R49.2, U14.61 (*CS)
FTEECLKI: R65.1, U5.44 (EECLK), U19.4
FTEEDATA: R62#2.2, R64.1, U5.43 (EEDATA), U19.3
GND: C1.1, C2.1, C3.1, C4.1, C5.1, C6.1, C7.2, C9.2, C10.1, C11.1, C12.1, C13.1, C14.1, C15.1, C16.1, C17.1, C18.2, C19.2, C20.1, C21.1, C22.2, C23.2, C24.2, C25.1, C26.2, C27.2, C28.2, C29.1, C30.2, C31.1, C32.2, C33.2, C38.2, C39.2, C40.1, C41.2, C43.1, C44.1, C45.1, C46.2, C47.1, C48.2, C49.2, C50.1, C51.2, C52.2, C53.1, C54.2, C55.1, C56.1, C57.1, C58.1, C59.2, D4.1 (K), J3.A1 (GND), J3.A12 (GND), J3.B1 (GND), J3.B12 (GND), J3.SH (SHIELD), J7.7, J7.8, J8.7, J8.8, J9.C34, J9.D22, J9.D25, J9.D28, J9.D37, J9.D39, J9.G1, J9.G8, J9.H2, R13.2, R16.1, R17.1, R18.1, R21.2, R22.2, R45.2, R48.2, R50.1, R51.2, SW1.1, U1.10 (GND), U1.32 (VSS), U1.35 (REFGND), U1.36 (GND), U1.39 (VSS), U1.41 (EP), U2.2 (GND), U3.3 (GND), U4.3 (GND), U5.4 (AGND), U5.9 (AGND), U5.10 (GND), U5.11 (GND), U5.22 (GND), U5.23 (GND), U5.35 (GND), U5.36 (GND), U5.41 (AGND), U5.42 (TEST), U5.47 (GND), U5.48 (GND), U5.49, U6.1 (GND), U7.1 (GND), U8.4 (GND), U9.12, U9.18, U9.37 (P29), U9.A1 (GND), U9.A2 (GND), U10.5 (VCLAMP-), U11.5 (VCLAMP-), U12.2 (GND), U12.9 (PAD), U13.5 (VCLAMP-), U14.3 (AVSS), U14.6 (AVSS), U14.9 (AVSS), U14.12 (LVSS), U14.14 (LVSS), U14.36 (LVSS), U14.37 (AVSS), U14.40 (AVSS), U14.43 (LVSS), U14.46 (AVSS), U14.EP, U15.1 (GND), U16.1 (GND), U17.11 (GND), U18.1, U19.2, U20.3 (GND), Y1.2, Y3.8 (GND)
INT/~EXT: R62.2, U14.56 (INT/*EXT)
IREF: NT7.1, NT17.2
ISET: R48.1, U14.51 (ISET)
LCLK_N: J9.G7, U14.26 (LCLKN)
LCLK_P: J9.G6, U14.25 (LCLKP)
unnamed: D1.2 (A), L1.2, U2.1 (SW)
unnamed: D2.2 (A), R19.1
unnamed: D3.2 (A), R20.1
unnamed: D4.2 (A), R24.2
unnamed: D5.2 (A), R25.2
unnamed: J3.A5 (CC1), R22.1
unnamed: J3.B5 (CC2), R21.1
unnamed: J9.C32, R55.2
unnamed: J9.G39, R59.2
unnamed: J9.H40, R60.1
unnamed: C6.2, U1.34 (REFCMP)
unnamed: C8.2, R12.2, R13.1, U2.3 (FB)
unnamed: R18.2, U5.5 (REF)
unnamed: U5.1 (XCSI), Y1.1
unnamed: U5.2 (XCSO), Y1.3
unnamed: R33.2, U10.4 (IN+)
unnamed: R34.2, U10.1 (IN-)
unnamed: R37.1, U10.11 (OUT+)
unnamed: R38.1, U10.10 (OUT-)
unnamed: R35.2, U11.4 (IN+)
unnamed: R36.2, U11.1 (IN-)
unnamed: R39.1, U11.11 (OUT+)
unnamed: R40.1, U11.10 (OUT-)
unnamed: C36.1, U12.8 (C+)
unnamed: C36.2, U12.7 (C-)
unnamed: C38.1, U12.3 (CPOUT)
unnamed: R44.2, R45.1, U12.5 (VFB)
unnamed: R42.2, U13.4 (IN+)
unnamed: R43.2, U13.1 (IN-)
unnamed: R46.1, U13.11 (OUT+)
unnamed: R47.1, U13.10 (OUT-)
unnamed: R56.2, U18.8
OUT1_N: J9.H8, U14.16 (OUT1N)
OUT1_P: J9.H7, U14.15 (OUT1P)
OUT2_N: J9.G10, U14.18 (OUT2N)
OUT2_P: J9.G9, U14.17 (OUT2P)
OUT3_N: J9.H11, U14.20 (OUT3N)
OUT3_P: J9.H10, U14.19 (OUT3P)
OUT4_N: J9.C11, U14.22 (OUT4N)
OUT4_P: J9.C10, U14.21 (OUT4P)
OUT5_N: J9.D12, U14.28 (OUT5N)
OUT5_P: J9.D11, U14.27 (OUT5P)
OUT6_N: J8.2, U14.30 (OUT6P)
OUT6_P: J8.1, U14.29 (OUT6N)
OUT7_N: J8.4, U14.32 (OUT7N)
OUT7_P: J8.3, U14.31 (OUT7P)
OUT8_N: J8.6, U14.34 (OUT8N)
OUT8_P: J8.5, U14.33 (OUT8P)
R62A: J9.D30, R63#2.1
R62B: J9.D31, R63#2.2
READY_I: J9.D14, U17.8 (A7)
REFB: C40.2, C41.1, C42.2, U14.54 (REFB)
REFT: C42.1, C44.2, C46.1, U14.55 (REFT)
RESET_B: J9.D15, U17.9 (A8)
SCAN_CC: J9.C19, U17.6 (A5)
SCAN_SE: J9.D17, U17.4 (A3)
SCAN_SI: J9.C18, U17.7 (A6)
SCAN_TM: J9.D18, U17.5 (A4)
SI5351_CLK1_1V8: J9.H19, U20.4 (Y)
SI5351_SCL: R58.2, U18.6, Y3.5 (SDA)
SI5351_SDA: R57.2, U18.5, Y3.4 (SCL)
U19P1: R62#2.1, U19.1
VBIAS: NT10.1, NT20.2
VBUS: C19.1, FB1.1, J3.A4 (VBUS), J3.A9 (VBUS), J3.B4 (VBUS), J3.B9 (VBUS)
VCCD2: NT13.1, NT23.2
VCC_READ: NT1.1, R9.4
VCC_RESET: NT6.1, R11.4
VCC_SET: NT3.1, R10.4
VCC_WL_READ: NT2.1, NT14.2
VCC_WL_RESET: NT5.1, NT16.2
VCC_WL_SET: NT4.1, NT15.2
VCOMP: NT8.1, NT18.2
mprj_io[5]_ser_rx: U9.59 (P51), U17.20 (B1)
mprj_io[6]_ser_tx: U9.61 (P53), U17.18 (B2)
mprj_io[21]: U9.60 (P52), U17.17 (B3)
mprj_io[22]: U9.58 (P50), U17.14 (B6)
mprj_io[25]: C59.1, NT11.2, U9.52 (P44)
mprj_io[26]: NT2.2, U9.50 (P42)
mprj_io[27]: NT3.2, U9.48 (P40)
mprj_io[28]: NT5.2, U9.46 (P38)
mprj_io[29]: NT10.2, U9.44 (P36)
mprj_io[30]: NT4.2, U9.42 (P34)
mprj_io[31]: NT9.2, U9.40 (P32)
mprj_io[32]: NT8.2, U9.38 (P30)
mprj_io[33]: NT1.2, U9.36 (P28)
mprj_io[34]: NT7.2, U9.34 (P26)
mprj_io[35]: U9.32 (P24), U17.15 (B5)
mprj_io[36]: U9.22, U17.16 (B4)
vccd2: NT13.2, U9.1
vdda1: NT12.2, NT22.2, U9.33 (P25)
vdda2: NT6.2, U9.13
~FTEECS: R63.1, U5.45 (EECS), U19.5
