Naveen-065/Evaluation_Research_Boards-/(commit log)

2026-08-27 Set default read voltage to 0.5 V
2026-10-20 Archive FMC evaluation board system, bitstreams and validation
2026-10-23 Add latest ZCU106 HRS LRS and voltage plots
2026-11-07 Document WB RESET PWM/DAC direction reversal
